karldprice/M_Dsgn/README.txt

M_Dsgn
======

All stock part CAD models in the storck_parts directory.
Name your stock parts [part name]_[website]_[parts number]
No spaces in file or directory names!

eg: ball_bearing_mc_347103438972.sldprt

MC - McMaster 
SP - SmallParts - smallparts.com
DK - Digikey
SI - sdp-si - sdp-si.com
