karldprice/M_Dsgn/Design1/main2.SLDASM

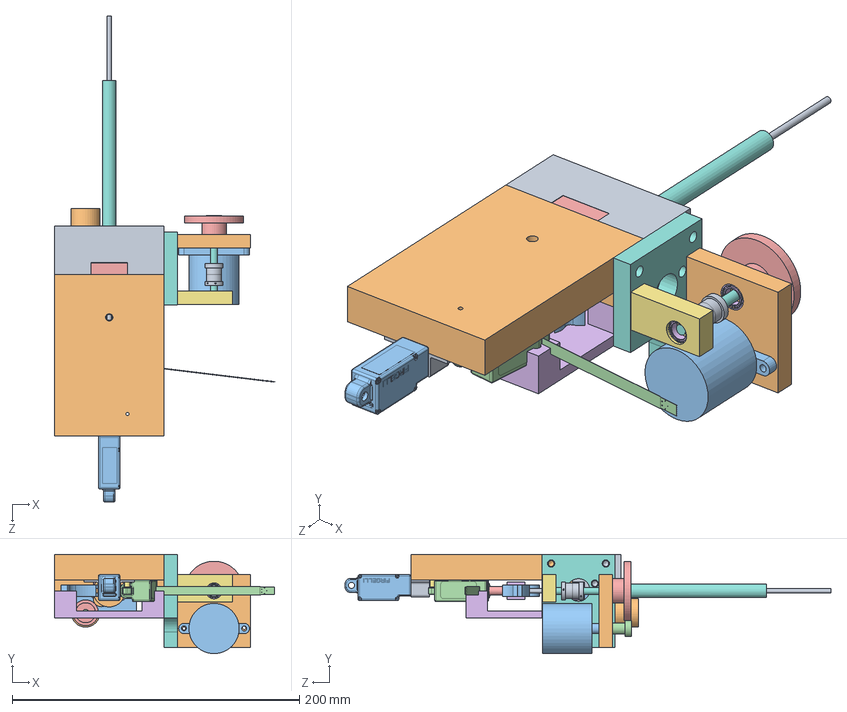
[picture p36: CAD file, 2012-11-09]
Design1/main2.SLDASM
153.2 x 69.1 x 338.4 mm
EnclosureBottom2_tip
EnclosureBottom2-base
needle_toggle_modified
pq-12-20_closed1
pq-12-20_closed2
Pinch_Arm2 x 2
LinActSpacer
ToolShaft
JawShaft
Gearbox
linAct_L12_base
linAct_L12_30mm
ShaftGuide
ShaftGuideTop
ShaftGuidePlate x 2
shaft_of_karl_3
collar_3 x 2
bracket_3
stepper_motor_35mm_DK_P14336-ND
gear_d0_5_SP_32-014B156
gear_d1_688_SP_32-052B313
ball_bearing_05_MC_57155K358 x 2
bracket_short_3
baseplate_3
actBracket
stepper_motor_20mm_DK_P14334-ND
MotorBracket
roll_extension
gear_d0_708_SP_48-034b187
TogglePivotCap
