karldprice/M_Dsgn/Final/Grip/GripperAssem.SLDASM

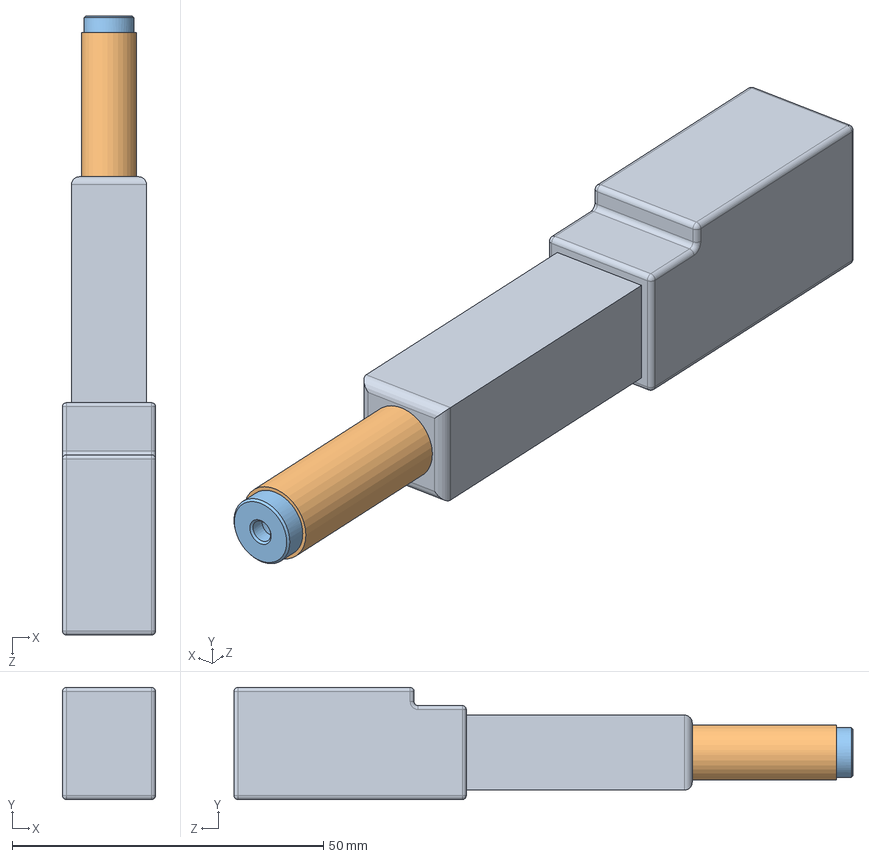
[picture p37: CAD file, 2013-04-07]
Final/Grip/GripperAssem.SLDASM
15.0 x 18.0 x 99.5 mm
L12_linAct_Body
L12_linAct_Shaft
Gripper_thrustFitting
