karldprice/M_Dsgn/Final/Needle/NeedleAssem.SLDASM

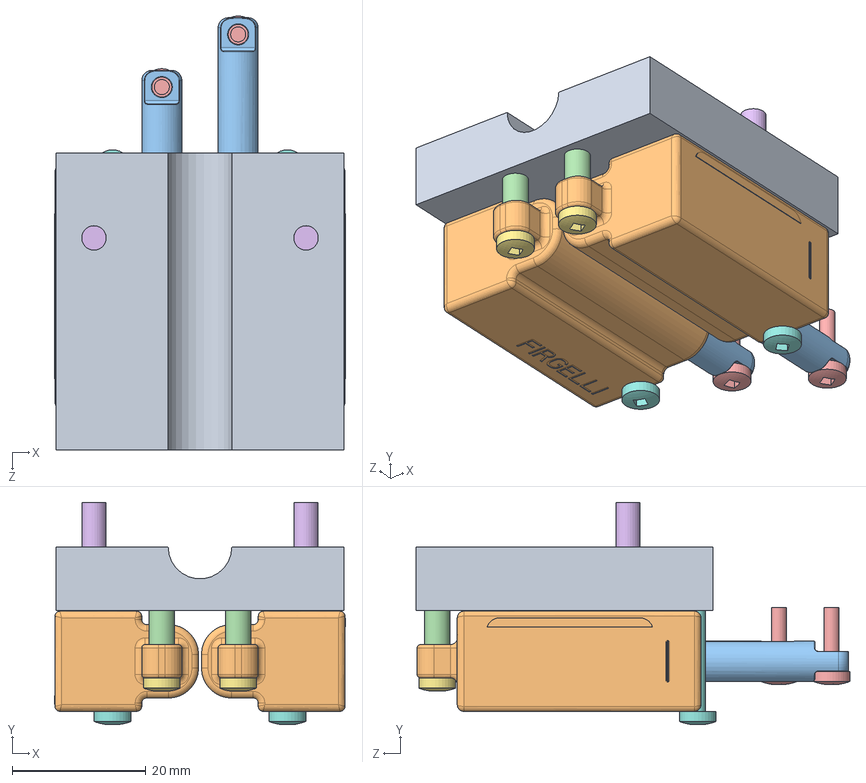
[picture p38: CAD file, 2013-04-07]
Final/Needle/NeedleAssem.SLDASM
43.6 x 33.3 x 65.0 mm
Needle_Block
pq-12-20_closed1 x 2
pq-12-20_closed2 x 2
LinActSpacer x 2
Screw_4-40x0375 x 2
CapScrew_6-32x0500 x 2
Screw_4-40x0625 x 2
Screw_4-40x0750 x 2
