karldprice/M_Dsgn/Final/OuterRoll/OuterRoll_v2.SLDASM

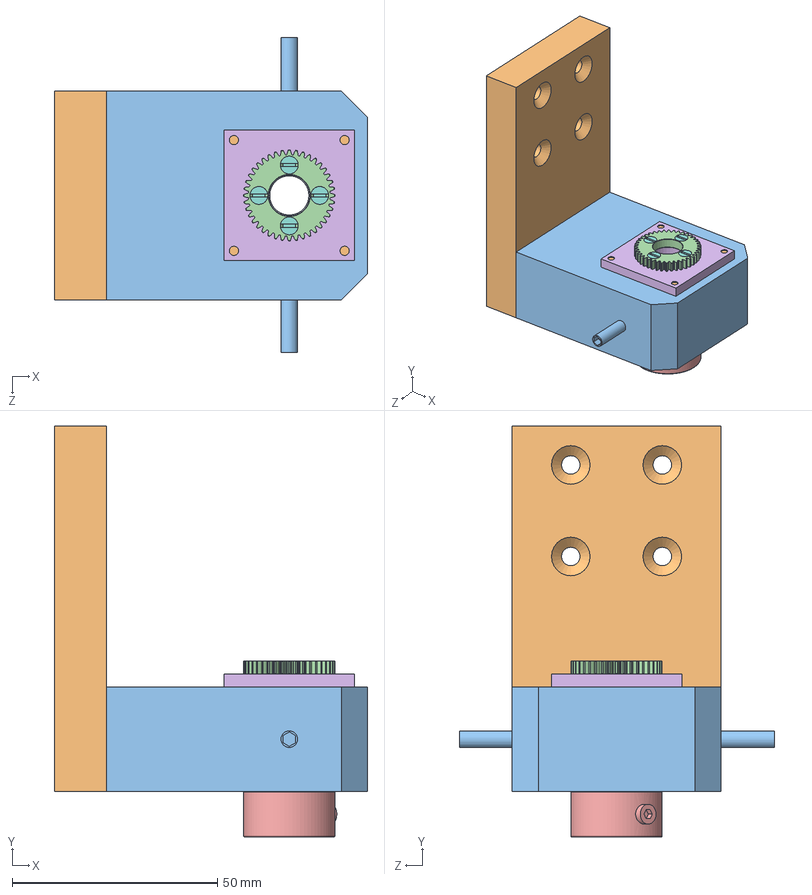
[picture p39: CAD file, 2013-04-07]
Final/OuterRoll/OuterRoll_v2.SLDASM
76.2 x 100.0 x 76.7 mm
DensoMount_Plate
OuterRoll_Base
MOD_gear_sdpi_s1268z-048a040
collar_mc_60475K680
OuterRoll_gearPlate
ball_bearing_mc_6383K160 x 2
FlatScrew_2-56x0250 x 4
CapScrew_10-32x1250 x 3
CapScrew_4-40x1000 x 4
Set_10-32x0750 x 2
