karldprice/M_Dsgn/Final/Pitch/PitchMotorAssem.SLDASM

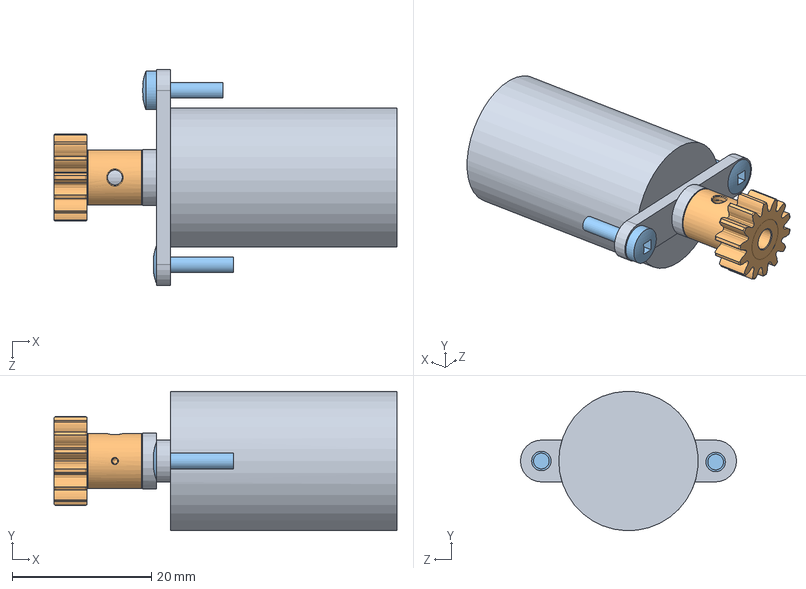
[picture p40: CAD file, 2013-04-07]
Final/Pitch/PitchMotorAssem.SLDASM
49.2 x 20.0 x 31.0 mm
stepper_motor_20mm_DK_P14334-ND
gear_p32-14_SPD-A1T2-Y32014
Screw_4-40x0375 x 2
