karldprice/M_Dsgn/Final/Stack_v2_wMount.SLDASM

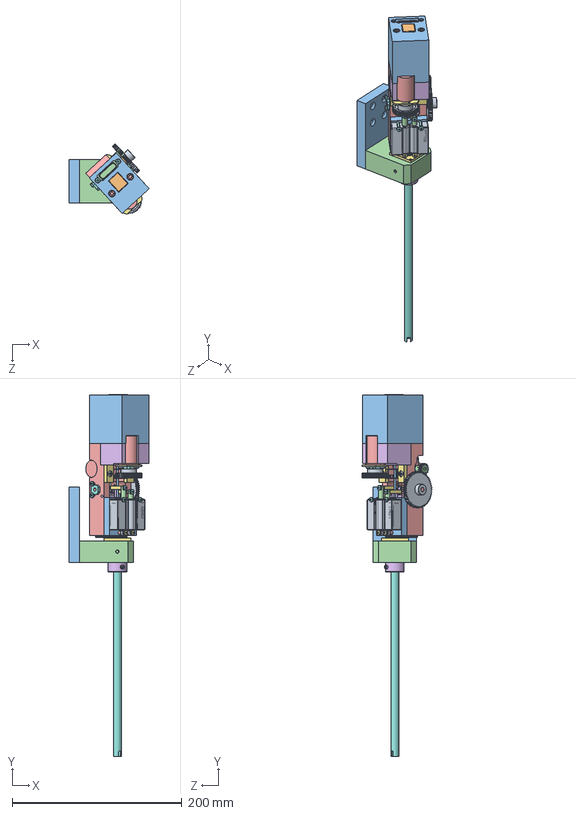
[picture p41: CAD file, 2013-04-07]
Final/Stack_v2_wMount.SLDASM
94.6 x 426.3 x 82.6 mm
DensoMount_Plate
OuterRoll_Base
MOD_gear_sdpi_s1268z-048a040
collar_mc_60475K680
OuterRoll_gearPlate
ball_bearing_mc_6383K160 x 2
FlatScrew_2-56x0250 x 4
CapScrew_10-32x1250 x 3
CapScrew_4-40x1000 x 4
Set_10-32x0750 x 2
EnclosureBottom
Pitch_GuideBar
GearboxBracket x 2
Screw_4-40x0375 x 8
PanScrew_6-32x0375 x 2
PanScrew_6-32x1250 x 2
JawShaft
Gearbox
gearboxGear_m07t16
NeedleControlRod x 2
Needle_Coupler x 2
ssToolShaft
Nut_2-56 x 2
L12_linAct_Body
L12_linAct_Shaft
Gripper_thrustFitting
stepper_motor_20mm_DK_P14334-ND x 3
EnclosureCap
EncoderMounting x 2
RotaryEncoder_237T x 3
gear_m07-42_a-1m-2myz07042
Set_4-40x0125 x 7
Screw_4-40x0500 x 2
gear_p32-14_SPD-A1T2-Y32014
Pitch_Shaft
Pitch_Spool x 2
Ball_Bearing_AXA1221 x 2
Pitch_Collar
gear_p32-52_SPD-S1084Z-032DS052
Pitch_GearSpacer
Needle_Block
pq-12-20_closed1 x 2
pq-12-20_closed2 x 2
LinActSpacer x 2
CapScrew_6-32x0500 x 2
Screw_4-40x0625 x 2
Screw_4-40x0750 x 2
gear_sdpi_s1063z-048a040
Screw_4-40x0250 x 2
WireCap
hdmi_WM5715-ND
CapScrew_8-32x2250 x 2
