karldprice/M_Dsgn/Final/StockParts/Motors/L12_linAct.SLDASM

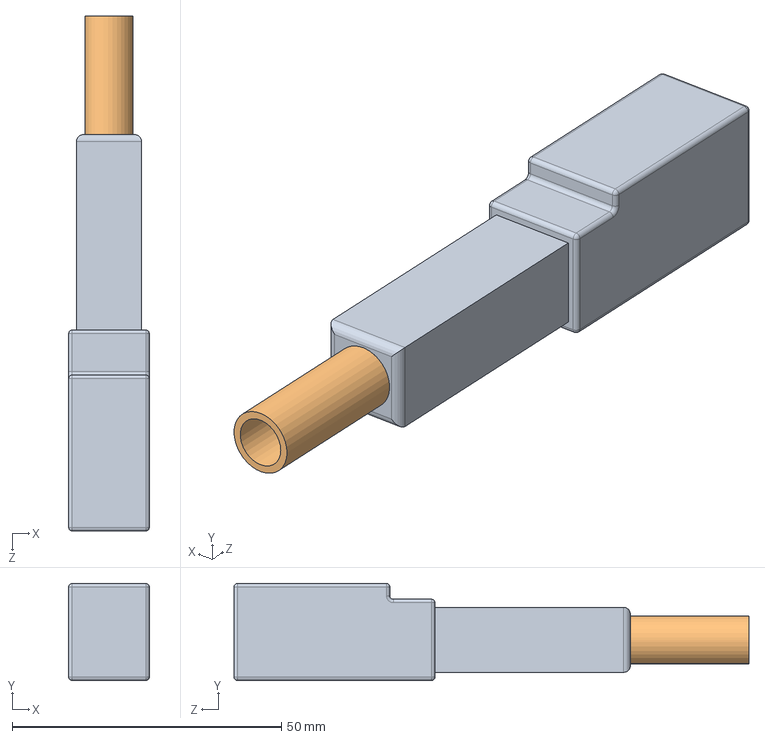
[picture p42: CAD file, 2013-04-07]
Final/StockParts/Motors/L12_linAct.SLDASM
15.0 x 18.0 x 95.7 mm
L12_linAct_Body
L12_linAct_Shaft
