karldprice/M_Dsgn/Final/Tool/ToolShaft.SLDASM

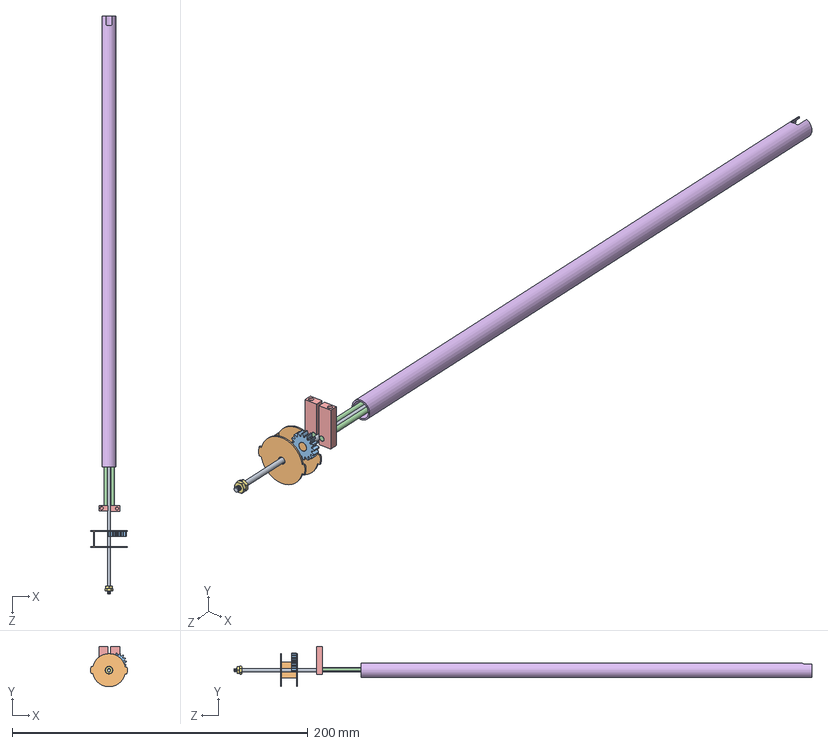
[picture p43: CAD file, 2013-04-07]
Final/Tool/ToolShaft.SLDASM
24.9 x 27.4 x 390.8 mm
JawShaft
Gearbox
gearboxGear_m07t16
NeedleControlRod x 2
Needle_Coupler x 2
ssToolShaft
Nut_2-56 x 2
