karldprice/M_Dsgn/Final/WireCap/WireCapAssem.SLDASM

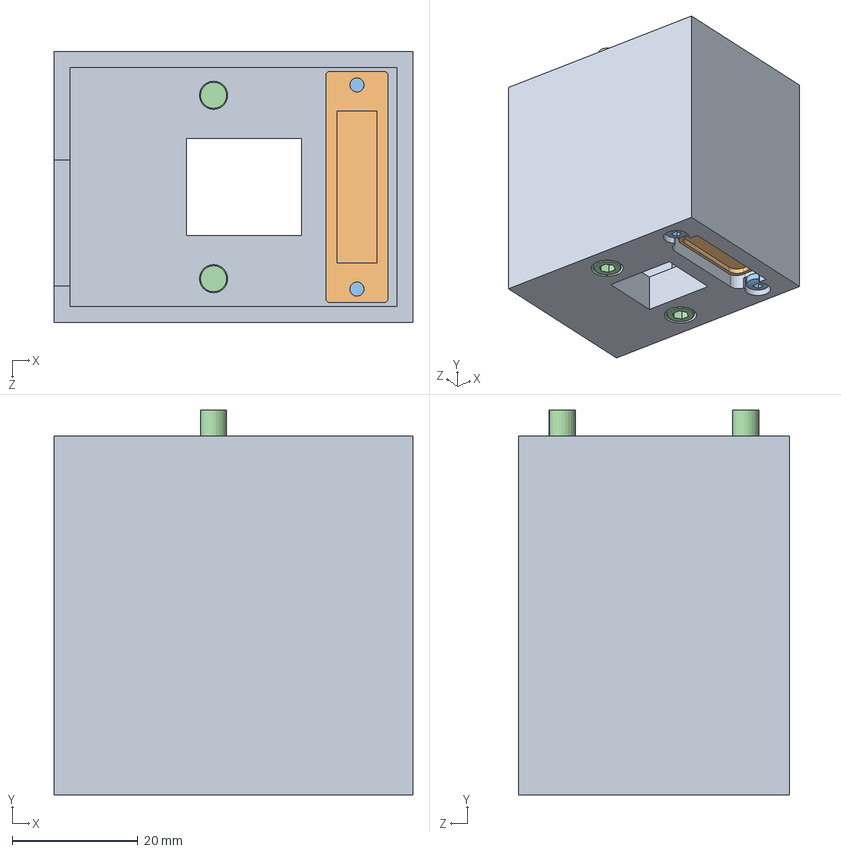
[picture p44: CAD file, 2013-04-07]
Final/WireCap/WireCapAssem.SLDASM
57.1 x 61.3 x 43.2 mm
WireCap
hdmi_WM5715-ND
Screw_4-40x0375 x 2
CapScrew_8-32x2250 x 2
