karldprice/M_Dsgn/Stack_v2/BodyPitch/BodyPitchAssem.SLDASM

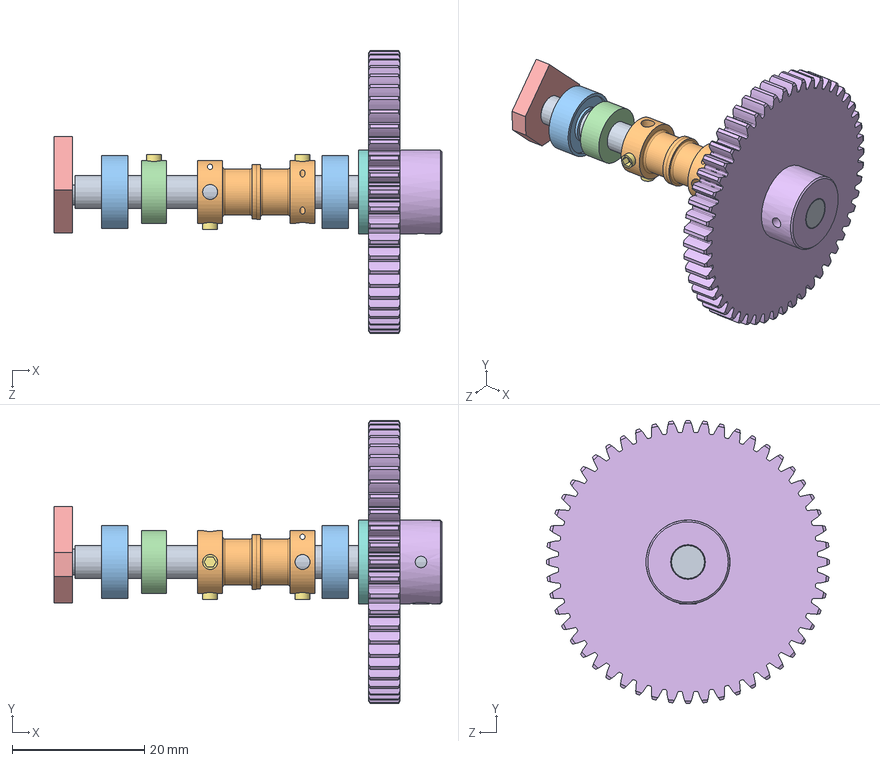
[picture p45: CAD file, 2013-02-25]
Stack_v2/BodyPitch/BodyPitchAssem.SLDASM
58.7 x 42.9 x 42.9 mm
pitchShaft
pitchCollar x 2
Ball_Bearing_AXA1221 x 2
pitchRetainer
RotaryEncoder_237T
gear_p32-52_SPD-S1084Z-032DS052
Set_4-40x0125 x 5
PitchSpacer
