karldprice/M_Dsgn/Stack_v2/Grip/GripperAssem.SLDASM

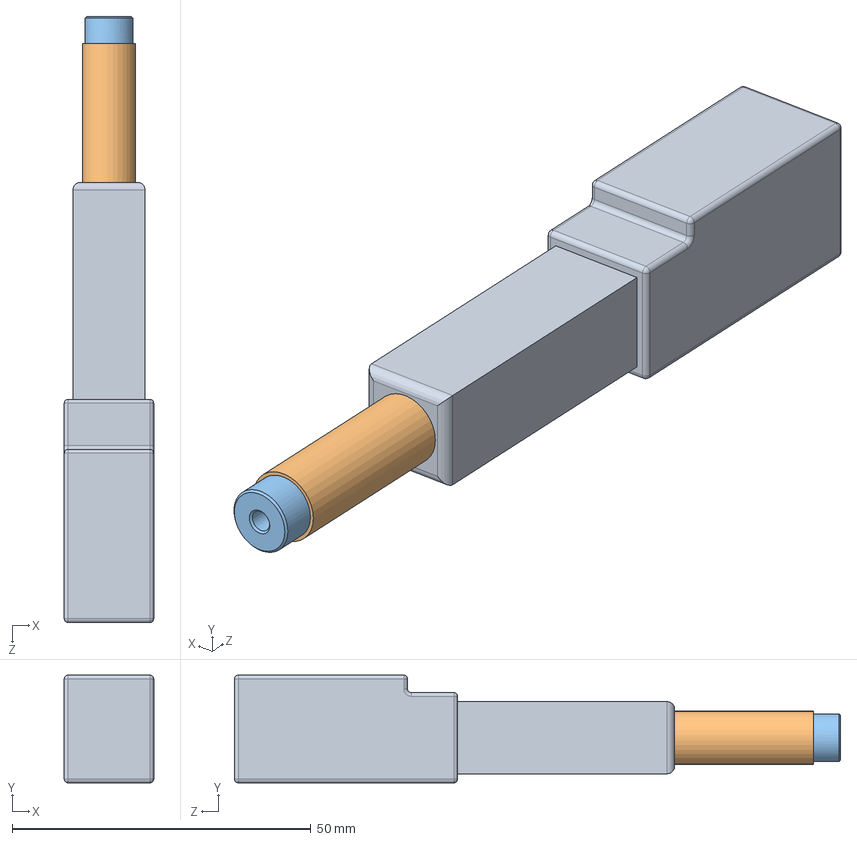
[picture p46: CAD file, 2013-02-13]
Stack_v2/Grip/GripperAssem.SLDASM
15.0 x 18.0 x 101.4 mm
L12_linAct_Body_cust
L12_linAct_Shaft_cust
actFitting_thrust
