karldprice/M_Dsgn/Stack_v2/Needle/ToggleActuators.SLDASM

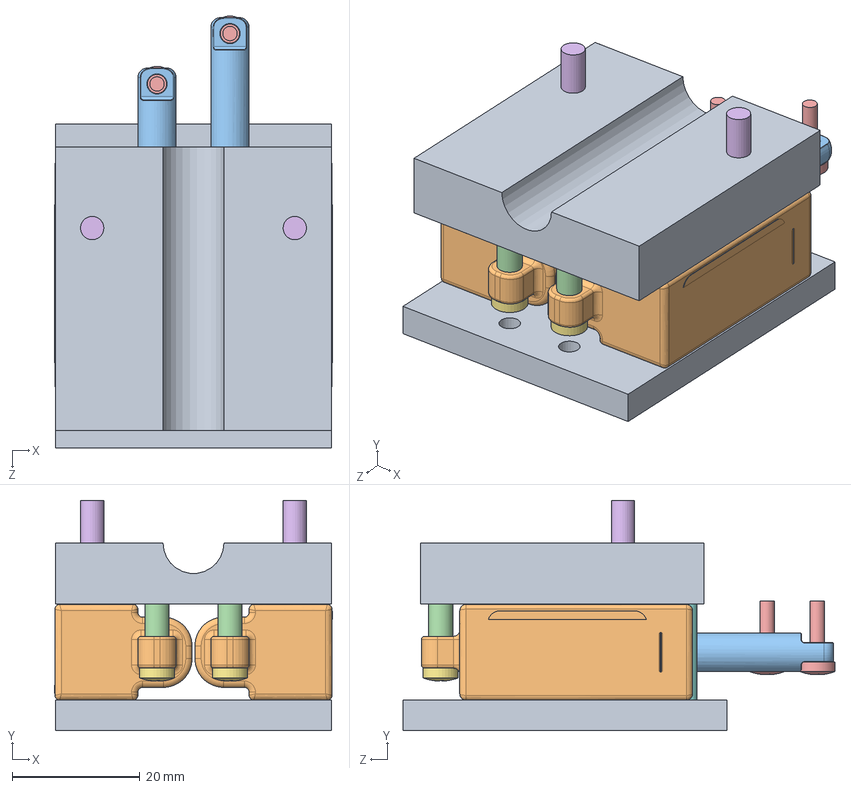
[picture p47: CAD file, 2013-02-14]
Stack_v2/Needle/ToggleActuators.SLDASM
43.6 x 36.0 x 67.7 mm
LinActBlock
pq-12-20_closed1 x 2
pq-12-20_closed2 x 2
LinActSpacer x 2
Screw_4-40x0375 x 2
CapScrew_6-32x0500 x 2
Screw_4-40x0625 x 2
Screw_4-40x0750 x 2
LinActCover
