karldprice/M_Dsgn/Stock_Parts/LinActs/linear_actuator_RS_pq-12-20.SLDASM

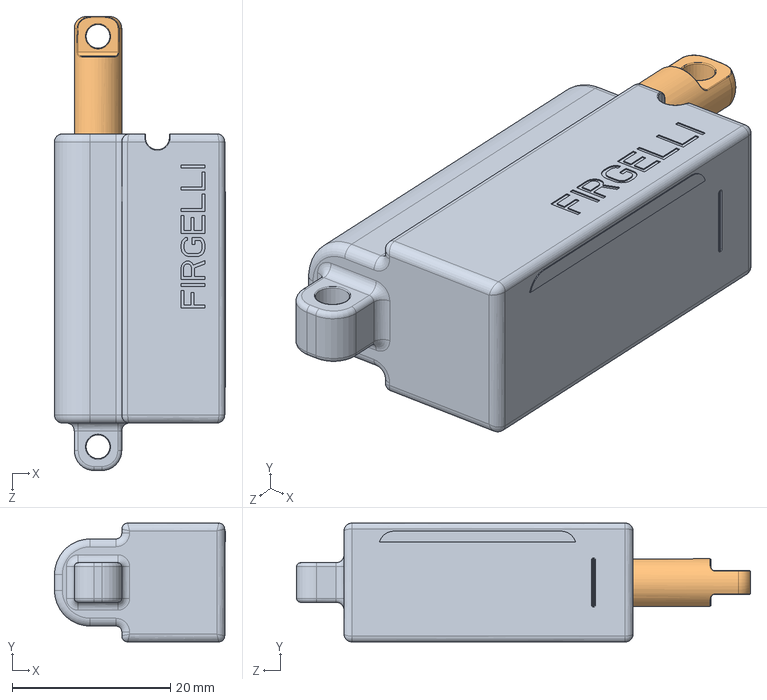
[picture p48: CAD file, 2013-02-03]
Stock_Parts/LinActs/linear_actuator_RS_pq-12-20.SLDASM
21.6 x 15.0 x 57.3 mm
pq-12-20_closed1
pq-12-20_closed2
