karldprice/M_Dsgn/Final/OuterRoll/OuterRollMotor.SLDASM

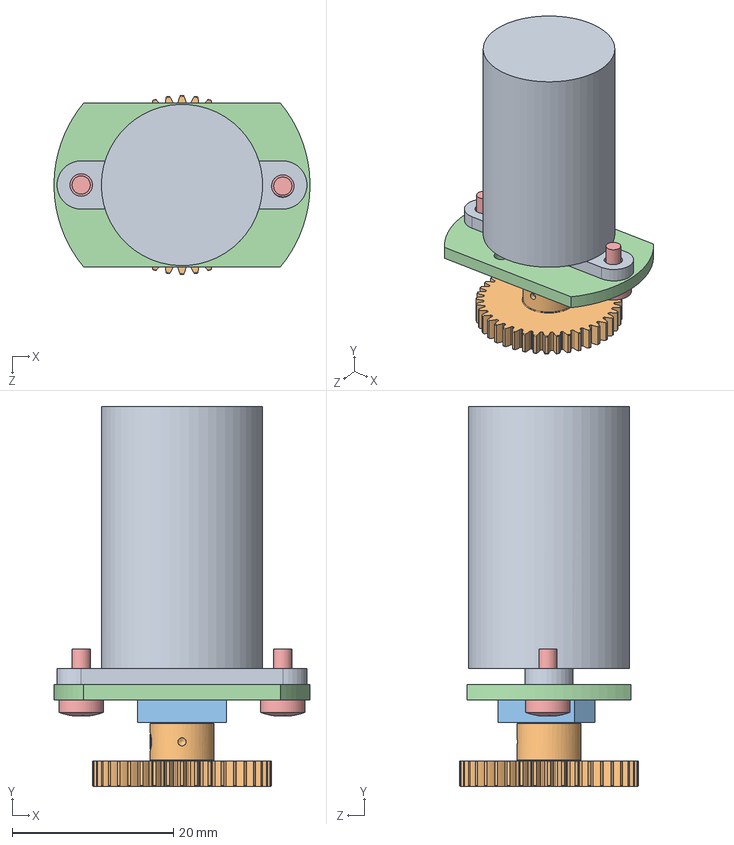
[picture p49: CAD file, 2013-04-07]
Final/OuterRoll/OuterRollMotor.SLDASM
31.7 x 47.1 x 22.2 mm
stepper_motor_20mm_DK_P14334-ND
gear_sdpi_s1063z-048a040
RotaryEncoder_237T
EncoderMounting
Screw_4-40x0250 x 2
