karldprice/M_Dsgn/Final/Roll/WristRoll.SLDASM

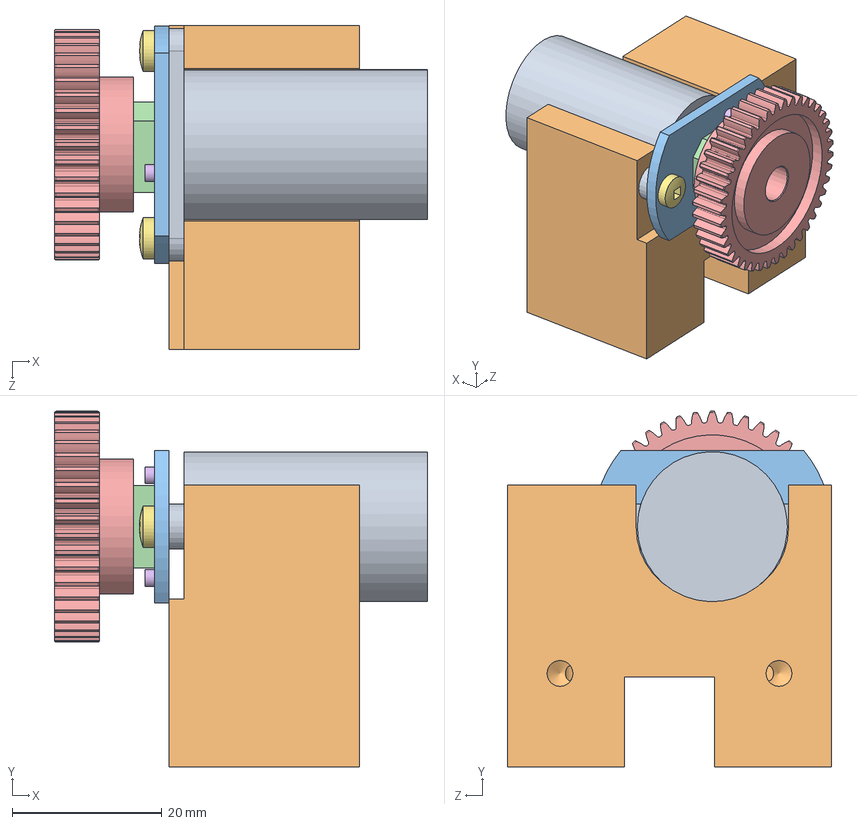
[picture p50: CAD file, 2013-04-07]
Final/Roll/WristRoll.SLDASM
49.7 x 47.4 x 43.2 mm
stepper_motor_20mm_DK_P14334-ND
EnclosureCap
EncoderMounting
RotaryEncoder_237T
gear_m07-42_a-1m-2myz07042
Set_4-40x0125 x 2
Screw_4-40x0500 x 2
