karldprice/M_Dsgn/Final/Stack_v2.SLDASM

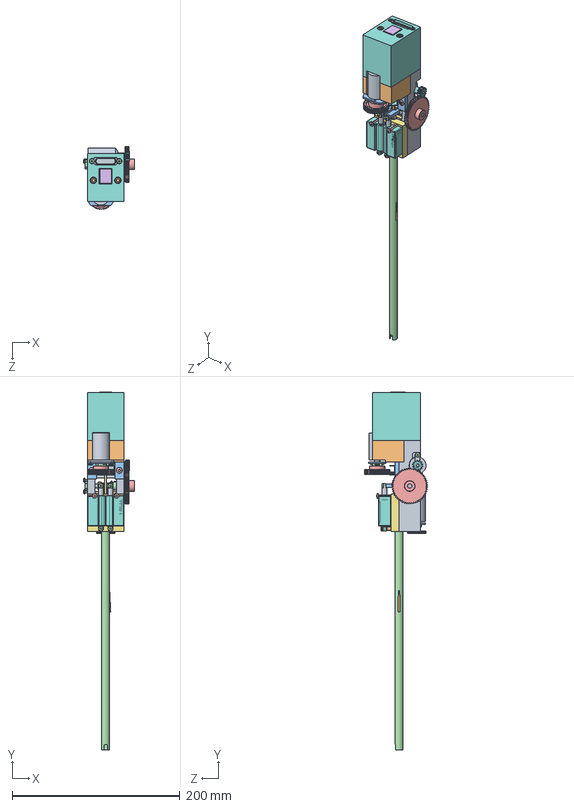
[picture p51: CAD file, 2013-04-07]
Final/Stack_v2.SLDASM
60.7 x 426.3 x 75.5 mm
EnclosureBottom
Pitch_GuideBar
GearboxBracket x 2
Screw_4-40x0375 x 8
PanScrew_6-32x0375 x 2
PanScrew_6-32x1250 x 2
JawShaft
Gearbox
gearboxGear_m07t16
NeedleControlRod x 2
Needle_Coupler x 2
ssToolShaft
Nut_2-56 x 2
L12_linAct_Body
L12_linAct_Shaft
Gripper_thrustFitting
stepper_motor_20mm_DK_P14334-ND x 3
EnclosureCap
EncoderMounting x 2
RotaryEncoder_237T x 3
gear_m07-42_a-1m-2myz07042
Set_4-40x0125 x 7
Screw_4-40x0500 x 2
gear_p32-14_SPD-A1T2-Y32014
Pitch_Shaft
Pitch_Spool x 2
Ball_Bearing_AXA1221 x 2
Pitch_Collar
gear_p32-52_SPD-S1084Z-032DS052
Pitch_GearSpacer
Needle_Block
pq-12-20_closed1 x 2
pq-12-20_closed2 x 2
LinActSpacer x 2
CapScrew_6-32x0500 x 2
Screw_4-40x0625 x 2
Screw_4-40x0750 x 2
gear_sdpi_s1063z-048a040
Screw_4-40x0250 x 2
WireCap
hdmi_WM5715-ND
CapScrew_8-32x2250 x 2
