karldprice/M_Dsgn/Final/Tool/GearBoxAssem.SLDASM

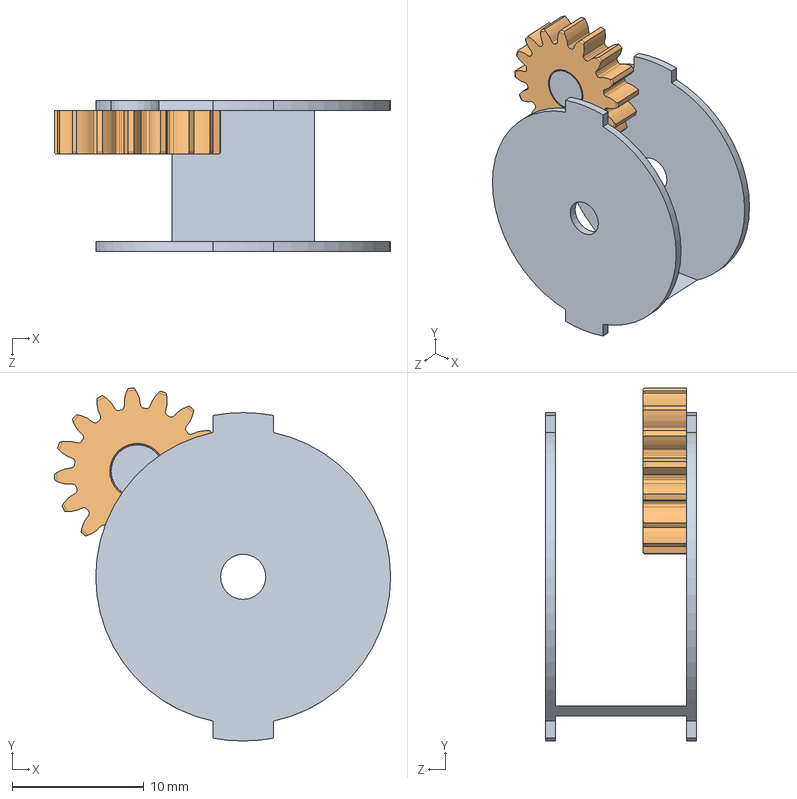
[picture p52: CAD file, 2013-04-07]
Final/Tool/GearBoxAssem.SLDASM
25.5 x 26.8 x 11.4 mm
Gearbox
gearboxGear_m07t16
