karldprice/M_Dsgn/Stock_Parts/LinActs/linAct_L12.SLDASM

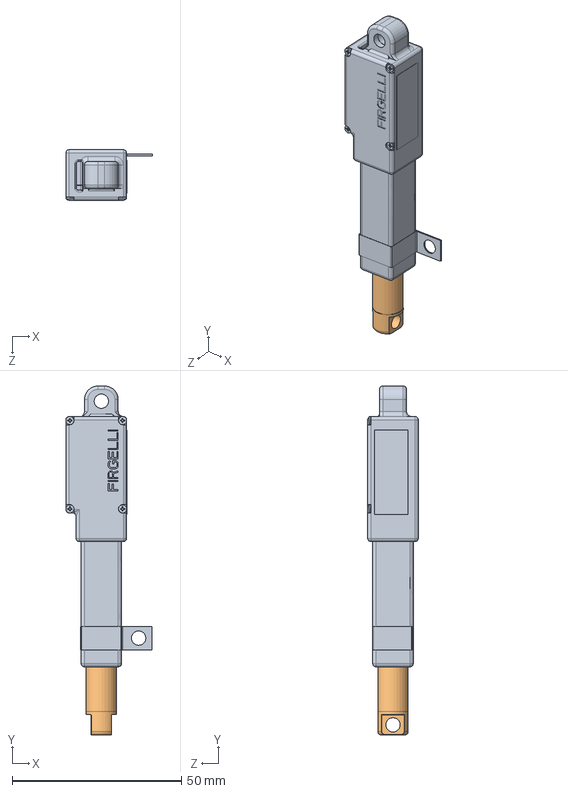
[picture p53: CAD file, 2012-11-08]
Stock_Parts/LinActs/linAct_L12.SLDASM
25.5 x 103.1 x 15.0 mm
linAct_L12_base
linAct_L12_30mm
