karldprice/M_Dsgn/Final/Tool/BaseAssem.SLDASM

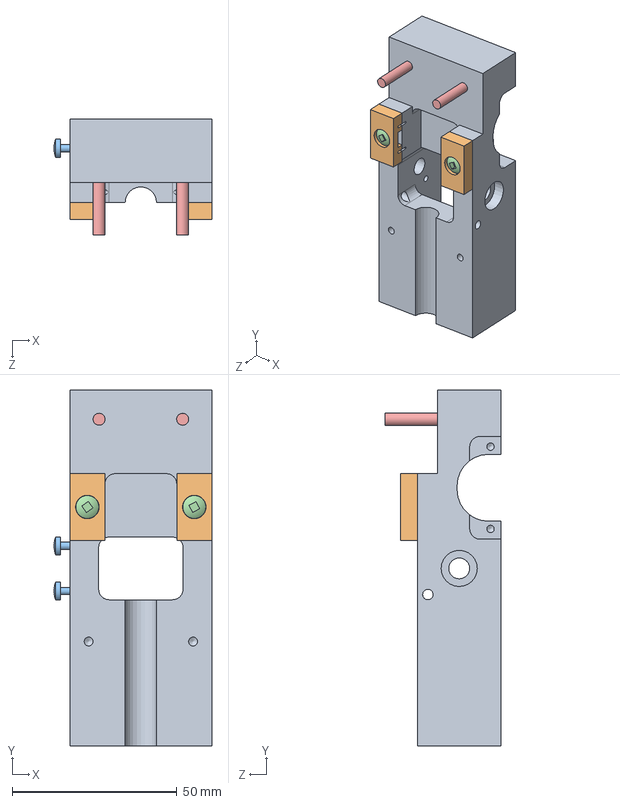
[picture p54: CAD file, 2013-04-07]
Final/Tool/BaseAssem.SLDASM
48.0 x 108.2 x 35.3 mm
EnclosureBottom
GearboxBracket x 2
Screw_4-40x0375 x 2
PanScrew_6-32x0375 x 2
PanScrew_6-32x1250 x 2
