karldprice/M_Dsgn/Final/Roll/GearboxBracket.SLDPRT

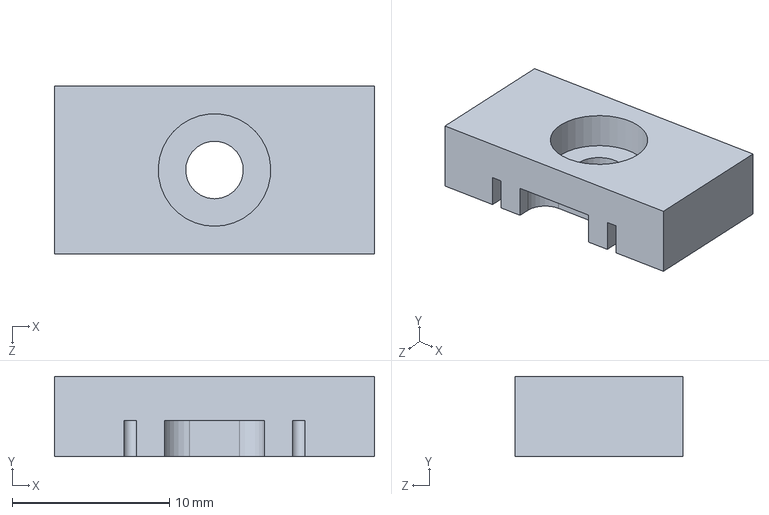
[picture p55: CAD file, 2013-04-07]
Final/Roll/GearboxBracket.SLDPRT
20.3 x 5.08 x 10.7 mm
