karldprice/M_Dsgn/Final/StockParts/BallBearings/collar_mc_60475K680.SLDPRT

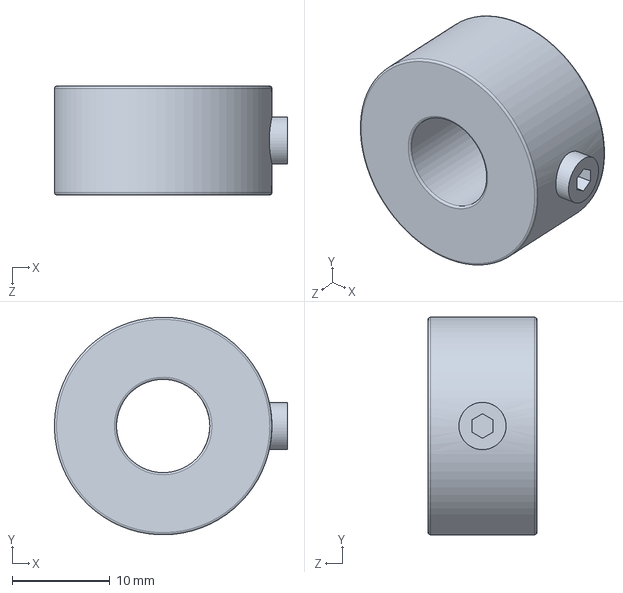
[picture p56: CAD file, 2013-04-07]
Final/StockParts/BallBearings/collar_mc_60475K680.SLDPRT
23.8 x 22.2 x 11.1 mm
