karldprice/M_Dsgn/Final/StockParts/electronics/hdmi_WM5715-ND.SLDPRT

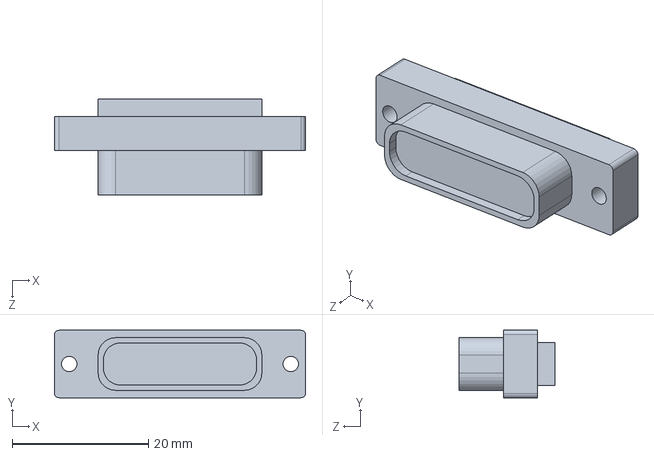
[picture p57: CAD file, 2013-02-14]
Final/StockParts/electronics/hdmi_WM5715-ND.SLDPRT
36.8 x 9.91 x 14.0 mm
