karldprice/M_Dsgn/Final/StockParts/Gears/MOD_gear_sdpi_s1268z-048a040.SLDPRT

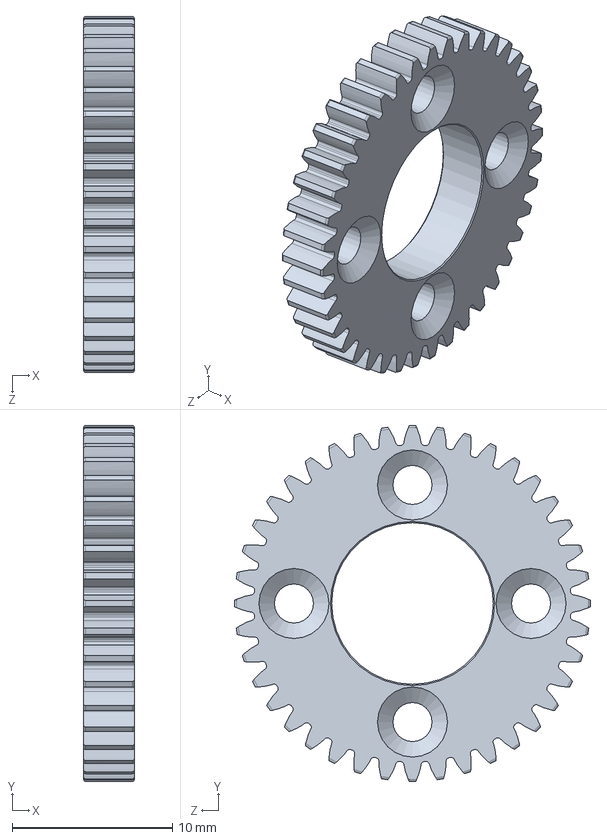
[picture p58: CAD file, 2013-03-04]
Final/StockParts/Gears/MOD_gear_sdpi_s1268z-048a040.SLDPRT
3.17 x 22.2 x 22.2 mm
