karldprice/M_Dsgn/Final/StockParts/Motors/linear_actuator_RS_pq_12-20_sub_parts/pq-12-20_closed1.sldprt

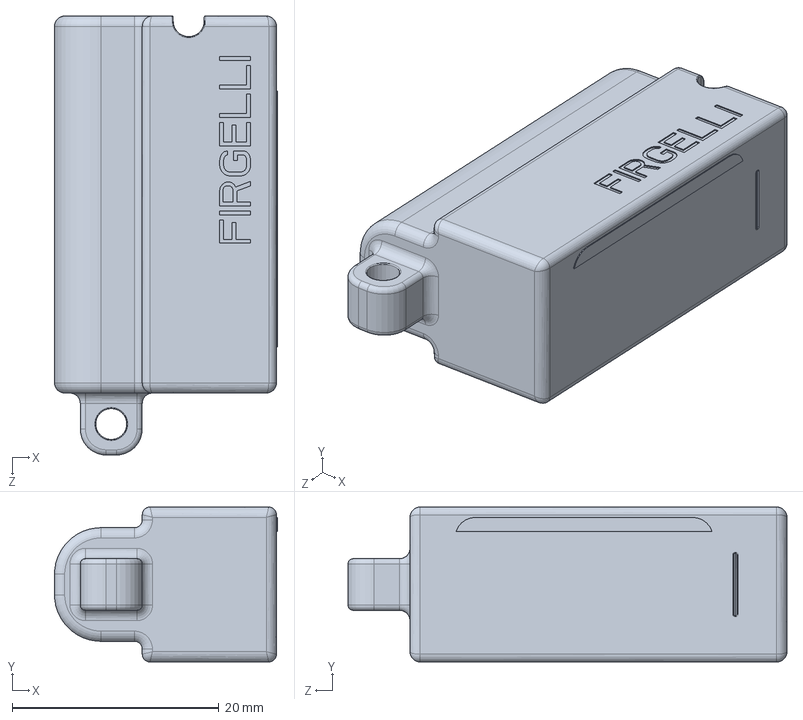
[picture p59: CAD file, 2013-04-07]
Final/StockParts/Motors/linear_actuator_RS_pq_12-20_sub_parts/pq-12-20_closed1.sldprt
21.6 x 15.0 x 42.5 mm
