karldprice/M_Dsgn/Stack_v2/OuterRoll_v2/Roll2_Mount.SLDPRT

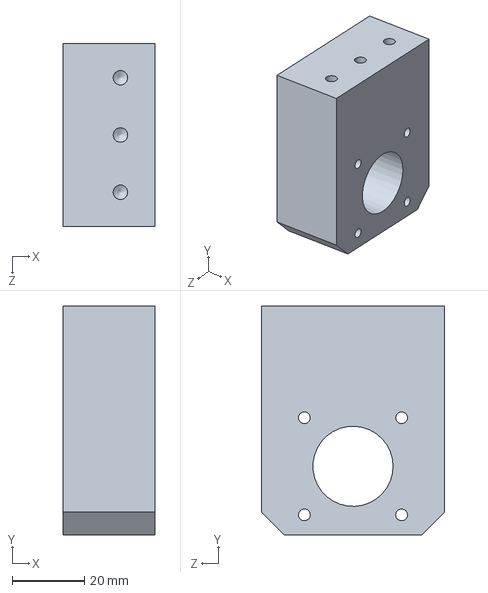
[picture p60: CAD file, 2013-03-04]
Stack_v2/OuterRoll_v2/Roll2_Mount.SLDPRT
25.4 x 63.5 x 50.8 mm
