karldprice/M_Dsgn/Stack_v2/Tool/EnclosureBottom3_CNC.SLDPRT

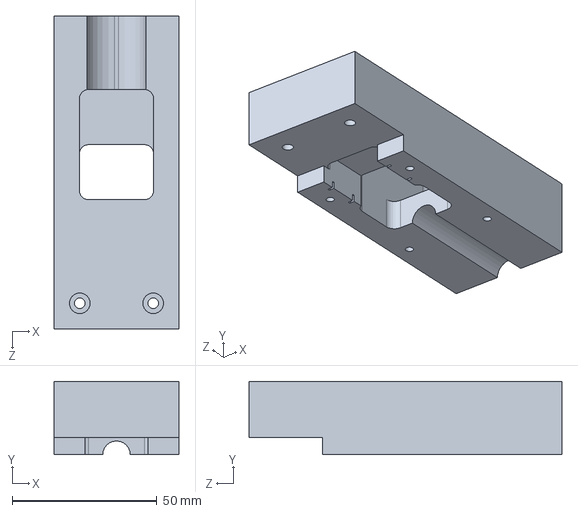
[picture p61: CAD file, 2013-02-15]
Stack_v2/Tool/EnclosureBottom3_CNC.SLDPRT
43.2 x 25.4 x 108.2 mm
