karldprice/M_Dsgn/Stock_Parts/BallBearings/ball_bearing_mc_5972K164.SLDPRT

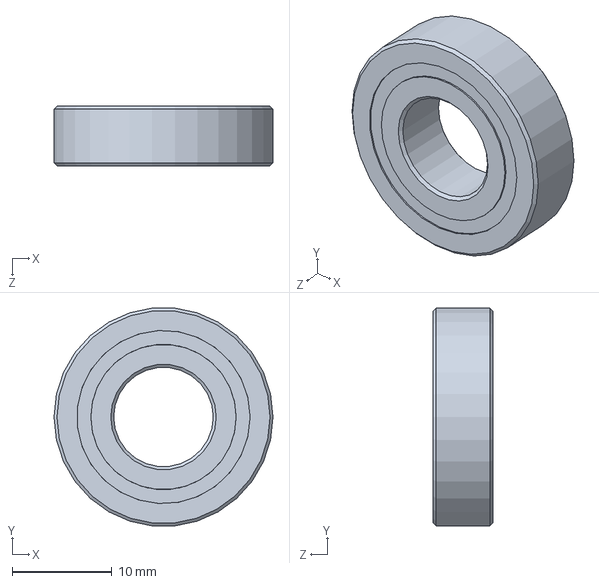
[picture p62: CAD file, 2013-02-11]
Stock_Parts/BallBearings/ball_bearing_mc_5972K164.SLDPRT
22.0 x 21.9 x 6.00 mm
