karldprice/M_Dsgn/Stock_Parts/electronics/36pos_D_Centronics_1036MA-ND.SLDPRT

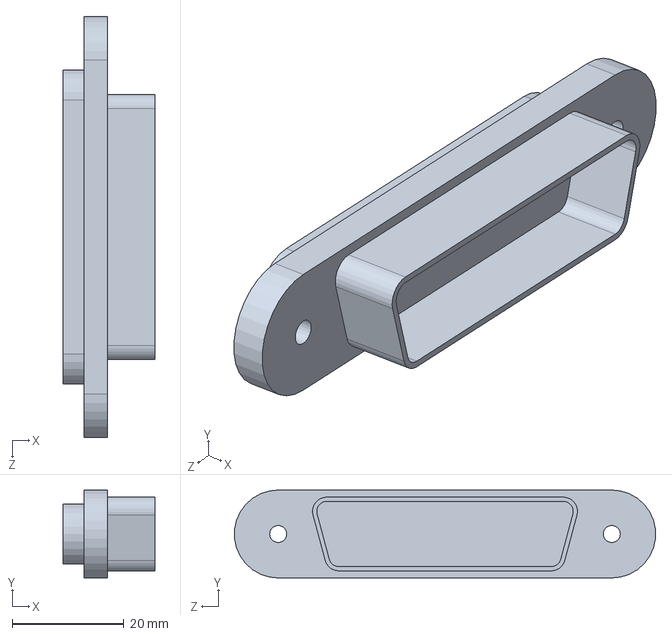
[picture p63: CAD file, 2013-02-14]
Stock_Parts/electronics/36pos_D_Centronics_1036MA-ND.SLDPRT
16.6 x 15.7 x 75.4 mm
