karldprice/M_Dsgn/Stock_Parts/Gears/gear_m07-22_SPD-A-1M-2MYZ07022.SLDPRT

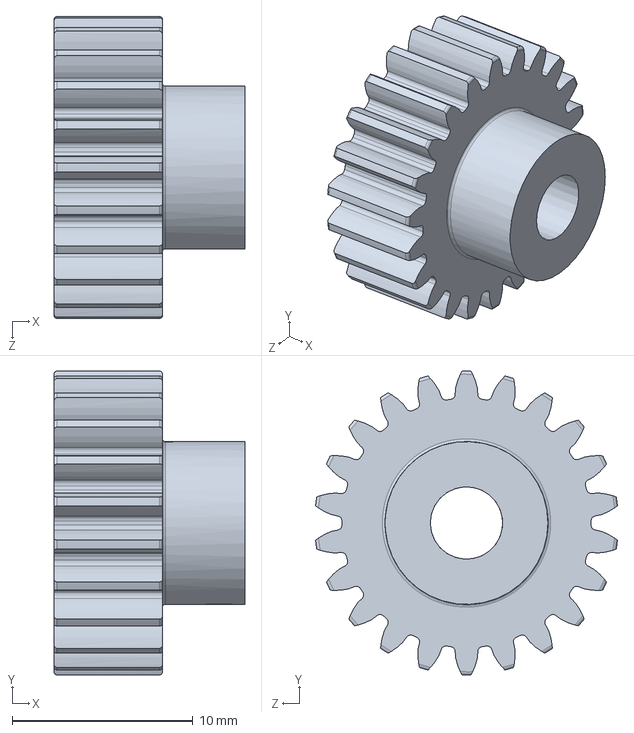
[picture p64: CAD file, 2013-02-14]
Stock_Parts/Gears/gear_m07-22_SPD-A-1M-2MYZ07022.SLDPRT
10.6 x 16.8 x 16.7 mm
