karldprice/M_Dsgn/Stock_Parts/Gears/gear_sdpi-A_1P_2MY04055/a_1p_2my04055.stp

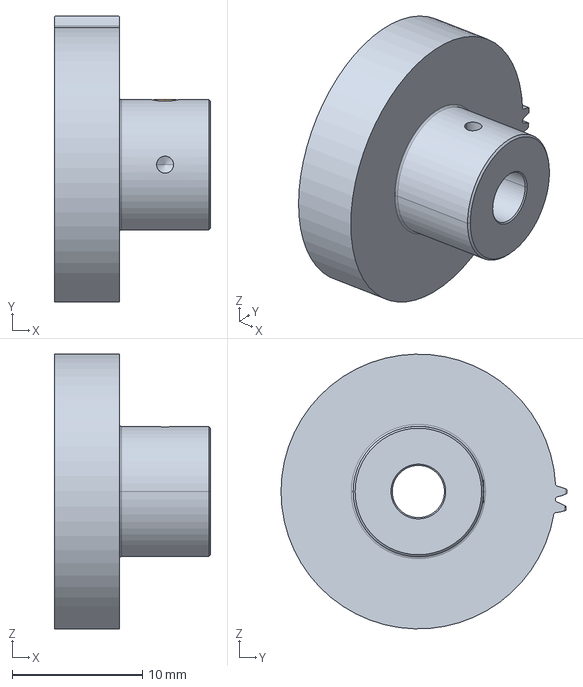
[picture p65: CAD file, 2013-02-11]
Stock_Parts/Gears/gear_sdpi-A_1P_2MY04055/a_1p_2my04055.stp
12.0 x 21.9 x 21.1 mm
