karldprice/M_Dsgn/Stock_Parts/Gears/Outter_Roll_v2/62323/s1063z-048a040.stp

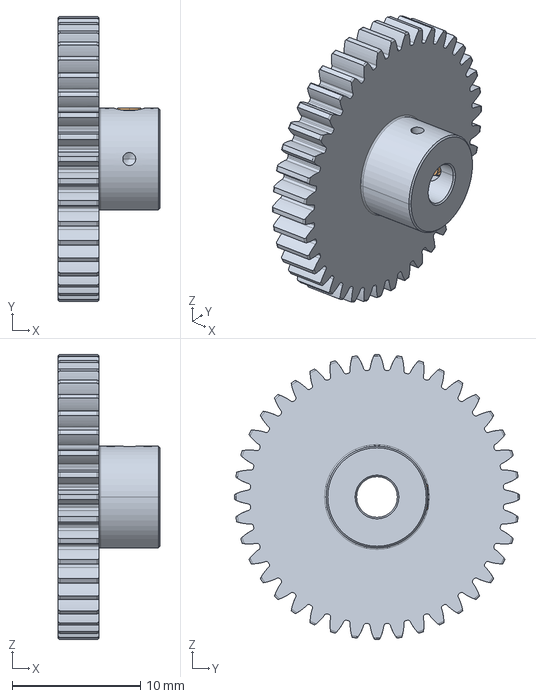
[picture p66: CAD file, 2013-02-12]
Stock_Parts/Gears/Outter_Roll_v2/62323/s1063z-048a040.stp
7.92 x 22.2 x 22.2 mm
