karldprice/M_Dsgn/Stock_Parts/LinActs/linear_actuator_RS_pq_12-20_sub_parts/pq-12-20_closed.sldprt

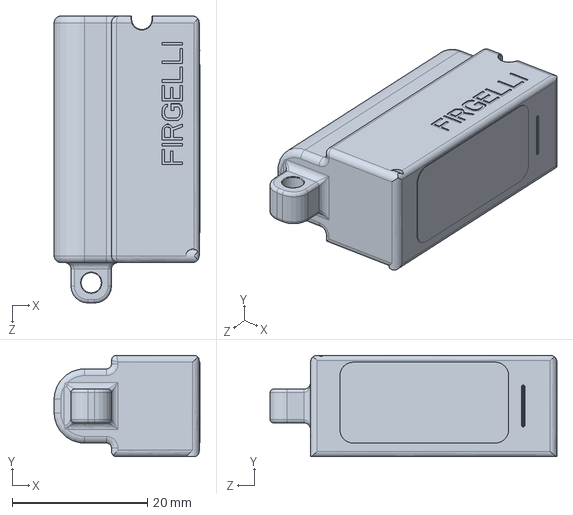
[picture p67: CAD file, 2013-02-03]
Stock_Parts/LinActs/linear_actuator_RS_pq_12-20_sub_parts/pq-12-20_closed.sldprt
21.6 x 15.0 x 42.5 mm
