karldprice/M_Dsgn/Stock_Parts/stand_off_0210-440-93505A462.SLDPRT

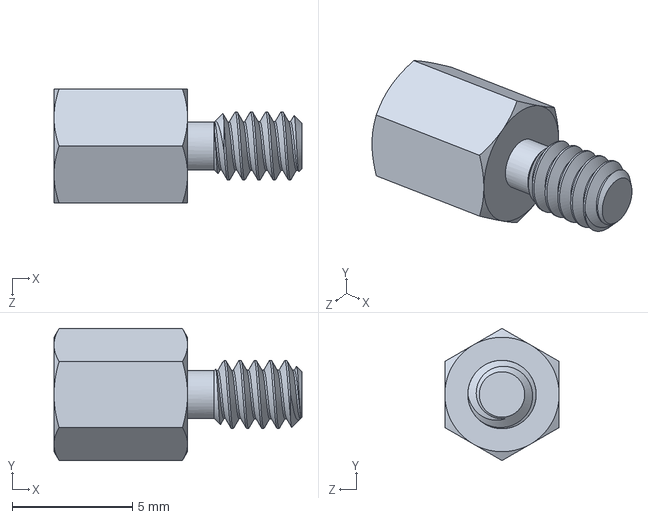
[picture p68: CAD file, 2013-01-18]
Stock_Parts/stand_off_0210-440-93505A462.SLDPRT
10.3 x 5.50 x 4.76 mm
