karldprice/M_Dsgn/Final/Grip/Gripper_thrustFitting.SLDPRT

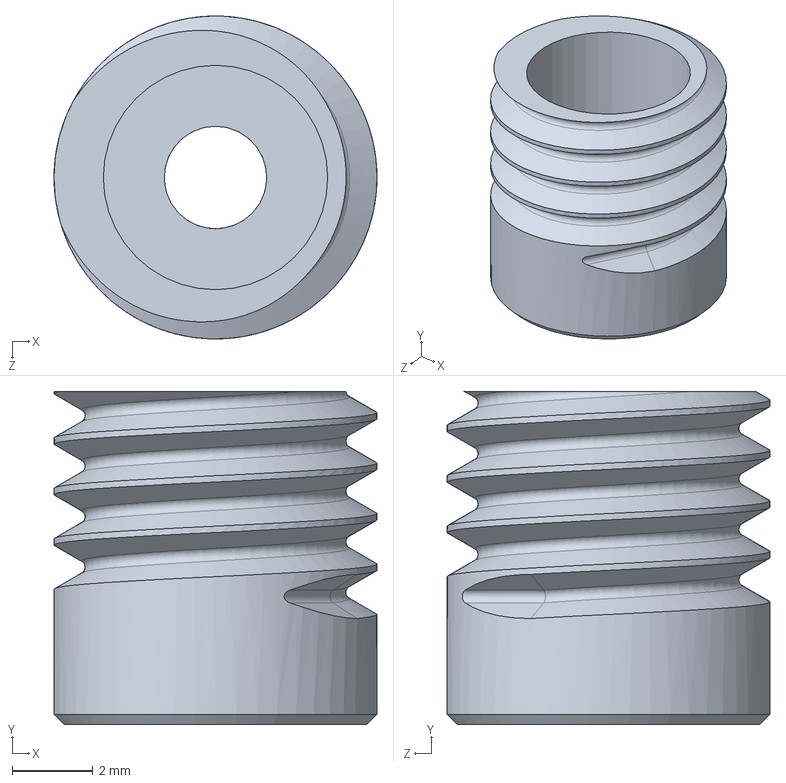
[picture p69: CAD file, 2013-02-12]
Final/Grip/Gripper_thrustFitting.SLDPRT
8.00 x 8.26 x 8.00 mm
