karldprice/M_Dsgn/Final/Needle/Needle_Block.SLDPRT

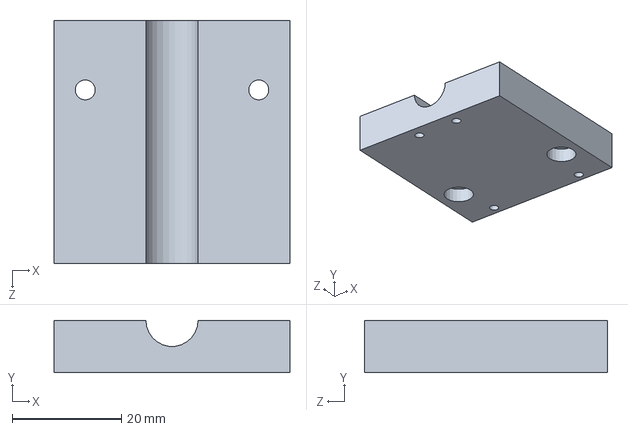
[picture p70: CAD file, 2013-04-07]
Final/Needle/Needle_Block.SLDPRT
43.2 x 9.53 x 44.5 mm
