karldprice/M_Dsgn/Final/StockParts/BallBearings/ball_bearing_mc_6383K160.SLDPRT

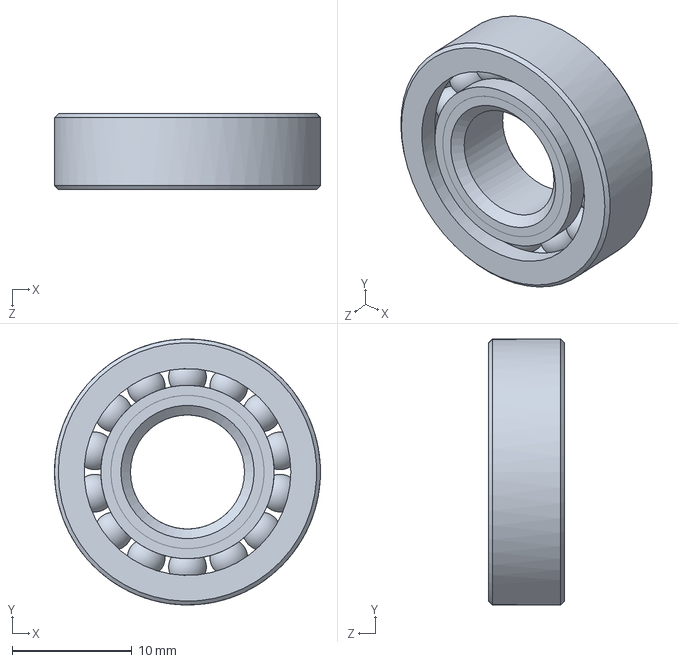
[picture p71: CAD file, 2013-04-07]
Final/StockParts/BallBearings/ball_bearing_mc_6383K160.SLDPRT
22.2 x 22.2 x 6.35 mm
