karldprice/M_Dsgn/Final/StockParts/electronics/RotaryEncoder_237T.SLDPRT

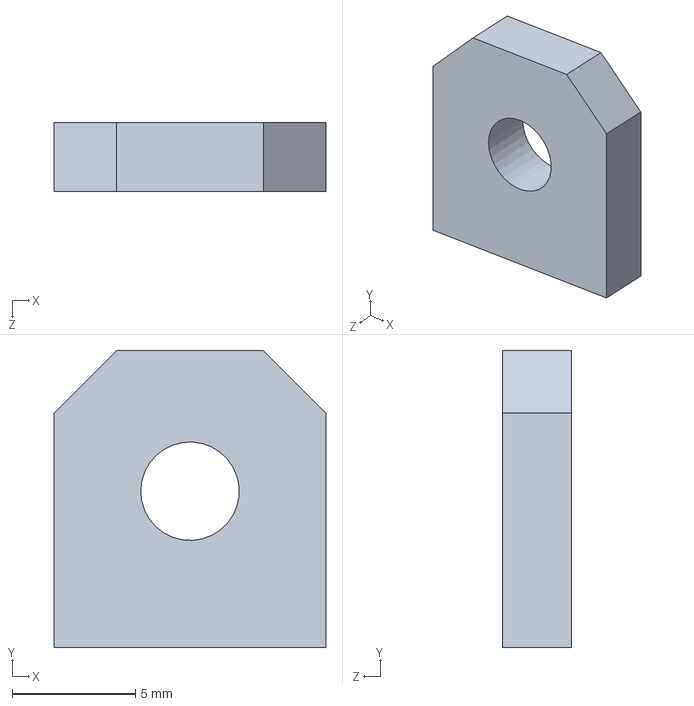
[picture p72: CAD file, 2013-02-14]
Final/StockParts/electronics/RotaryEncoder_237T.SLDPRT
11.0 x 12.1 x 2.79 mm
