karldprice/M_Dsgn/Final/StockParts/Motors/linear_actuator_RS_pq_12-20_sub_parts/pq-12-20_closed2.sldprt

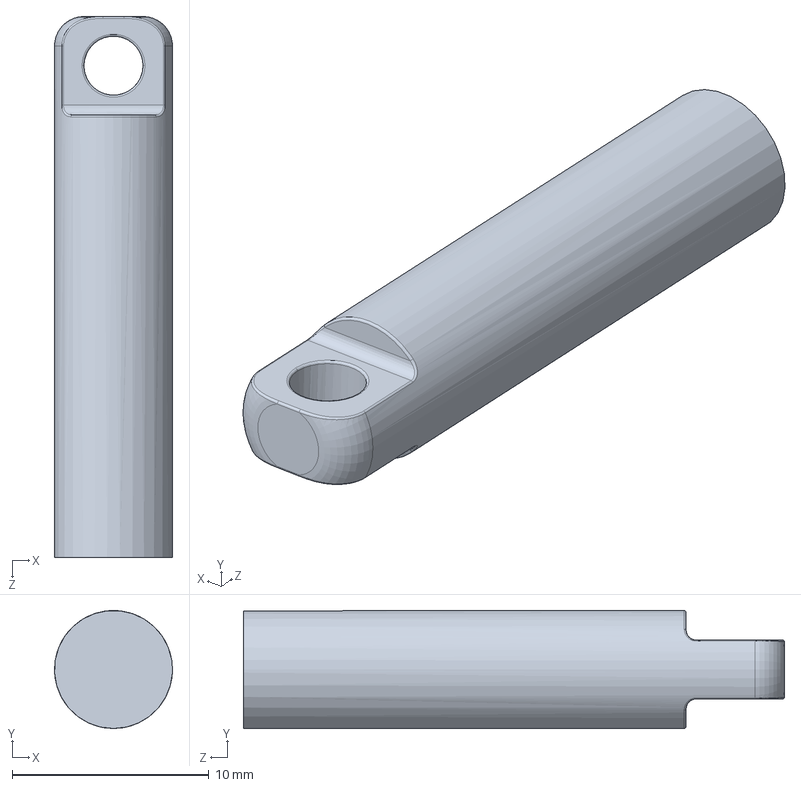
[picture p73: CAD file, 2012-10-18]
Final/StockParts/Motors/linear_actuator_RS_pq_12-20_sub_parts/pq-12-20_closed2.sldprt
6.00 x 6.00 x 27.5 mm
