karldprice/M_Dsgn/Final/WireCap/WireCap.SLDPRT

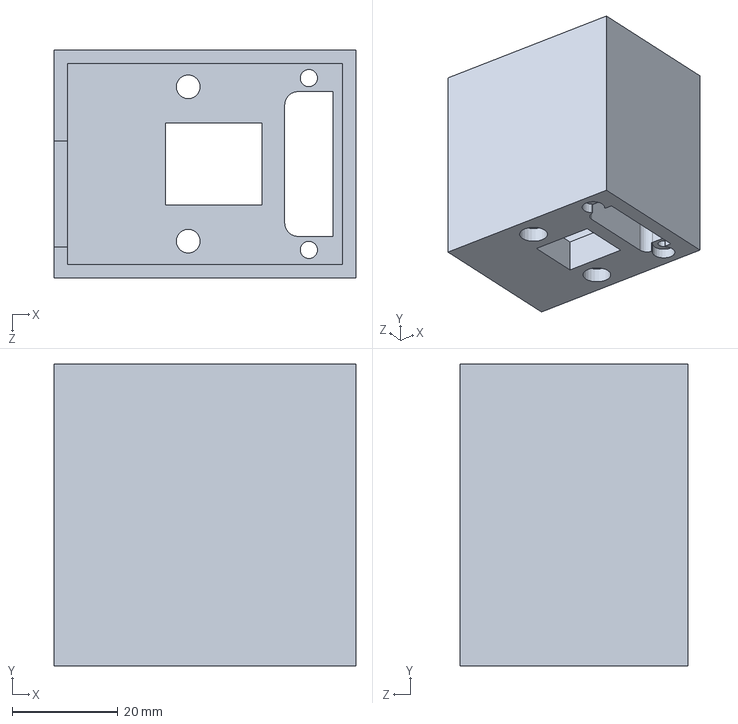
[picture p74: CAD file, 2013-04-07]
Final/WireCap/WireCap.SLDPRT
57.1 x 57.1 x 43.2 mm
