karldprice/M_Dsgn/Stack_v2/BodyPitch/gearBlock.SLDPRT

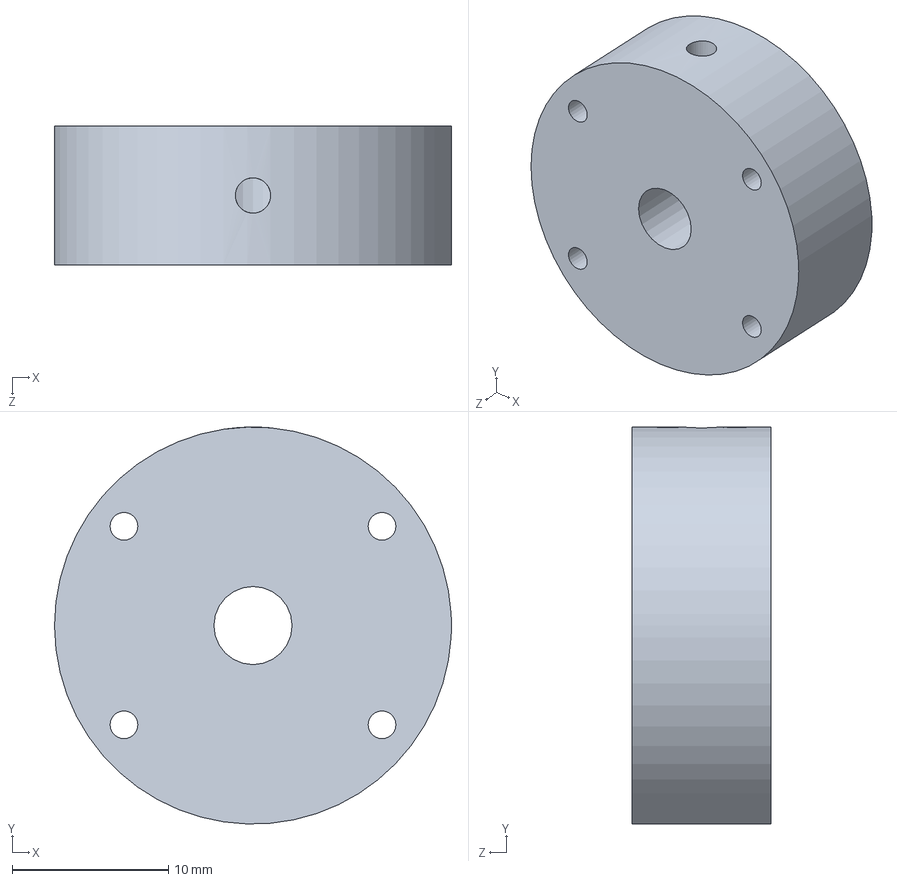
[picture p75: CAD file, 2013-02-03]
Stack_v2/BodyPitch/gearBlock.SLDPRT
25.4 x 25.4 x 8.89 mm
