karldprice/M_Dsgn/Stack_v2/Needle/LinActCover.SLDPRT

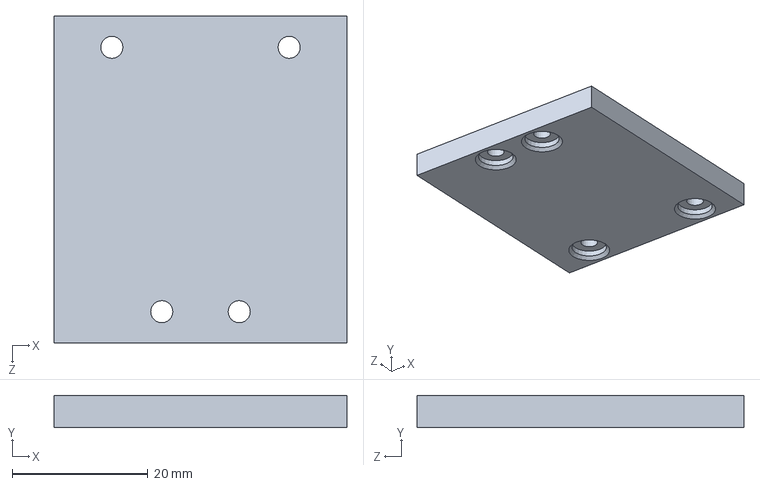
[picture p76: CAD file, 2013-02-13]
Stack_v2/Needle/LinActCover.SLDPRT
43.2 x 4.76 x 48.3 mm
