karldprice/M_Dsgn/Stack_v2/OuterRoll_v2/SunGearMountSquare.SLDPRT

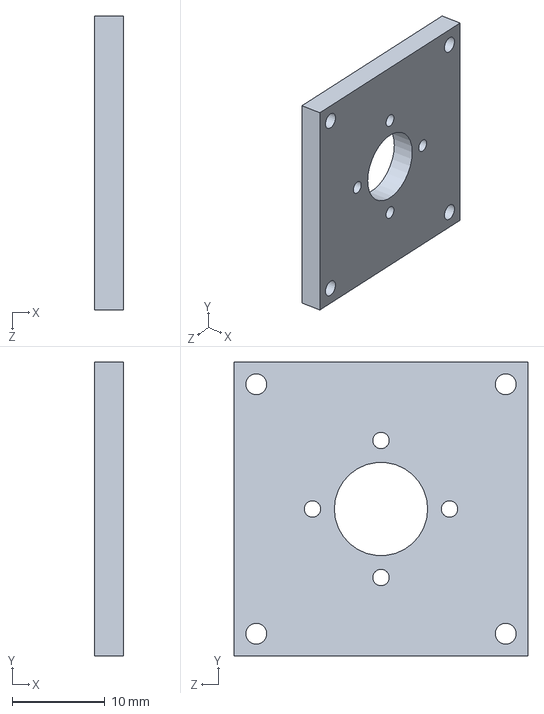
[picture p77: CAD file, 2013-03-04]
Stack_v2/OuterRoll_v2/SunGearMountSquare.SLDPRT
3.17 x 31.8 x 31.8 mm
