karldprice/M_Dsgn/Stack_v2/Tool/ToolShaft.SLDPRT

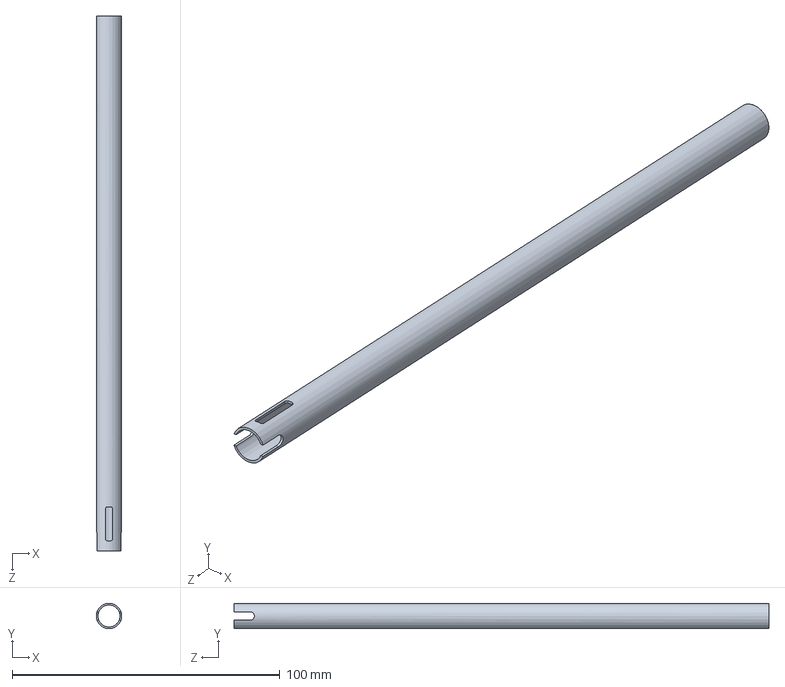
[picture p78: CAD file, 2013-02-03]
Stack_v2/Tool/ToolShaft.SLDPRT
9.53 x 9.53 x 200.0 mm
