karldprice/M_Dsgn/Stock_Parts/collars/collar_mc_57445K250.SLDPRT

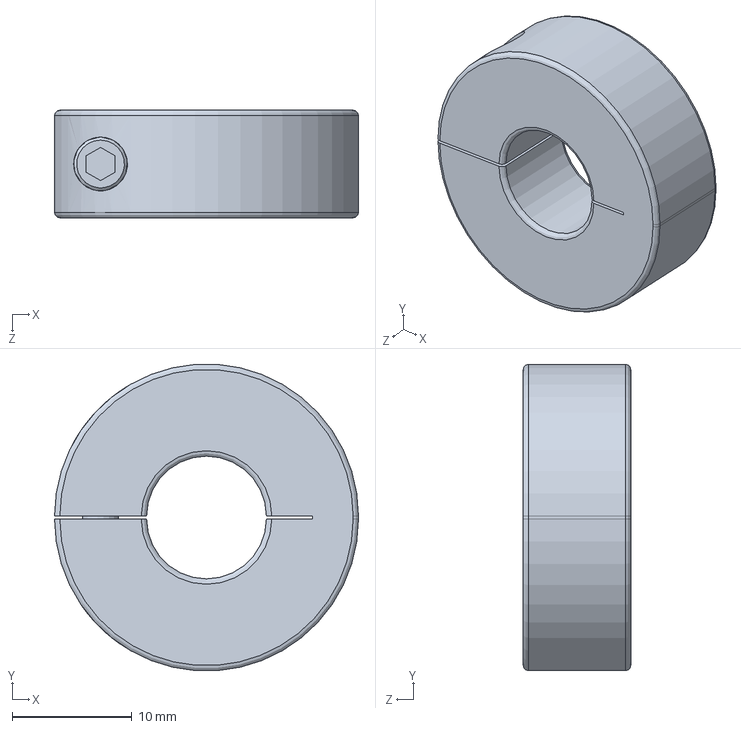
[picture p79: CAD file, 2013-02-12]
Stock_Parts/collars/collar_mc_57445K250.SLDPRT
25.4 x 25.6 x 9.00 mm
