karldprice/M_Dsgn/Stock_Parts/electronics/26pos_D-SUB_609-4043-ND.SLDPRT

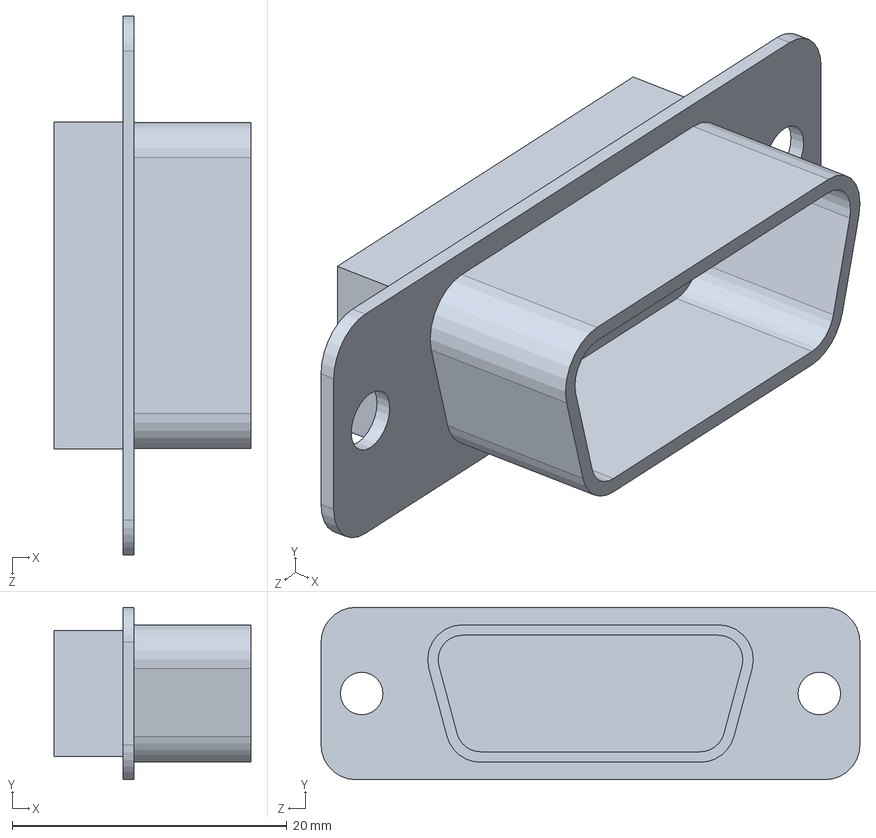
[picture p80: CAD file, 2013-02-14]
Stock_Parts/electronics/26pos_D-SUB_609-4043-ND.SLDPRT
14.3 x 12.6 x 39.2 mm
