karldprice/M_Dsgn/Stock_Parts/Gears/gear_sdpi_s1268z-064a064.SLDPRT

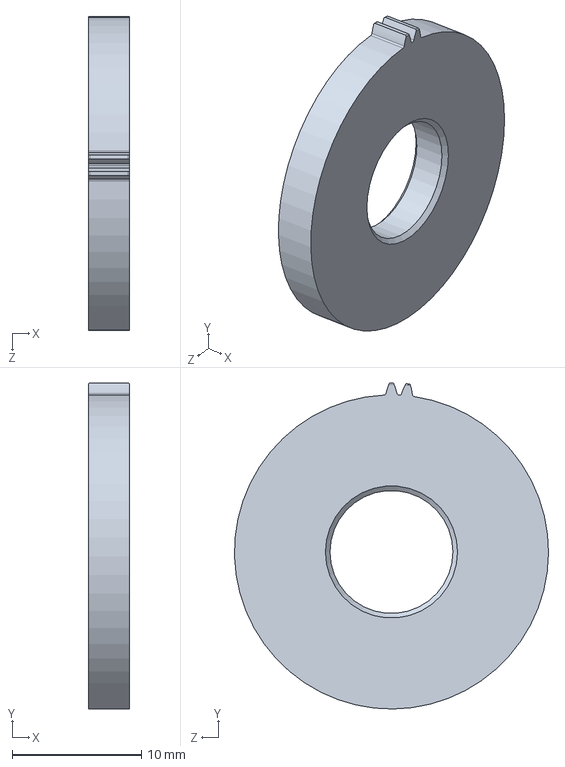
[picture p81: CAD file, 2013-02-12]
Stock_Parts/Gears/gear_sdpi_s1268z-064a064.SLDPRT
3.17 x 25.3 x 24.3 mm
