karldprice/M_Dsgn/Final/Needle/Needle_Coupler.SLDPRT

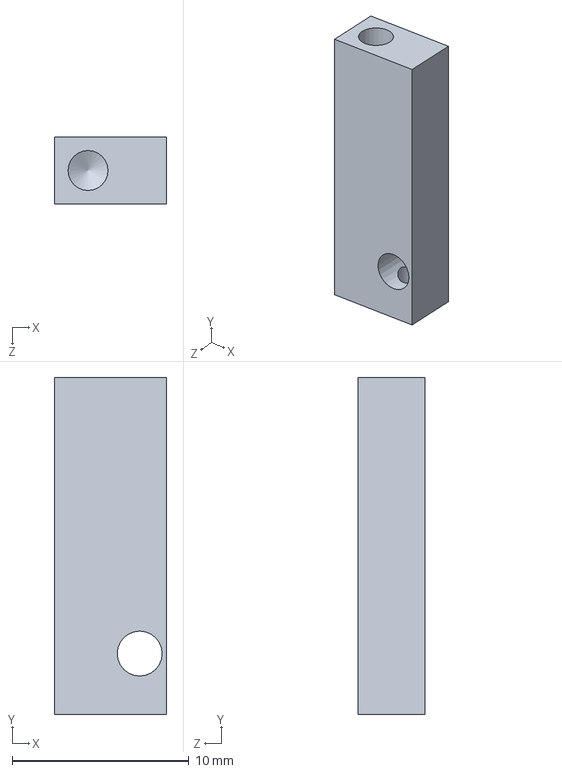
[picture p82: CAD file, 2013-02-03]
Final/Needle/Needle_Coupler.SLDPRT
6.35 x 19.1 x 3.81 mm
