karldprice/M_Dsgn/Final/OuterRoll/DensoMount_Plate.SLDPRT

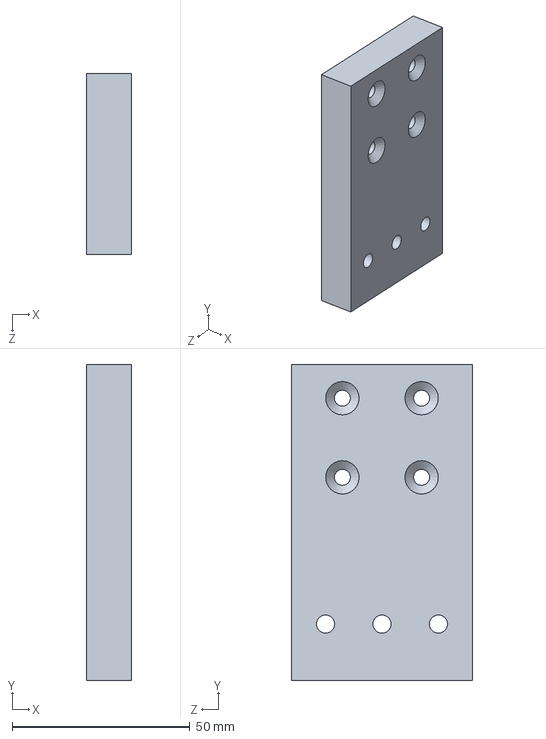
[picture p83: CAD file, 2013-04-07]
Final/OuterRoll/DensoMount_Plate.SLDPRT
12.7 x 88.9 x 50.8 mm
