karldprice/M_Dsgn/Final/Pitch/Pitch_Spool.SLDPRT

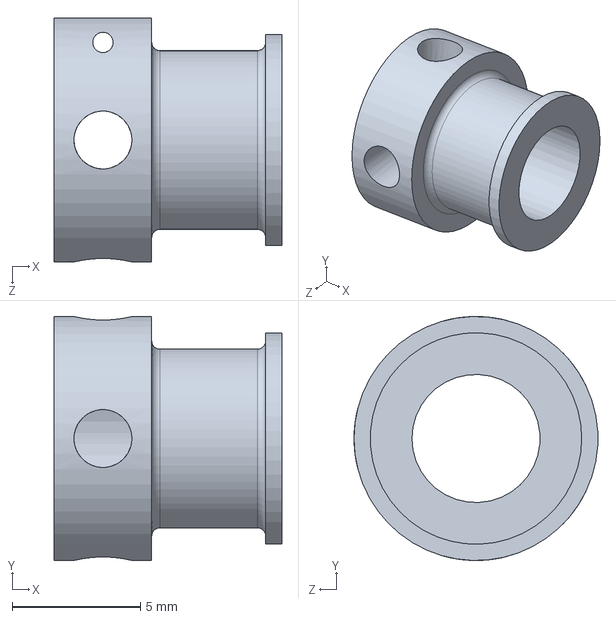
[picture p84: CAD file, 2013-03-04]
Final/Pitch/Pitch_Spool.SLDPRT
8.89 x 9.52 x 9.53 mm
