karldprice/M_Dsgn/Final/Roll/EncoderMounting.SLDPRT

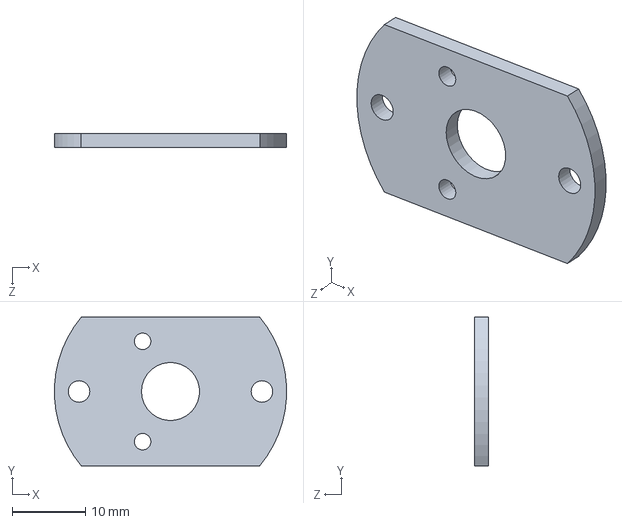
[picture p85: CAD file, 2013-02-12]
Final/Roll/EncoderMounting.SLDPRT
31.7 x 20.3 x 1.90 mm
