karldprice/M_Dsgn/Final/StockParts/BallBearings/Ball_Bearing_AXA1221.SLDPRT

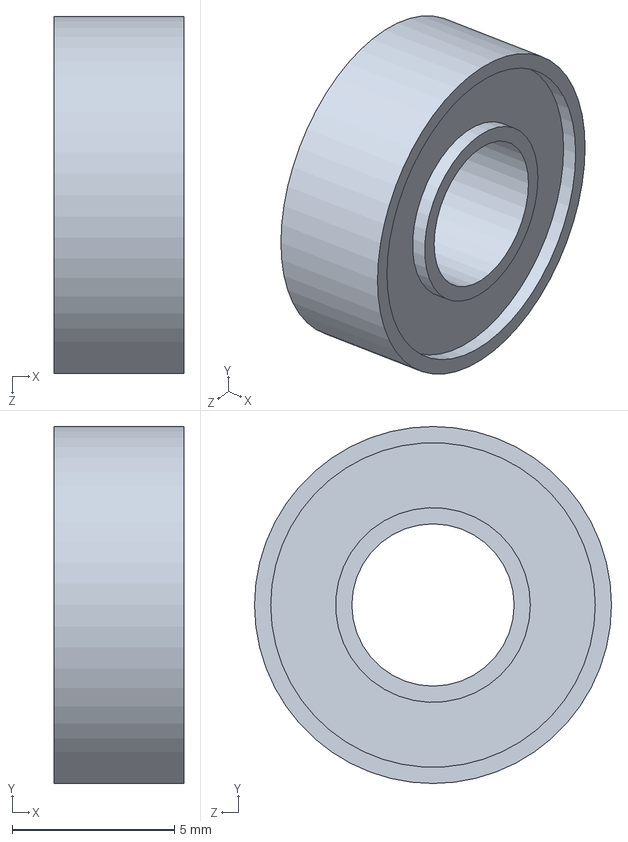
[picture p86: CAD file, 2013-01-18]
Final/StockParts/BallBearings/Ball_Bearing_AXA1221.SLDPRT
4.00 x 11.0 x 11.0 mm
