karldprice/M_Dsgn/Final/StockParts/Gears/gear_m07-42_a-1m-2myz07042.SLDPRT

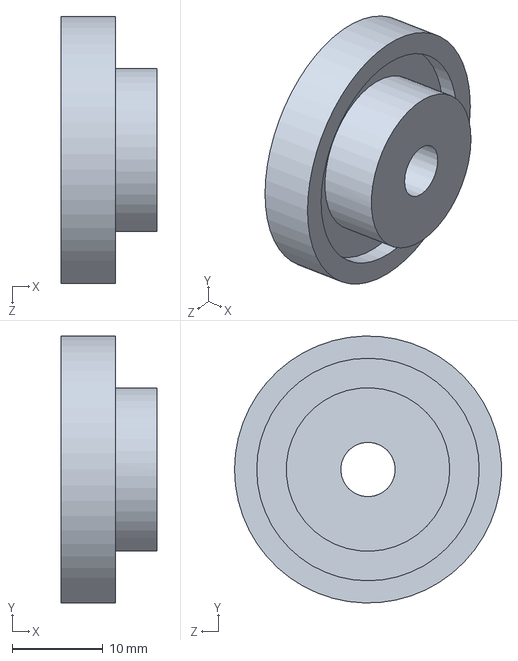
[picture p87: CAD file, 2013-02-14]
Final/StockParts/Gears/gear_m07-42_a-1m-2myz07042.SLDPRT
10.6 x 29.4 x 29.4 mm
