karldprice/M_Dsgn/Final/StockParts/Motors/L12_linAct_Shaft.SLDPRT

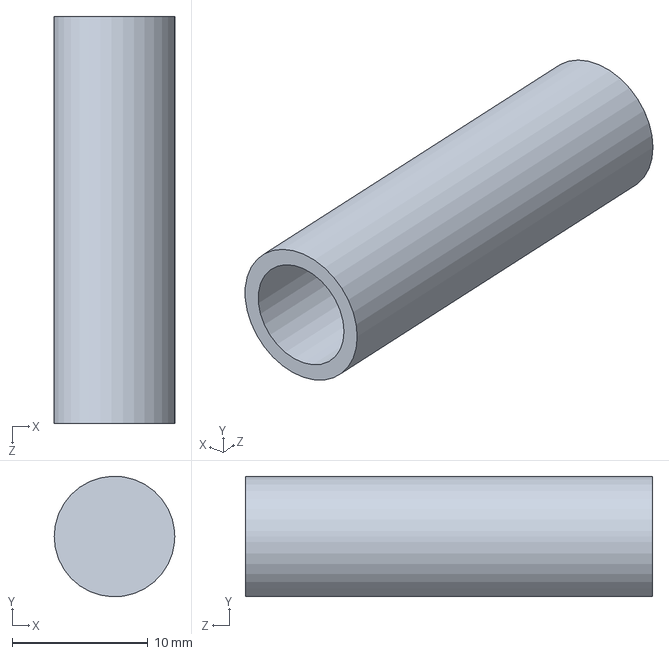
[picture p88: CAD file, 2013-01-15]
Final/StockParts/Motors/L12_linAct_Shaft.SLDPRT
8.89 x 8.88 x 30.0 mm
