karldprice/M_Dsgn/Final/Tool/EnclosureBottom.SLDPRT

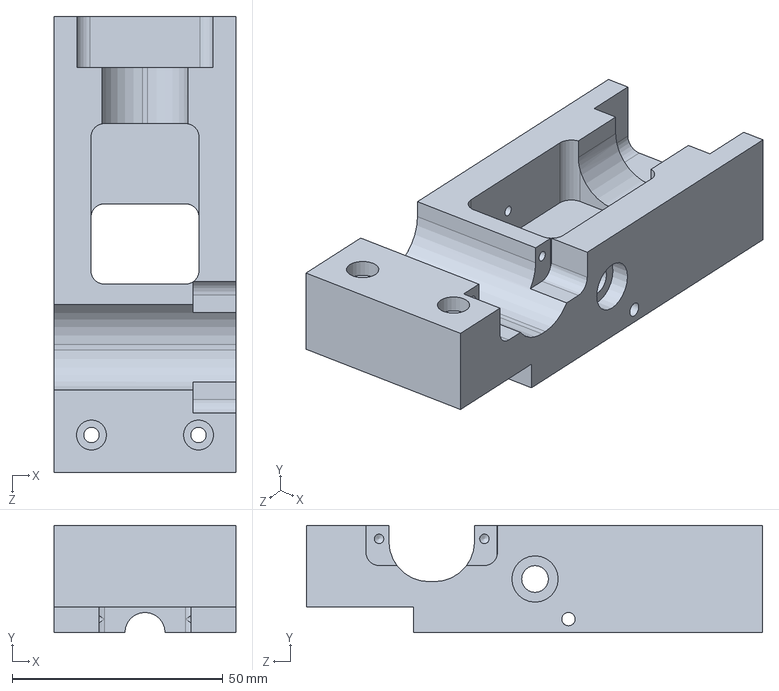
[picture p89: CAD file, 2013-04-07]
Final/Tool/EnclosureBottom.SLDPRT
43.2 x 25.4 x 108.2 mm
