karldprice/M_Dsgn/Stack_v2/Grip/actBracket.SLDPRT

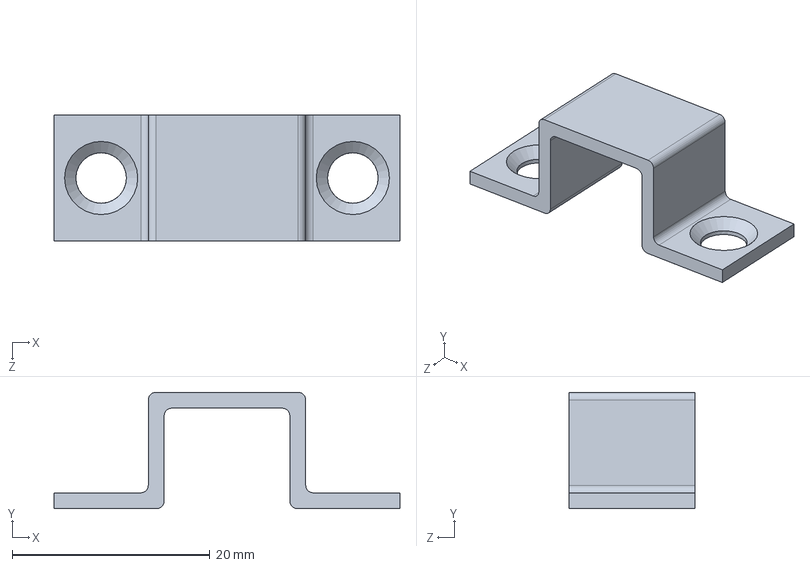
[picture p90: CAD file, 2012-10-30]
Stack_v2/Grip/actBracket.SLDPRT
35.0 x 11.8 x 12.7 mm
