karldprice/M_Dsgn/Stack_v2/OuterRoll_v2/SunGearMount.SLDPRT

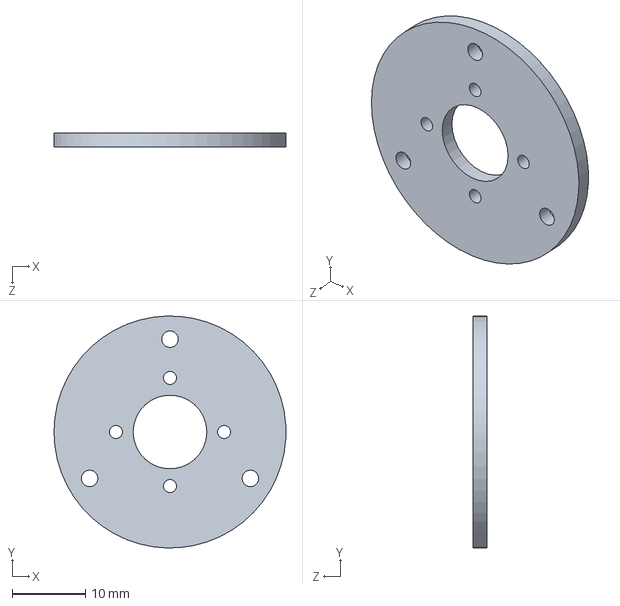
[picture p91: CAD file, 2013-02-12]
Stack_v2/OuterRoll_v2/SunGearMount.SLDPRT
31.8 x 31.7 x 1.90 mm
