karldprice/M_Dsgn/Stock_Parts/BallBearings/ball_bearing_05_MC_57155K358.SLDPRT

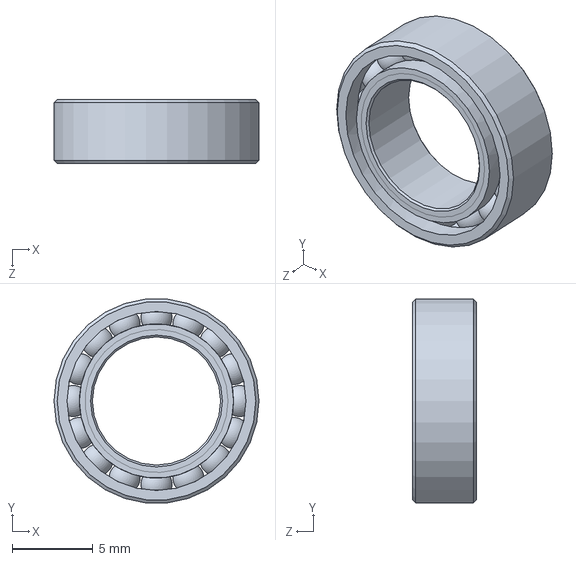
[picture p92: CAD file, 2012-10-30]
Stock_Parts/BallBearings/ball_bearing_05_MC_57155K358.SLDPRT
12.7 x 12.6 x 3.97 mm
