karldprice/M_Dsgn/Stock_Parts/Gears/MOD_gear_sdpi_s1288z-064D064.SLDPRT

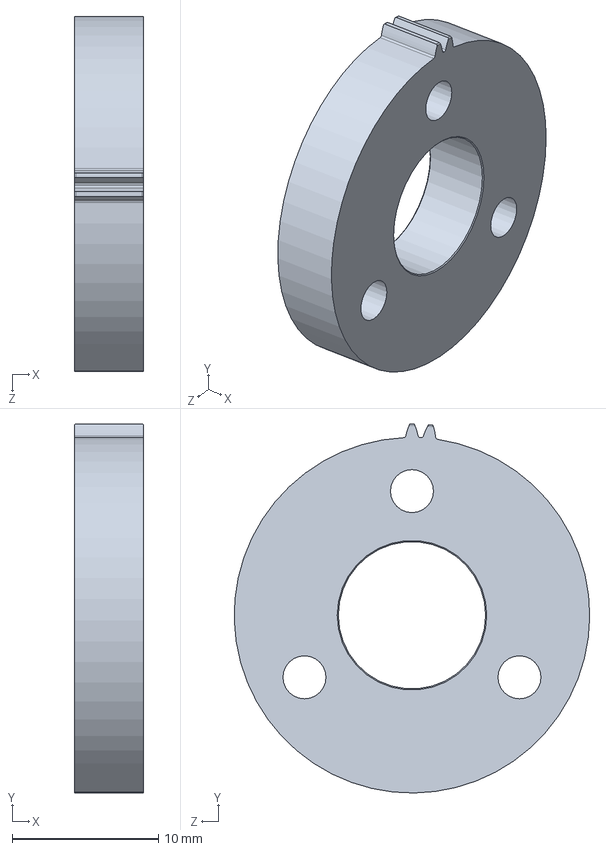
[picture p93: CAD file, 2013-02-12]
Stock_Parts/Gears/MOD_gear_sdpi_s1288z-064D064.SLDPRT
4.75 x 25.3 x 24.3 mm
