karldprice/M_Dsgn/Stock_Parts/LinActs/linAct_L12_30mm.sldprt

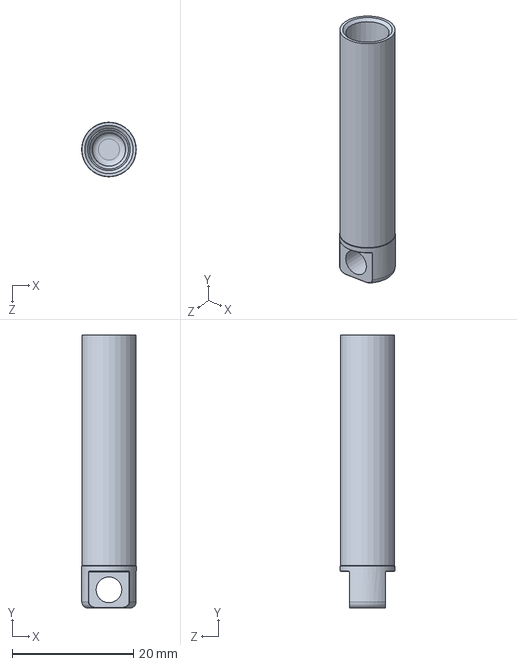
[picture p94: CAD file, 2012-10-26]
Stock_Parts/LinActs/linAct_L12_30mm.sldprt
8.99 x 45.0 x 9.00 mm
