karldprice/M_Dsgn/Final/Needle/LinActSpacer.SLDPRT

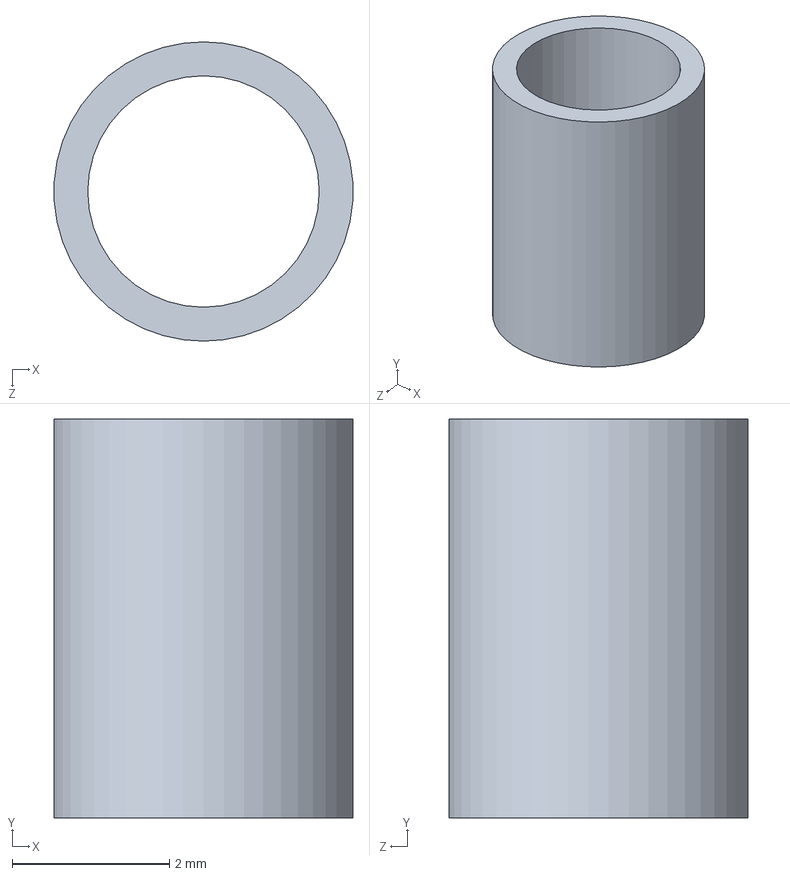
[picture p95: CAD file, 2013-01-18]
Final/Needle/LinActSpacer.SLDPRT
3.80 x 5.08 x 3.81 mm
