karldprice/M_Dsgn/Final/Pitch/Pitch_Collar.SLDPRT

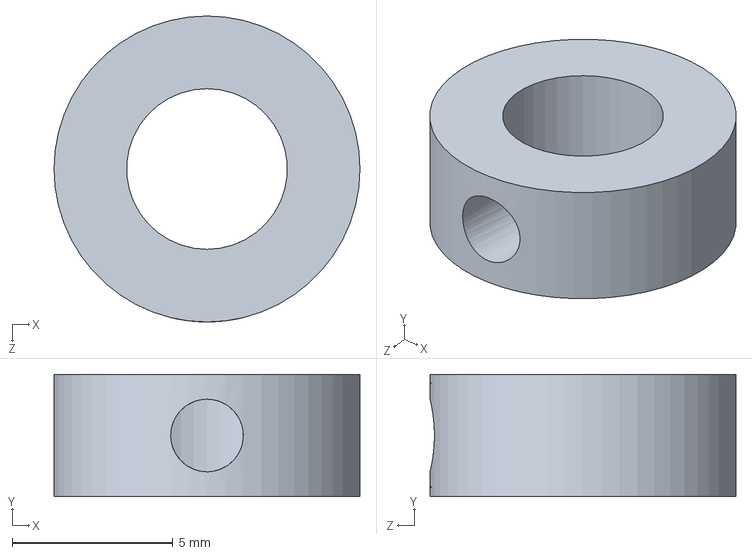
[picture p96: CAD file, 2013-03-04]
Final/Pitch/Pitch_Collar.SLDPRT
9.53 x 3.81 x 9.53 mm
