karldprice/M_Dsgn/Final/StockParts/Gears/gear_p32-14_SPD-A1T2-Y32014.SLDPRT

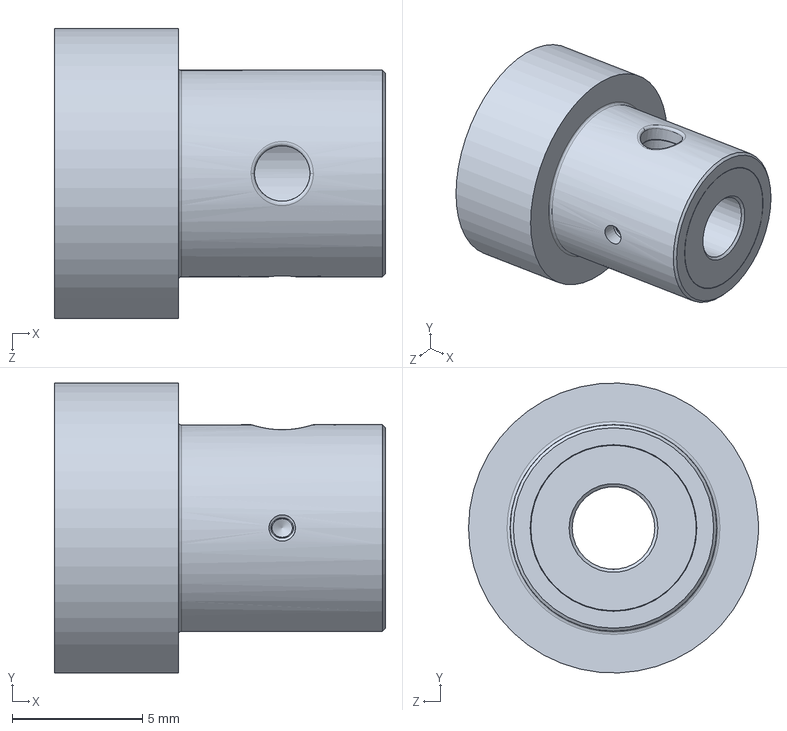
[picture p97: CAD file, 2013-02-12]
Final/StockParts/Gears/gear_p32-14_SPD-A1T2-Y32014.SLDPRT
12.7 x 11.1 x 11.1 mm
