karldprice/M_Dsgn/Final/StockParts/Motors/L12_linAct_Body.SLDPRT

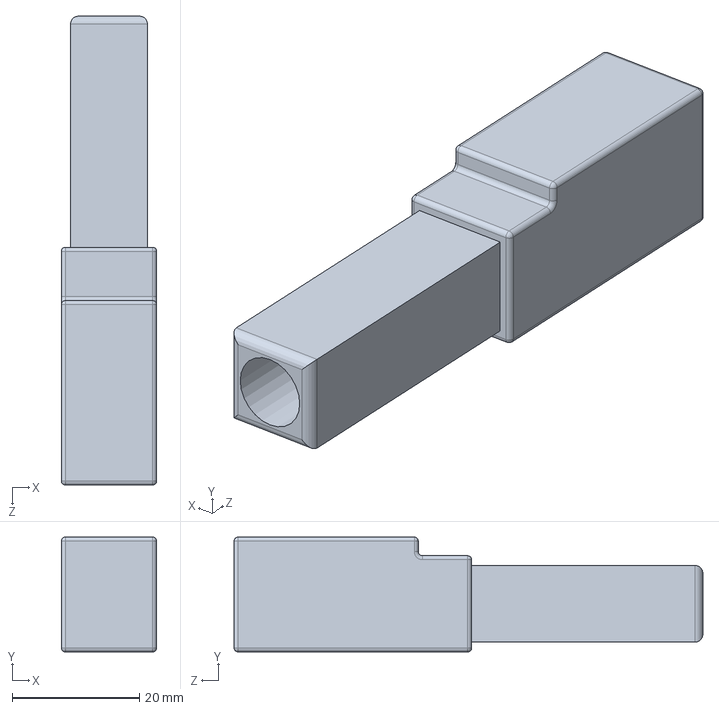
[picture p98: CAD file, 2013-01-15]
Final/StockParts/Motors/L12_linAct_Body.SLDPRT
15.0 x 18.0 x 73.7 mm
