karldprice/M_Dsgn/Final/Tool/EnclosureCap.SLDPRT

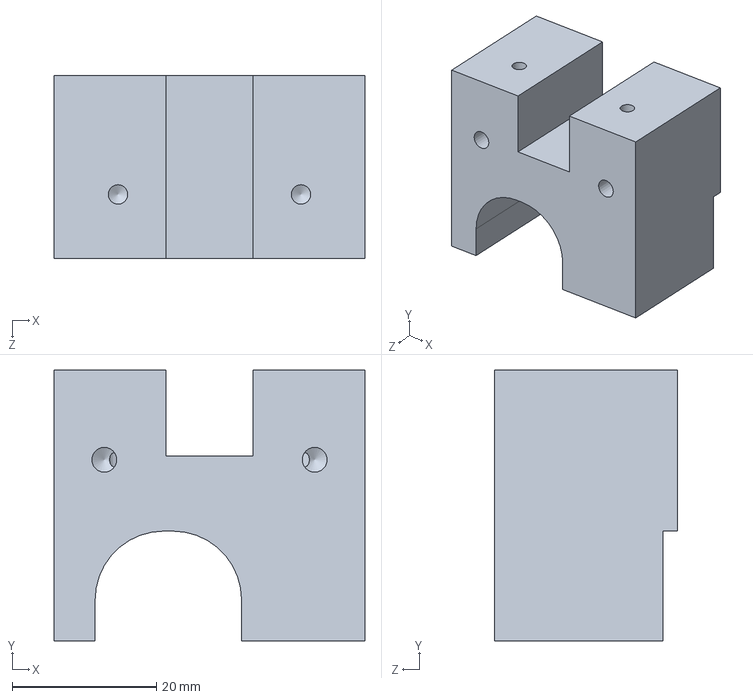
[picture p99: CAD file, 2013-04-07]
Final/Tool/EnclosureCap.SLDPRT
43.2 x 37.6 x 25.4 mm
