karldprice/M_Dsgn/Stock_Parts/BallBearings/Ball_Bearing_mc_6383K120.SLDPRT

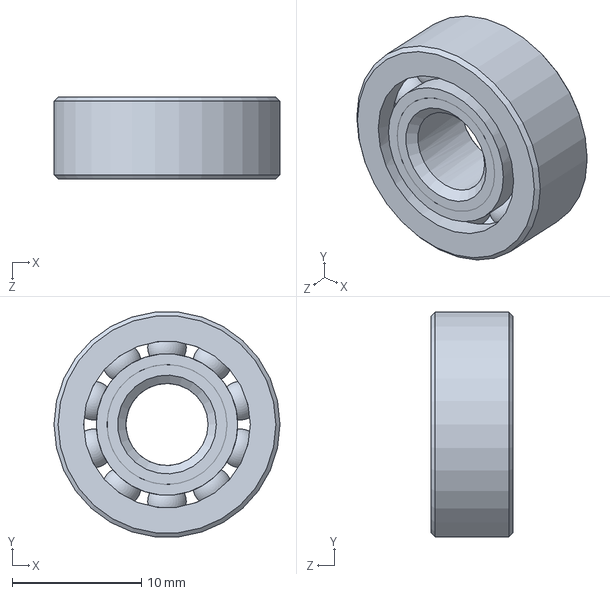
[picture p100: CAD file, 2012-10-12]
Stock_Parts/BallBearings/Ball_Bearing_mc_6383K120.SLDPRT
17.5 x 17.4 x 6.35 mm
