karldprice/M_Dsgn/Stock_Parts/LinActs/Linear_Actuator_Fork.SLDPRT

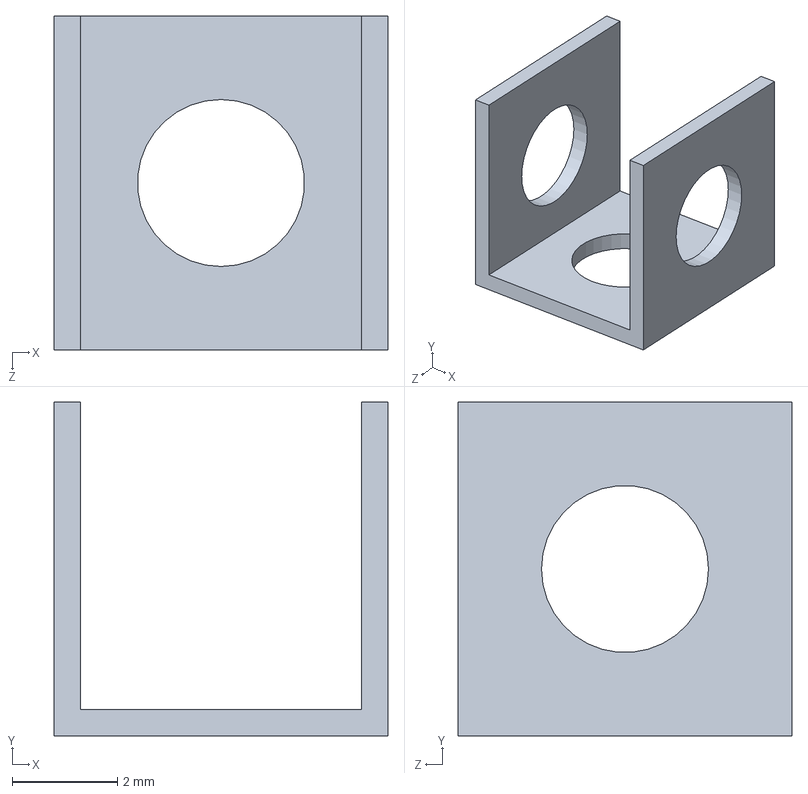
[picture p102: CAD file, 2012-10-26]
Stock_Parts/LinActs/Linear_Actuator_Fork.SLDPRT
6.35 x 6.35 x 6.35 mm
