karldprice/M_Dsgn/Final/Pitch/Pitch_GuideBar.SLDPRT

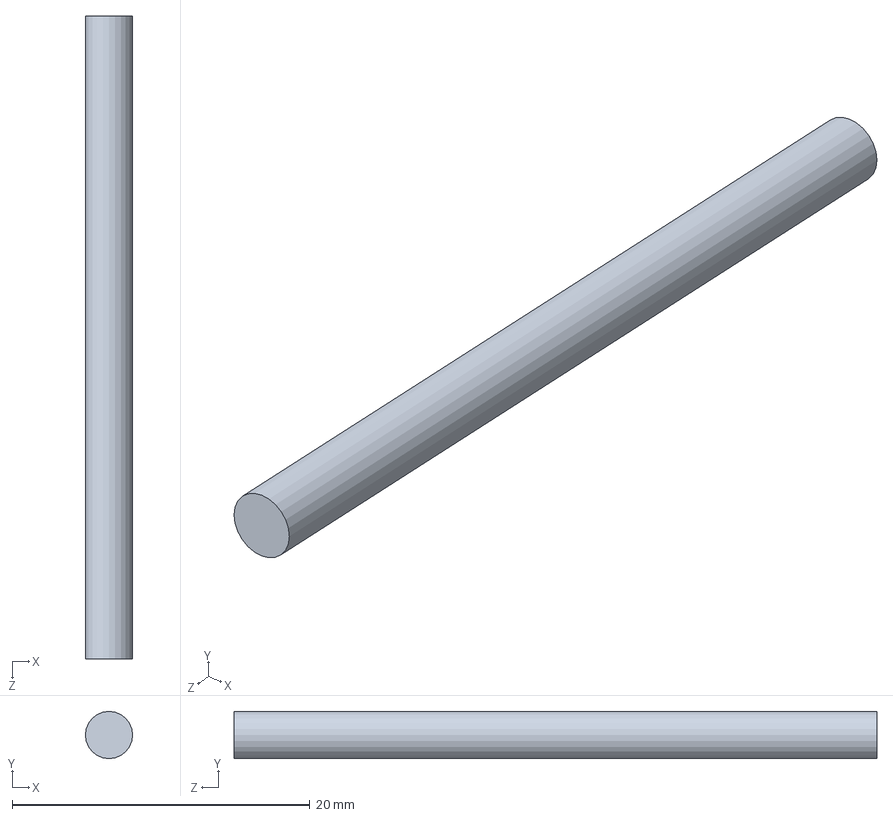
[picture p103: CAD file, 2013-02-11]
Final/Pitch/Pitch_GuideBar.SLDPRT
3.17 x 3.17 x 43.2 mm
