karldprice/M_Dsgn/Final/StockParts/Gears/gear_p32-52_SPD-S1084Z-032DS052.SLDPRT

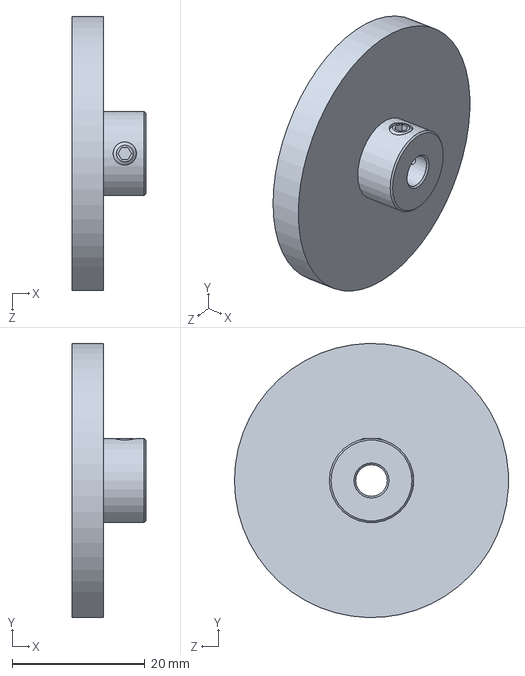
[picture p104: CAD file, 2013-02-12]
Final/StockParts/Gears/gear_p32-52_SPD-S1084Z-032DS052.SLDPRT
11.1 x 41.3 x 41.3 mm
