karldprice/M_Dsgn/Final/StockParts/Motors/stepper_motor_20mm_DK_P14334-ND.SLDPRT

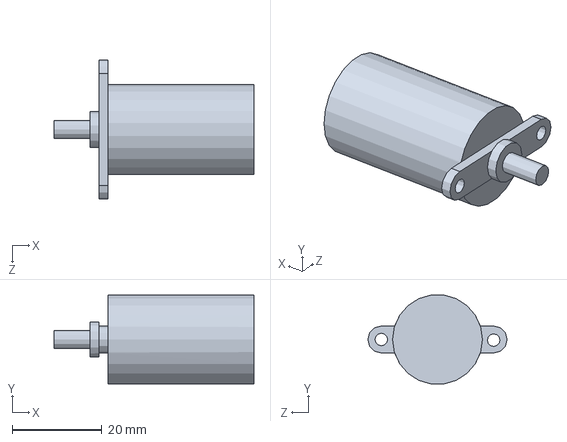
[picture p105: CAD file, 2012-10-12]
Final/StockParts/Motors/stepper_motor_20mm_DK_P14334-ND.SLDPRT
44.5 x 19.8 x 31.0 mm
