karldprice/M_Dsgn/Final/Pitch/Pitch_GearSpacer.SLDPRT

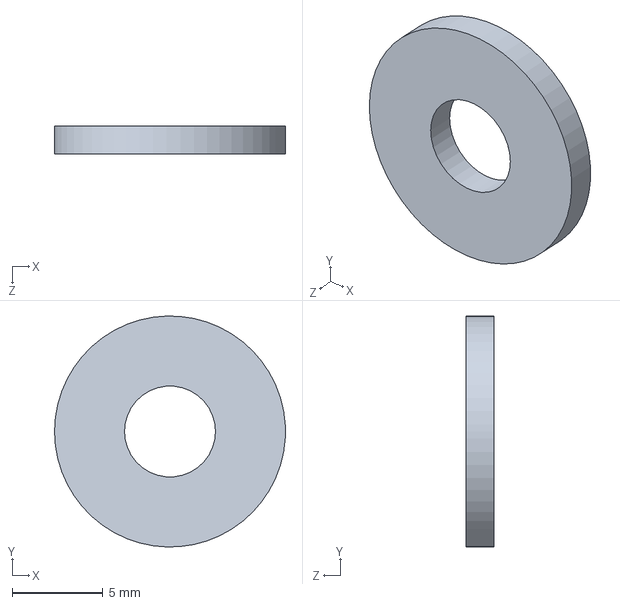
[picture p106: CAD file, 2013-02-11]
Final/Pitch/Pitch_GearSpacer.SLDPRT
12.7 x 12.7 x 1.52 mm
