karldprice/M_Dsgn/Stock_Parts/Gears/gear_mc_57655k38.SLDPRT

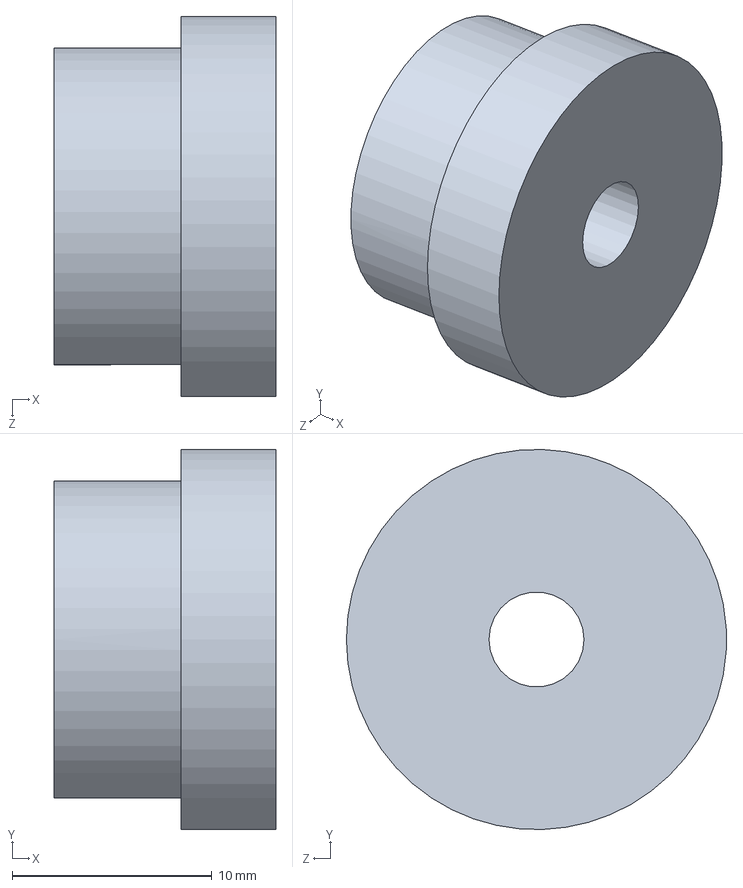
[picture p107: CAD file, 2013-02-11]
Stock_Parts/Gears/gear_mc_57655k38.SLDPRT
11.1 x 19.0 x 19.1 mm
