karldprice/M_Dsgn/Final/Pitch/Pitch_Shaft.SLDPRT

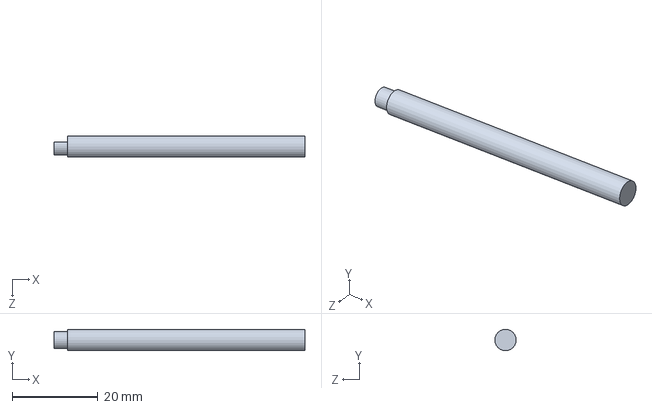
[picture p108: CAD file, 2013-02-11]
Final/Pitch/Pitch_Shaft.SLDPRT
58.7 x 5.00 x 5.00 mm
