karldprice/M_Dsgn/Final/Tool/ssToolShaft.SLDPRT

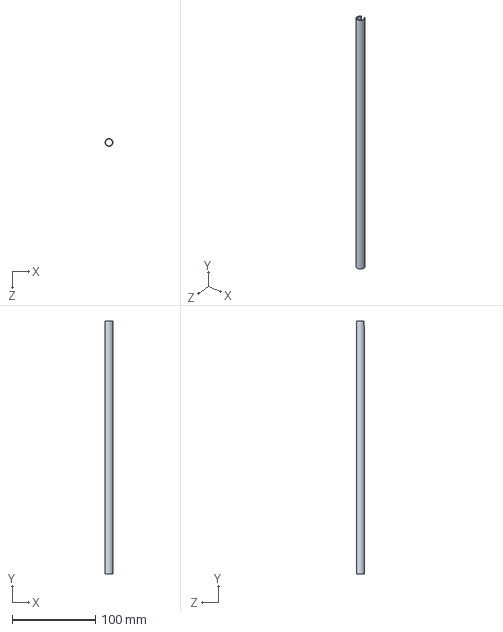
[picture p109: CAD file, 2013-03-04]
Final/Tool/ssToolShaft.SLDPRT
9.53 x 304.8 x 9.53 mm
