karldprice/M_Dsgn/Stock_Parts/Gears/s1288z-064d064.stp

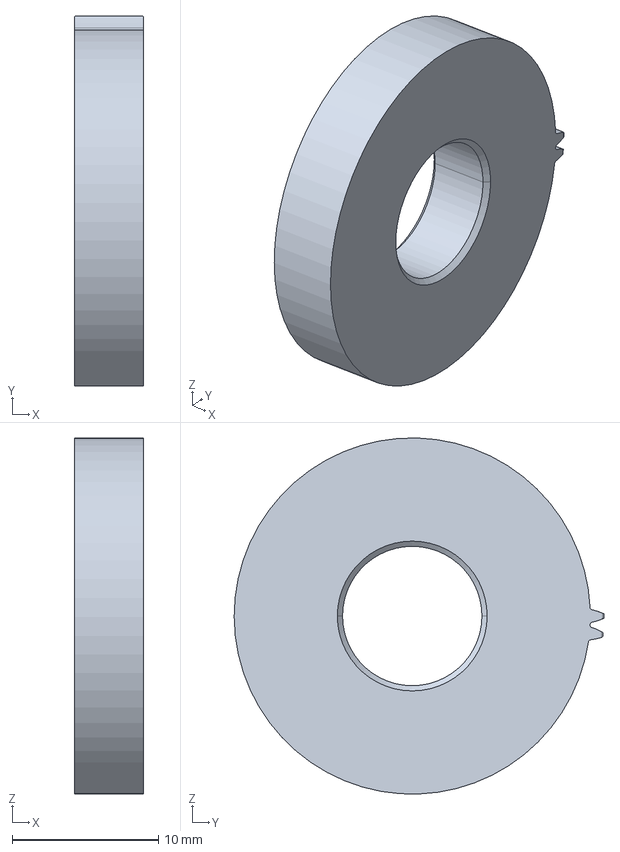
[picture p110: CAD file, 2013-02-11]
Stock_Parts/Gears/s1288z-064d064.stp
4.75 x 25.3 x 24.3 mm
