karldprice/M_Dsgn/Stock_Parts/Gears/gear_mc_57655k42.SLDPRT

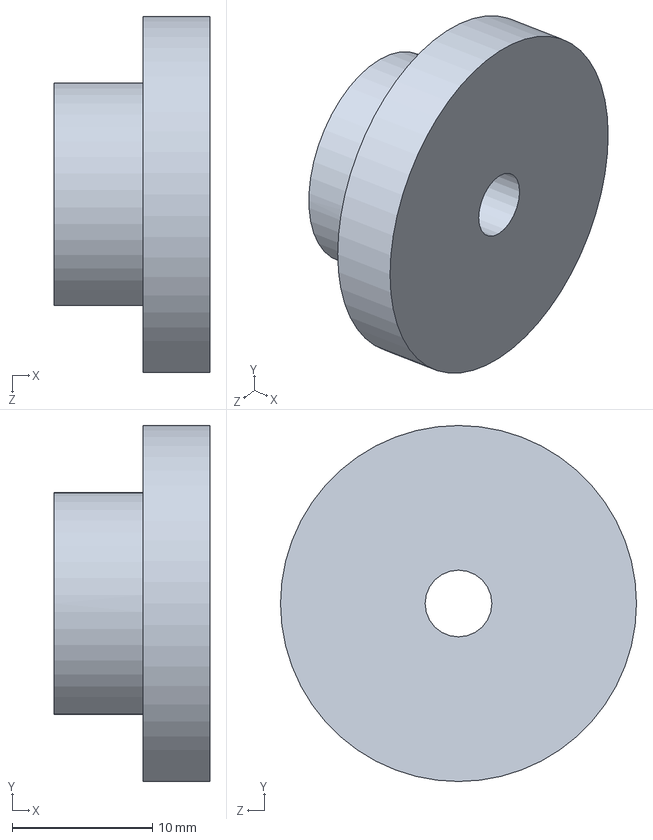
[picture p111: CAD file, 2013-02-11]
Stock_Parts/Gears/gear_mc_57655k42.SLDPRT
11.1 x 25.4 x 25.4 mm
