karldprice/M_Dsgn/Final/Tool/gearboxGear_m07t16.SLDPRT

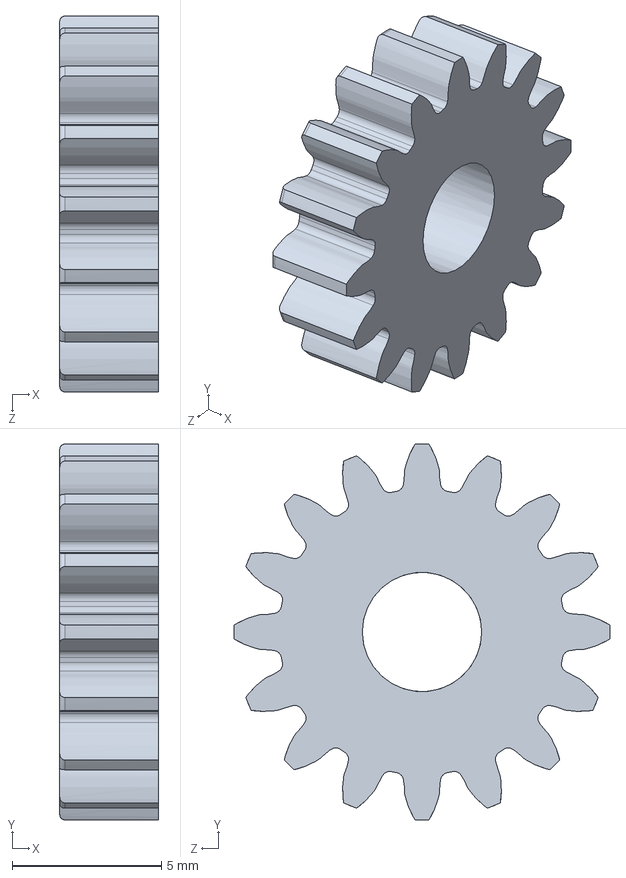
[picture p112: CAD file, 2013-02-14]
Final/Tool/gearboxGear_m07t16.SLDPRT
3.30 x 12.6 x 12.6 mm
