karldprice/M_Dsgn/Final/Tool/Gearbox.SLDPRT

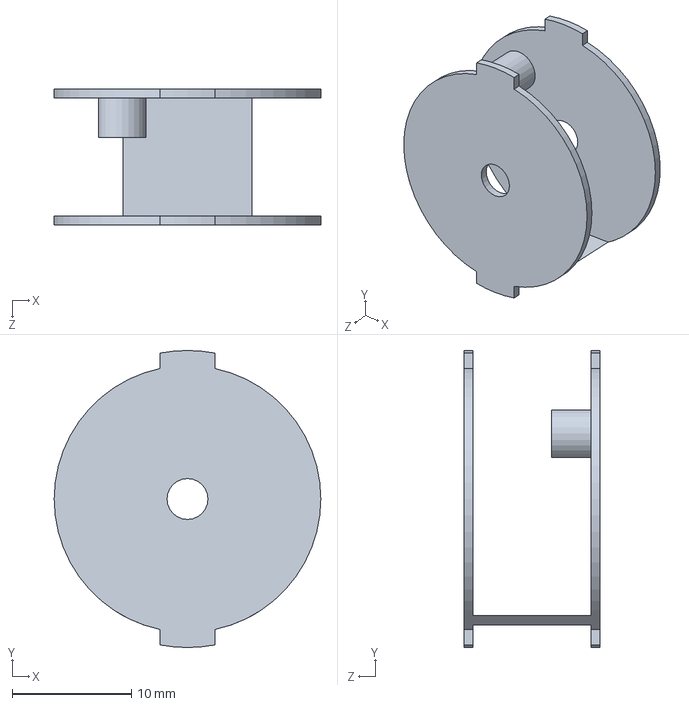
[picture p113: CAD file, 2013-02-14]
Final/Tool/Gearbox.SLDPRT
22.4 x 24.9 x 11.4 mm
