karldprice/M_Dsgn/Stock_Parts/Gears/gear_sdpi_s1063z-06a064.stp

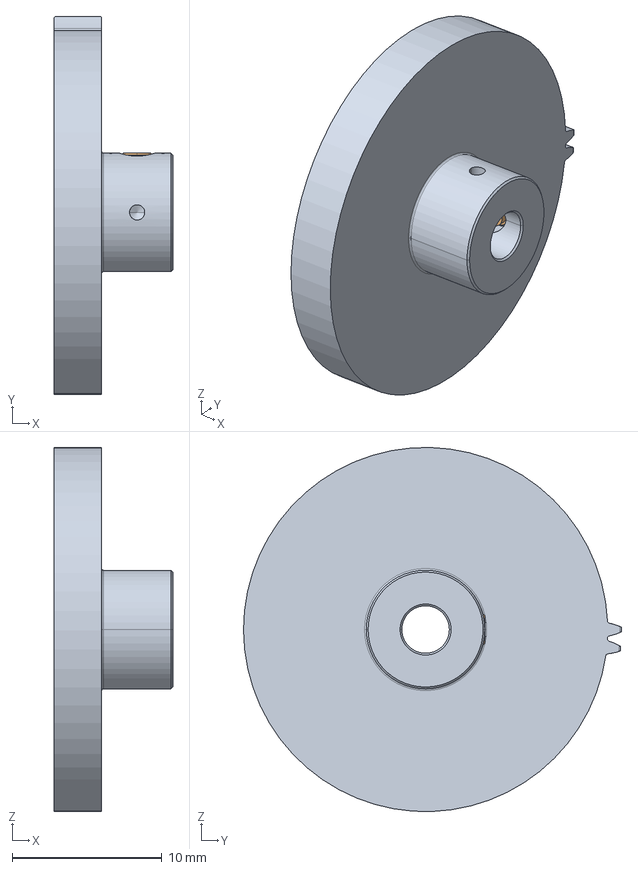
[picture p114: CAD file, 2013-02-11]
Stock_Parts/Gears/gear_sdpi_s1063z-06a064.stp
7.92 x 25.3 x 24.3 mm
