karldprice/M_Dsgn/Final/Tool/NeedleControlRod.SLDPRT

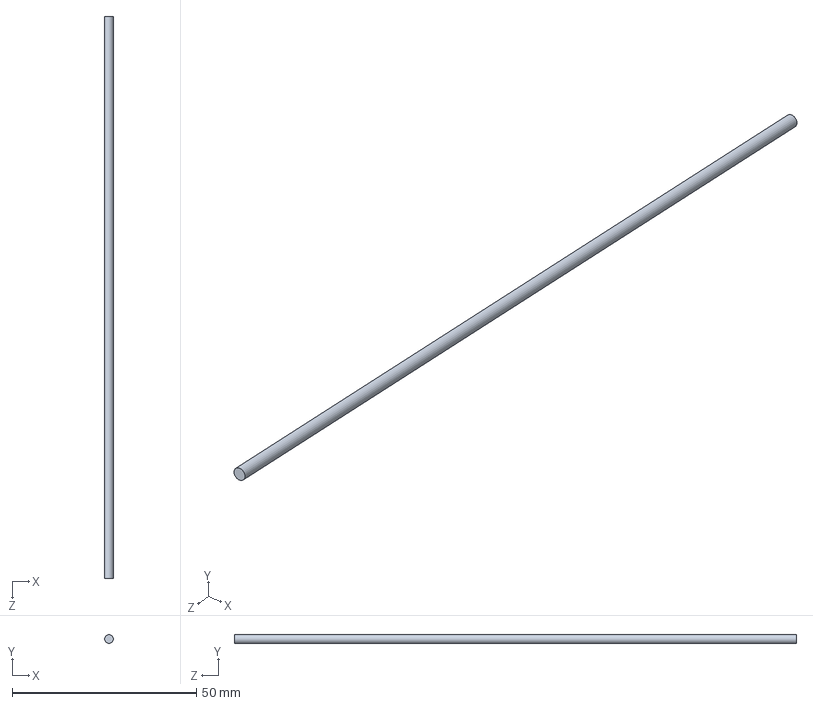
[picture p115: CAD file, 2013-01-19]
Final/Tool/NeedleControlRod.SLDPRT
2.36 x 2.36 x 152.4 mm
