karldprice/M_Dsgn/Stock_Parts/Gears/gear_pitch_AX30853.SLDPRT

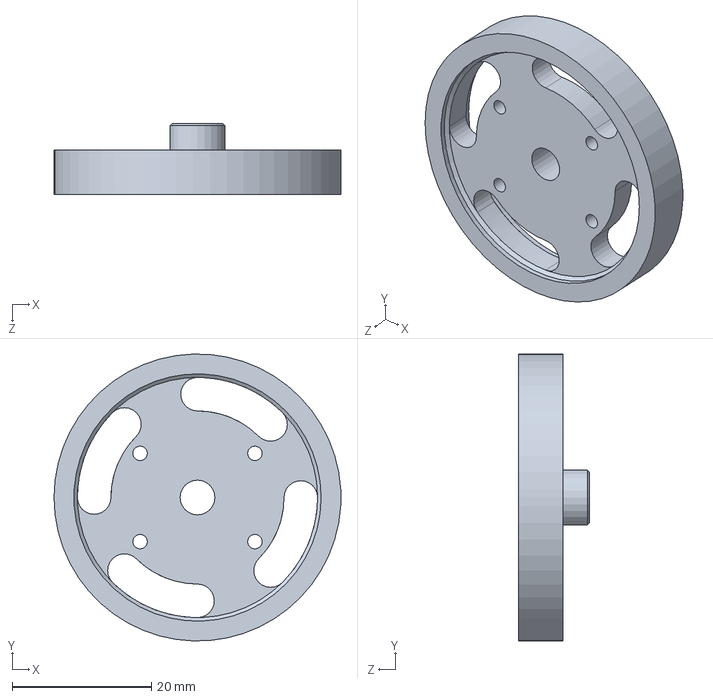
[picture p116: CAD file, 2013-02-03]
Stock_Parts/Gears/gear_pitch_AX30853.SLDPRT
41.3 x 41.3 x 10.2 mm
