karldprice/M_Dsgn/Final/Tool/JawShaft.SLDPRT

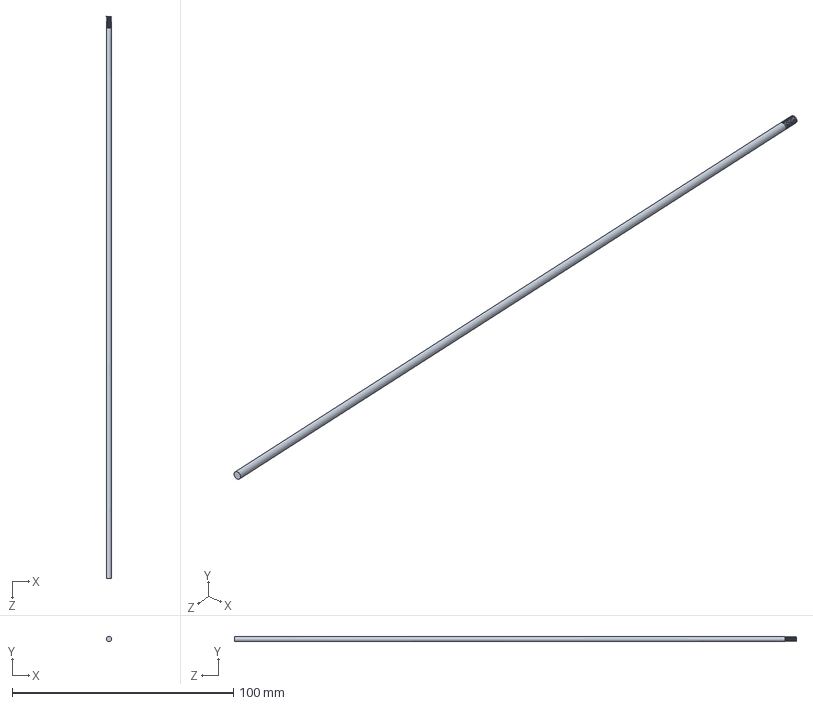
[picture p117: CAD file, 2013-01-19]
Final/Tool/JawShaft.SLDPRT
2.36 x 2.36 x 254.0 mm
