karldprice/M_Dsgn/Stock_Parts/Gears/gear_m05_pd_15-SPD-S10Z05M030T0505.SLDPRT

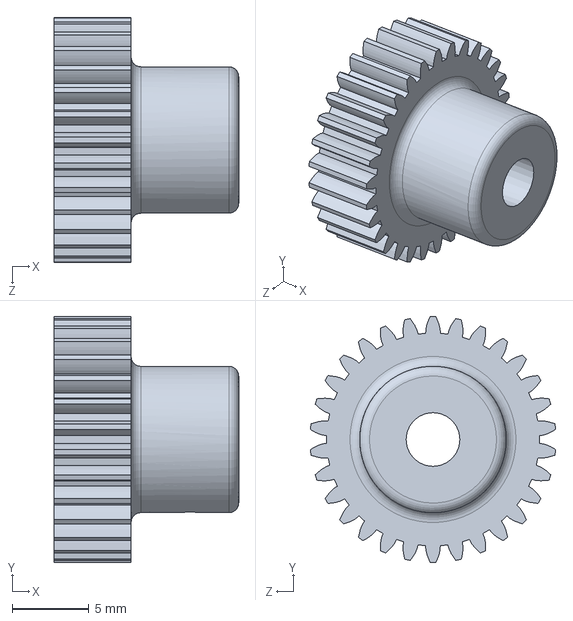
[picture p118: CAD file, 2013-01-24]
Stock_Parts/Gears/gear_m05_pd_15-SPD-S10Z05M030T0505.SLDPRT
12.0 x 16.0 x 15.9 mm
