karldprice/M_Dsgn/Stock_Parts/Gears/gear_d0_708_SP_48-034b187.SLDPRT

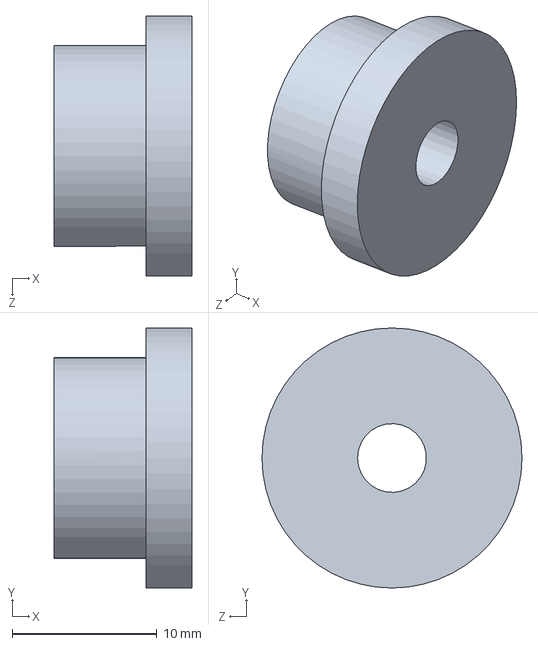
[picture p119: CAD file, 2012-11-07]
Stock_Parts/Gears/gear_d0_708_SP_48-034b187.SLDPRT
9.52 x 18.0 x 18.0 mm
