karldprice/M_Dsgn/Stock_Parts/Gears/gear_d1_688_SP_32-052B313.SLDPRT

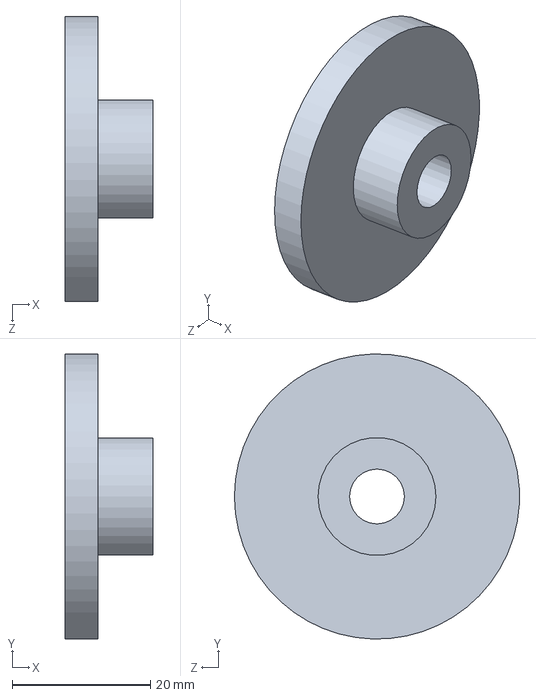
[picture p120: CAD file, 2012-10-30]
Stock_Parts/Gears/gear_d1_688_SP_32-052B313.SLDPRT
12.7 x 41.3 x 41.3 mm
