karldprice/M_Dsgn/Stock_Parts/Gears/gear_d0_5_SP_32-014B156.SLDPRT

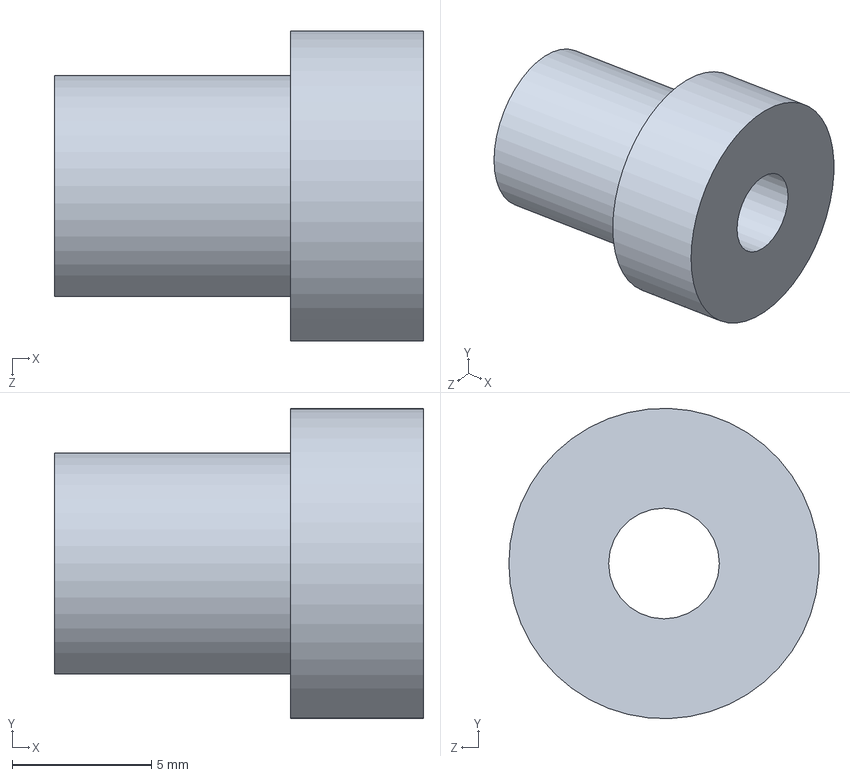
[picture p121: CAD file, 2012-10-12]
Stock_Parts/Gears/gear_d0_5_SP_32-014B156.SLDPRT
13.2 x 11.1 x 11.1 mm
