karldprice/M_Dsgn/(list of files, cad)

Other CAD files:
Final/Pitch/PitchAssem.SLDASM
Final/StockParts/Motors/linear_actuator_RS_pq-12-20.SLDASM
Stack_v2/Grip/L12_linAct_cust.SLDASM
Stock_Parts/Gears/gear_sdpi_A_1C_2MY04055/a_1c_2my04055.stp
Stock_Parts/Gears/Outter_Roll_v2/64304/s1268z-048a040.stp
Final/StockParts/Gears/gear_sdpi_s1063z-048a040.SLDPRT
Stock_Parts/BallBearings/ball5972K164.SLDPRT
Stock_Parts/Gears/Outter_Roll_v2/64304/gaer_sdpi_s1268z-048a040.SLDPRT
Final/OuterRoll/OuterRoll_Base.SLDPRT
Final/OuterRoll/OuterRoll_gearPlate.SLDPRT
Stock_Parts/Gears/s1268z-064a064.stp
Final/Tool/WireCap.SLDPRT
Final/Tool/EnclosureBottom3.SLDPRT
Stock_Parts/Gears/gear_sdpi_s1288z-064D064.SLDPRT
Final/StockParts/Fasteners/CapScrew_10-32x1250.SLDPRT
Final/StockParts/Fasteners/CapScrew_4-40x1000.SLDPRT
Final/StockParts/Fasteners/CapScrew_6-32x0500.SLDPRT
Final/StockParts/Fasteners/CapScrew_8-32x2250.SLDPRT
Final/StockParts/Fasteners/FlatScrew_2-56x0250.SLDPRT
Final/StockParts/Fasteners/MOD_93785A700.SLDPRT
Final/StockParts/Fasteners/Nut_2-56.SLDPRT
Final/StockParts/Fasteners/PanScrew_6-32x0375.SLDPRT
Final/StockParts/Fasteners/PanScrew_6-32x1250.SLDPRT
Final/StockParts/Fasteners/Screw_4-40x0250.SLDPRT
Final/StockParts/Fasteners/Screw_4-40x0375.SLDPRT
Final/StockParts/Fasteners/Screw_4-40x0500.SLDPRT
Final/StockParts/Fasteners/Screw_4-40x0625.SLDPRT
Final/StockParts/Fasteners/Screw_4-40x0750.SLDPRT
Final/StockParts/Fasteners/Set_10-32x0750.SLDPRT
Final/StockParts/Fasteners/Set_4-40x0125.SLDPRT
Final/StockParts/Fasteners/washer_mc_93785A700.SLDPRT
Final/_DRW/1-EnclosureBottom.SLDDRW
Final/_DRW/2-RollCap.SLDDRW
Final/_DRW/3-NeedleBase.SLDDRW
Final/_DRW/4-GearBoxBracket.SLDDRW
Final/_DRW/5-DensoMount.SLDDRW
Final/_DRW/6-OuterRollBlock.SLDDRW
Final/_DRW/7-SunGearPlate.SLDDRW
Final/_DRW/PartsList.SLDDRW
Stack_v2/Bill of Materials.SLDDRW
Stack_v2/BodyPitch/pitchCollar.SLDDRW
Stack_v2/BodyPitch/pitchRetainer.SLDDRW
Stack_v2/Grip/actFitting_thrust.SLDDRW
Stack_v2/Needle/LinActBlock.SLDDRW
Stack_v2/OuterRoll_v2/mounting_plate.SLDDRW
Stack_v2/Tool/EnclosureBottom3.SLDDRW
Stock_Parts/Fasteners/CapScrew_6-32x0375.SLDPRT
Stock_Parts/Fasteners/CapScrew_6-32x1250.SLDPRT
Stock_Parts/Fasteners/PanScrew_6-32x0500.SLDPRT
Stock_Parts/Fasteners/Screw_2-56x0375.SLDPRT
Stock_Parts/Fasteners/Screw_4-40x0125.SLDPRT
Stock_Parts/Fasteners/Screw_4-40x1000.SLDPRT
Stock_Parts/Fasteners/Set_4-40x025.SLDPRT
Stock_Parts/Gears/gear_sdpi-A_1P_2MY04055/a_1p_2my04055.SLDPRT
Stock_Parts/Gears/gear_sdpi_A_1C_2MY04055/a_1c_2my04055.SLDPRT
Stock_Parts/Gears/gear_sdpi_s1063z-06a064.SLDPRT
Stock_Parts/collars/57445K250.SLDPRT
