karldprice/M_Dsgn/Final/_DRW/FinalDrawings.pdf

## R0.188 THRU 1.000

0.555

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

UNLESS OTHERWISE SPECIFIED:

DIMENSIONS ARE IN INCHES
TOLERANCES:
THREE PLACE DECIMAL 0.005

DO NOT SCALE DRAWING

0.600

0.650

R0.375 TYP 2; 8-32 UNC; 4-40 UNC; 6-32 UNC; Roll Cap; SCALE: 1:1 WEIGHT:; DWG. NO.; REV; SIZE; TITLE:; AutoSut NAME; DATE; COMMENTS:; MFG APPR.; ENG APPR.; CHECKED; DRAWN; Mill; Nylon 6-10; FINISH; MATERIAL; INTERPRET GEOMETRIC TOLERANCING PER:; ONE PLACE DECIMAL; TWO PLACE DECIMAL

UNLESS OTHERWISE SPECIFIED:

DIMENSIONS ARE IN INCHES
TOLERANCES:
THREE PLACE DECIMAL 0.005

0.850

1.700

R0.188 THRU ALL; 4-40 UNC; 0.144 THRU ALL; Needle Cap; DWG. NO.; REV; SIZE; TITLE:; AutoSut NAME; DATE; COMMENTS:; MFG APPR.; ENG APPR.; CHECKED; DRAWN; Mill; Nylon 6-10; FINISH; MATERIAL; INTERPRET GEOMETRIC TOLERANCING PER:; ONE PLACE DECIMAL; TWO PLACE DECIMAL

UNLESS OTHERWISE SPECIFIED:

DIMENSIONS ARE IN INCHES
TOLERANCES:
THREE PLACE DECIMAL 0.005

## 0.144 THRU ALL

0.281 0.100

0.090 TYP; R0.016 TYP 2; Gearbox Bracket; SCALE: 2:1 WEIGHT:; DWG. NO.; REV; SIZE; TITLE:; AutoSut NAME; DATE; COMMENTS:; MFG APPR.; ENG APPR.; CHECKED; DRAWN; Mill; Nylon 6-10; FINISH; MATERIAL; INTERPRET GEOMETRIC TOLERANCING PER:; ONE PLACE DECIMAL; TWO PLACE DECIMAL

UNLESS OTHERWISE SPECIFIED:

DIMENSIONS ARE IN INCHES
TOLERANCES:
THREE PLACE DECIMAL 0.005

## 4 x 0.177 THRU ALL 0.370 X 90°

0.201 THRU ALL; Mounting Plate; SCALE: 1:2 WEIGHT:; DWG. NO.; REV; SIZE; TITLE:; AutoSut NAME; DATE; COMMENTS:; MFG APPR.; ENG APPR.; CHECKED; DRAWN; Mill; Nylon 6-10; FINISH; MATERIAL; INTERPRET GEOMETRIC TOLERANCING PER:; ONE PLACE DECIMAL; TWO PLACE DECIMAL

UNLESS OTHERWISE SPECIFIED:

DIMENSIONS ARE IN INCHES
TOLERANCES:
THREE PLACE DECIMAL 0.005

## 4 x 0.129 THRU ALL 0.219 0.112

0.875 THRU ALL; TYP 2; Mount Base; DWG. NO.; REV; SIZE; TITLE:; AutoSut NAME; DATE; COMMENTS:; MFG APPR.; ENG APPR.; CHECKED; DRAWN; Mill; Nylon; FINISH; MATERIAL; INTERPRET GEOMETRIC TOLERANCING PER:; ONE PLACE DECIMAL; TWO PLACE DECIMAL

0.159 THRU ALL
10-32 UNF THRU ALL

UNLESS OTHERWISE SPECIFIED:

DIMENSIONS ARE IN INCHES
TOLERANCES:
THREE PLACE DECIMAL 0.005

4 x | 0.070 0.260
2-56 UNC | 0.170

4-40 UNC; Gear Plate; DWG. NO.; REV; SIZE; TITLE:; AutoSut NAME; DATE; COMMENTS:; MFG APPR.; ENG APPR.; CHECKED; DRAWN; Mill; Aluminum; FINISH; MATERIAL; INTERPRET GEOMETRIC TOLERANCING PER:; ONE PLACE DECIMAL; TWO PLACE DECIMAL

UNLESS OTHERWISE SPECIFIED:

DIMENSIONS ARE IN INCHES
TOLERANCES:
THREE PLACE DECIMAL 0.005
