karldprice/M_Dsgn/Final/_DRW/6-OuterRollBlock.PDF

0.129 THRU ALL; 0.875 THRU ALL; TYP 2; Mount Base; SHEET 1 OF 1; SCALE: 1:1 WEIGHT:; DWG. NO.; REV; AutoSut NAME; DATE; MFG APPR.; ENG APPR.; INTERPRET GEOMETRIC TOLERANCING PER:; ONE PLACE DECIMAL; TWO PLACE DECIMAL

0.159 THRU ALL
10-32 UNF THRU ALL

UNLESS OTHERWISE SPECIFIED:

DIMENSIONS ARE IN INCHES
TOLERANCES:
THREE PLACE DECIMAL 0.005

DO NOT SCALE DRAWING
