karldprice/M_Dsgn/Final/_DRW/4-GearBoxBracket.PDF

0.090 TYP; 0.144 THRU ALL 0.281 0.100; TYP 2; Gearbox Bracket; SHEET 1 OF 1; SCALE: 2:1 WEIGHT:; DWG. NO.; REV; AutoSut NAME; DATE; MFG APPR.; ENG APPR.; Nylon 6-10; INTERPRET GEOMETRIC TOLERANCING PER:; ONE PLACE DECIMAL; TWO PLACE DECIMAL

UNLESS OTHERWISE SPECIFIED:

DIMENSIONS ARE IN INCHES
TOLERANCES:
THREE PLACE DECIMAL 0.005

DO NOT SCALE DRAWING
