karldprice/M_Dsgn/Stock_Parts/Gears/Outter_Roll_v2/ENG_CD_5205208_A.pdf

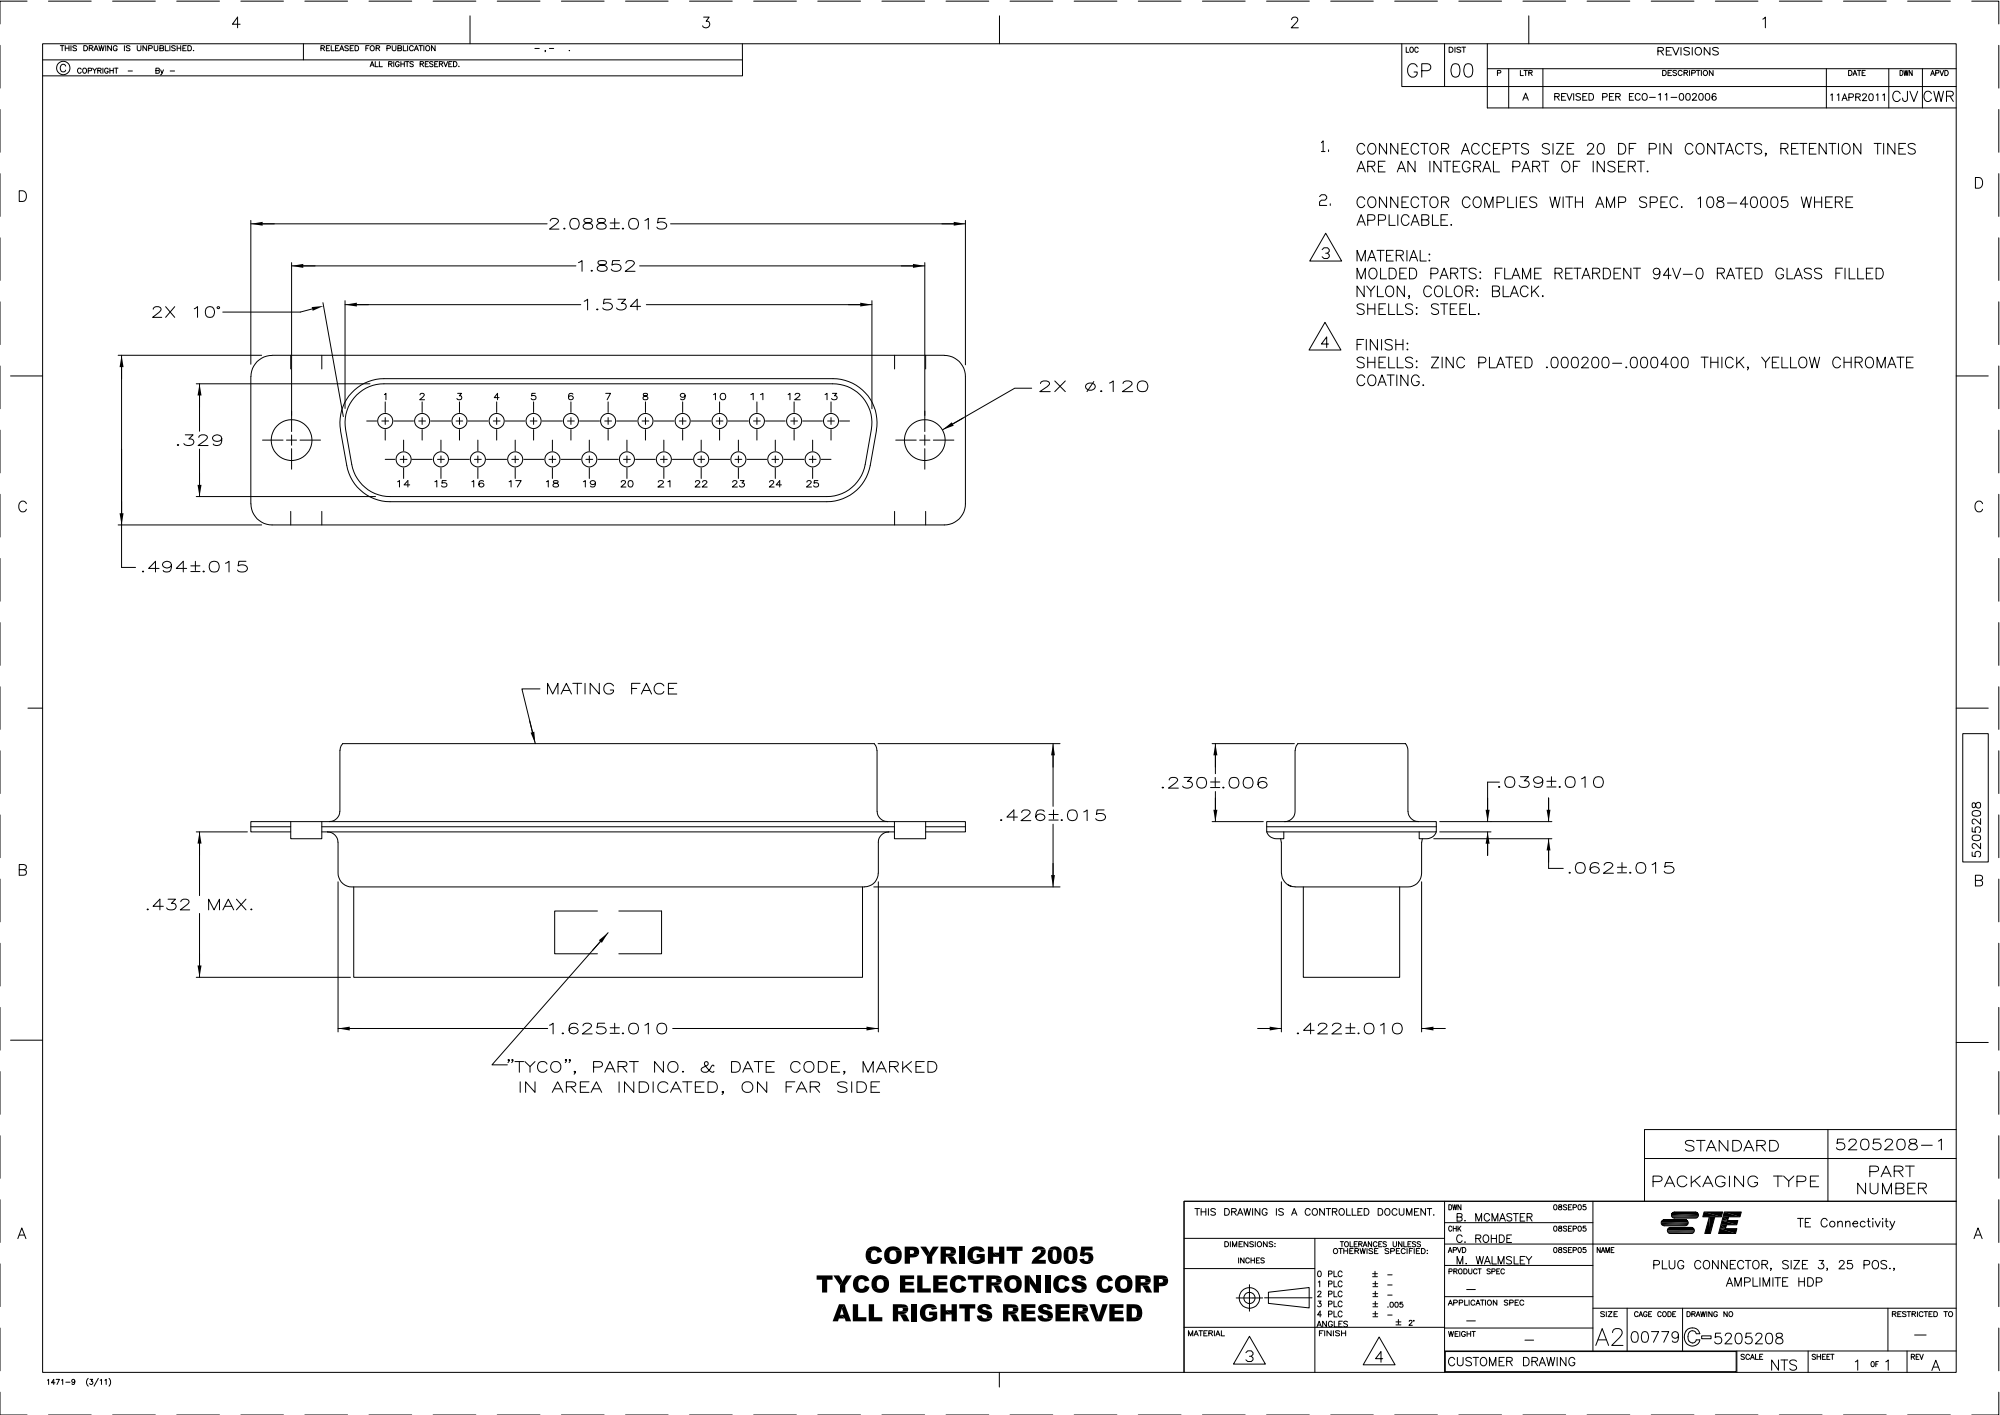
[picture p122: page 1]
