karldprice/M_Dsgn/SurgicalPCB/SurgicalPCB.brd

## EAGLE design SurgicalPCB/SurgicalPCB.brd (2013-04-13)

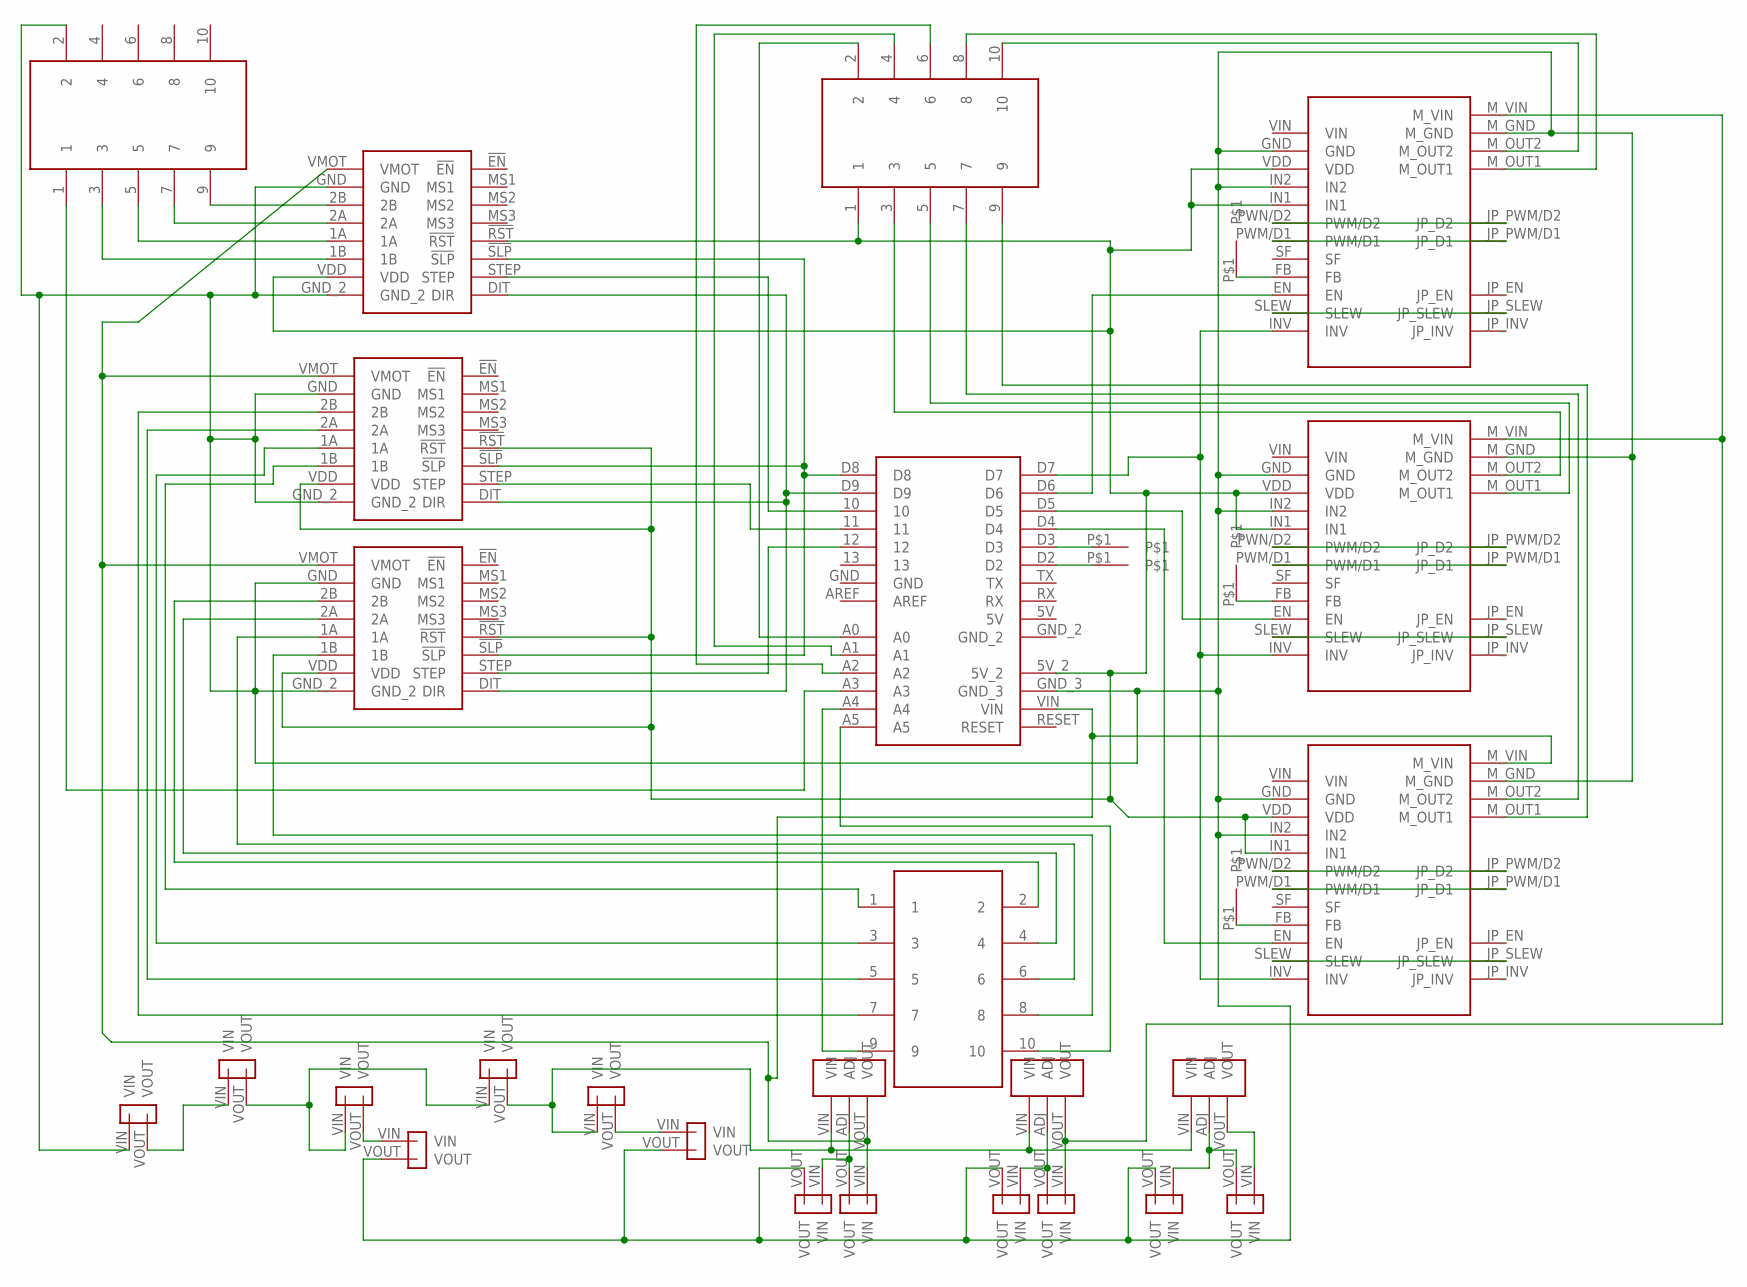
[picture p123: schematic SurgicalPCB.sch]

Parts:
6V, 10V: V_REG
EV: V_REG
E_STOP: RESISTOR
LED_GREEN: RESISTOR
LED_R: RESISTOR
LED_RES: RESISTOR
LED_RES_G: RESISTOR
POWERPLUG: RESISTOR
POWER_SWITCH: RESISTOR
RES6-1: RESISTOR
RES_6-2, RES_10-1, RES_10-2: RESISTOR
RES_EV-1, RES_EV-2: RESISTOR
U$1, U$2, U$3: A4955
U$4: BOARDUINOSTD; BOARDUINO
U$5, U$6, U$7: MC33926
U$8, U$9, U$10: 2_5_RIBBON
U$14, U$23, U$24, U$25, U$26: PROPE_HOLE

Connections:
6V_RAIL: 6V.VOUT, RES6-1.VIN, U$5.M_VIN, U$6.M_VIN
10V_RAIL: 10V.VOUT, RES_10-1.VIN, U$1.VMOT, U$2.VMOT, U$3.VMOT, U$4.VIN, U$7.M_VIN
24V_1: POWERPLUG.VOUT, POWER_SWITCH.VIN
24V_2: E_STOP.VIN, LED_RES.VIN, POWER_SWITCH.VOUT
24V_3: LED_R.VIN, LED_RES.VOUT
24V_4: 6V.VIN, 10V.VIN, EV.VIN, E_STOP.VOUT, LED_RES_G.VIN
24V_5: LED_GREEN.VIN, LED_RES_G.VOUT
GND: LED_GREEN.VOUT, LED_R.VOUT, POWERPLUG.VIN, RES_6-2.VOUT, RES_10-2.VOUT, RES_EV-2.VOUT, U$1.GND, U$1.GND_2, U$2.GND, U$2.GND_2, U$3.GND, U$3.GND_2, U$4.GND_3, U$5.GND, U$5.IN2, U$5.M_GND, U$6.GND, U$6.IN2, U$6.M_GND, U$7.GND, U$7.IN2, U$7.M_GND, U$9.2
LOGIC_HIGH_RAIL: U$1.!RST, U$1.VDD, U$2.!RST, U$2.VDD, U$3.!RST, U$3.VDD, U$4.5V_2, U$5.IN1, U$5.VDD, U$6.IN1, U$6.VDD, U$7.IN1, U$7.VDD, U$8.1
unnamed: U$3.STEP, U$4.12
unnamed: U$1.!SLP, U$2.!SLP, U$3.!SLP, U$4.D8
unnamed: U$1.DIT (DIR), U$2.DIT (DIR), U$3.DIT (DIR), U$4.D9
unnamed: U$1.STEP, U$4.10
unnamed: U$2.STEP, U$4.11
unnamed: U$7.FB, U$14.P$1
unnamed: U$6.FB, U$23.P$1
unnamed: U$5.JP_PWM/D2 (JP_D2), U$5.PWN/D2 (PWM/D2)
unnamed: U$5.JP_PWM/D1 (JP_D1), U$5.PWM/D1
unnamed: U$5.JP_SLEW, U$5.SLEW
unnamed: U$5.FB, U$24.P$1
unnamed: U$4.D3, U$25.P$1
unnamed: U$6.JP_PWM/D2 (JP_D2), U$6.PWN/D2 (PWM/D2)
unnamed: U$6.JP_PWM/D1 (JP_D1), U$6.PWM/D1
unnamed: U$6.JP_SLEW, U$6.SLEW
unnamed: U$4.D2, U$26.P$1
unnamed: U$7.JP_PWM/D2 (JP_D2), U$7.PWN/D2 (PWM/D2)
unnamed: U$7.JP_PWM/D1 (JP_D1), U$7.PWM/D1
unnamed: U$7.JP_SLEW, U$7.SLEW
unnamed: U$4.D7, U$5.INV, U$6.INV, U$7.INV
unnamed: U$5.M_OUT2, U$8.10
unnamed: U$4.D6, U$5.EN
unnamed: U$4.D5, U$6.EN
unnamed: U$4.D4, U$7.EN
unnamed: U$5.M_OUT1, U$8.8
unnamed: U$6.M_OUT2, U$8.3
unnamed: U$6.M_OUT1, U$8.5
unnamed: U$7.M_OUT2, U$8.7
unnamed: U$7.M_OUT1, U$8.9
unnamed: U$4.A2, U$8.6
unnamed: U$4.A1, U$8.4
unnamed: U$4.A0, U$8.2
unnamed: U$3.2B, U$10.2
unnamed: U$3.2A, U$10.4
unnamed: U$3.1A, U$10.6
unnamed: U$3.1B, U$10.8
unnamed: U$4.A5, U$10.10
unnamed: U$2.1B, U$10.1
unnamed: U$2.1A, U$10.3
unnamed: U$2.2A, U$10.5
unnamed: U$2.2B, U$10.7
unnamed: U$4.A4, U$10.9
unnamed: U$1.2B, U$9.9
unnamed: U$1.2A, U$9.7
unnamed: U$1.1A, U$9.5
unnamed: U$1.1B, U$9.3
unnamed: U$4.A3, U$9.1
unnamed: 10V.ADJ, RES_10-1.VOUT, RES_10-2.VIN
unnamed: 6V.ADJ, RES6-1.VOUT, RES_6-2.VIN
unnamed: EV.VOUT, RES_EV-1.VIN
unnamed: EV.ADJ, RES_EV-1.VOUT, RES_EV-2.VIN

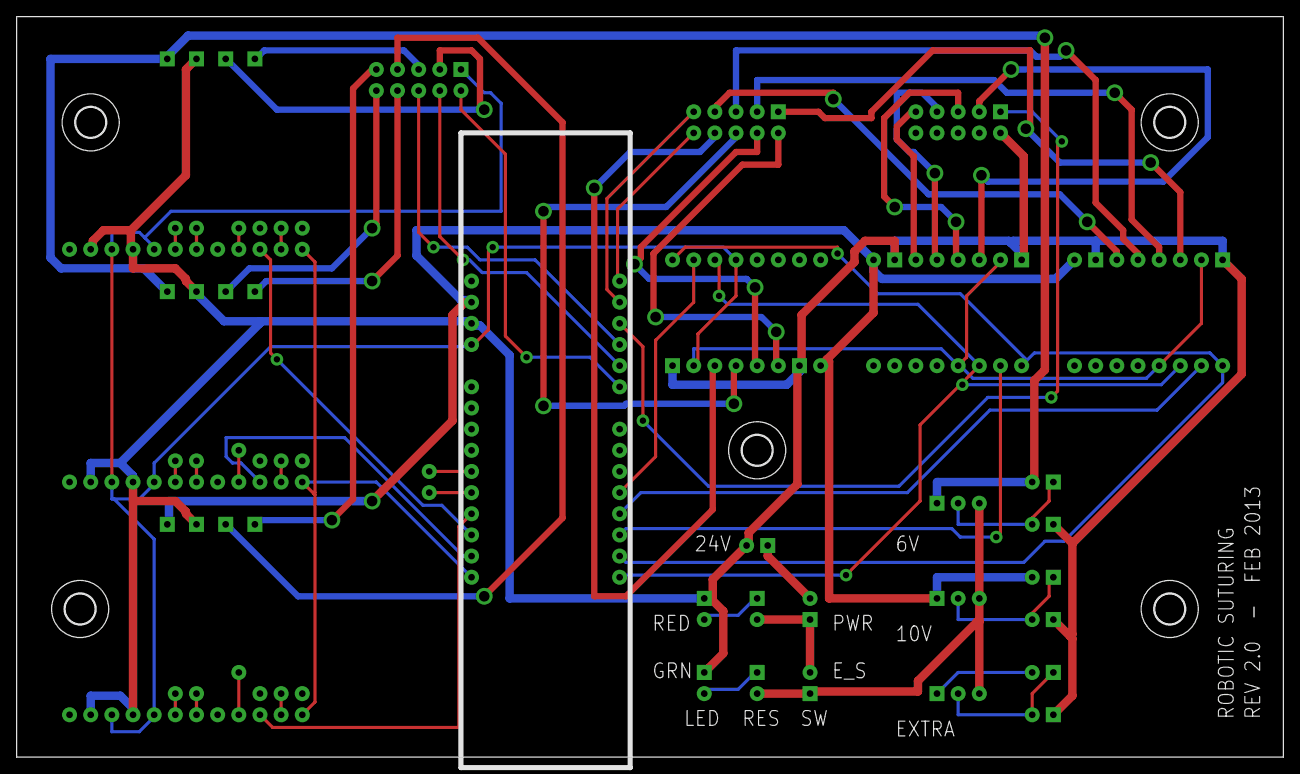
[picture p124: board SurgicalPCB.brd from above]

Board: 2 copper layers, 152.1 x 88.9 mm, 36 parts (0 on the bottom side), 60 nets.

Other parts of the board:
U$11, U$13, U$15, U$16, U$17: 3,6
