karldprice/M_Dsgn/(commit log)

2012-10-12 Setup directory structure
    [Ball_Bearing_6383K120.SLDPRT, Pitch_Actuation.SLDASM, bracket.SLDPRT, collar.SLDPRT, shaft.SLDPRT, stepper_motor_20mm.SLDPRT, stepper_motor_35mm.SLDPRT]
2012-10-12 Added datasheets for the motors
    [Ball_Bearing_mc_6383K120.SLDPRT, stepper_motor_20mm_DK_P14334-ND.SLDPRT, stepper_motor_35mm_DK_P14336-ND.SLDPRT]
2012-10-12 Added gears to pitch
    [Pitch_Actuation.SLDASM, bracket.SLDPRT, gear_d0_5_SP_32-014B156.SLDPRT, gear_d1_688_SP_32-052B313.SLDPRT]
2012-10-17 brock init
    [EnclosureBottom.SLDPRT, Gearbox.SLDPRT, GripperBase.SLDASM, JawShaft.SLDPRT, L16_50mm.SLDPRT, L16_50mm.igs, Shaft.SLDPRT, ShaftGuide.SLDPRT]
2012-10-17 design1 added
    [EnclosureBottom.SLDPRT, Gearbox.SLDPRT, GripperBase.SLDASM, JawShaft.SLDPRT, L16_50mm.SLDPRT, L16_50mm.igs, Shaft.SLDPRT, ShaftGuide.SLDPRT]
2012-10-17 Created baseplate and added to pitch assembly
    [Pitch_Actuation.SLDASM, baseplate.SLDPRT, shaft_of_karl.SLDPRT]
2012-10-17 Added holes to bracket
    [bracket.SLDPRT]
2012-10-17 Shortened my shaft
    [shaft_of_karl.SLDPRT]
2012-10-17 Added shaft guide slots
    [ShaftGuide.SLDPRT, ShaftGuideTop.SLDPRT]
2012-10-17 Added pitch to master
    [GripperBase.SLDASM, Pitch_Actuation.SLDASM, bracket.SLDPRT, collar.SLDPRT, shaft_of_karl.SLDPRT]
2012-10-17 renamed shaft
    [GripperBase.SLDASM, Shaft.SLDPRT, ToolShaft.SLDPRT]
2012-10-17 Moved Wire Guide
    [GripperBase.SLDASM, ShaftGuide.SLDPRT, ShaftGuideTop.SLDPRT]
2012-10-17 Shrunk Pitch Guide
    [EnclosureBottom.SLDPRT, GripperBase.SLDASM, ShaftGuide.SLDPRT, ShaftGuideTop.SLDPRT]
2012-10-17 cloned master to brock
    [EnclosureBottom.SLDPRT, GripperBase.SLDASM, PitchGuide.SLDASM, Pitch_Actuation.SLDASM, ShaftGuide.SLDPRT, ShaftGuideTop.SLDPRT, ToolShaft.SLDPRT, bracket.SLDPRT]
2012-10-18 Trying to merge
    [Pitch_Actuation.SLDASM, baseplate.SLDPRT]
2012-10-18 Brock - added plates
    [ShaftGuidePlate.SLDPRT]
2012-10-18 modified shaft guide
    [EnclosureBottom.SLDPRT, GripperBase.SLDASM]
2012-10-18 removed files
    [L16_50mm.igs]
2012-10-18 needle toggle
    [needle_toggle.SLDPRT]
2012-10-18 added pitchGuide asm
    [L16_50mm.SLDPRT, PitchGuide.SLDASM]
2012-10-18 Added room for needle toggle
    [EnclosureBottom.SLDPRT]
2012-10-18 renamed to main.sldasm
    [L16_50mm.igs, Shaft.SLDPRT, main.SLDASM]
2012-10-18 Done tonight's work
    [TogglePivotCap.SLDPRT, linear_actuator_RS_pq-12-20.SLDASM, pq-12-20_closed1.sldprt, pq-12-20_closed2.sldprt, set_screw_0_25-20_5_16_MC_92313A534.SLDPRT]
2012-10-18 updated base
    [EnclosureBottom.SLDPRT, GripperBase.SLDASM, Pitch_Actuation.SLDASM, main.SLDASM]
2012-10-26 re-sync'd brock model
    [EnclosureBottom.SLDPRT, PitchGuide.SLDASM, Pitch_Actuation.SLDASM, ShaftGuidePlate.SLDPRT, linAct_L12.SLDASM, linAct_L12_30mm.sldprt, main.SLDASM, needle_toggle.SLDPRT]
2012-10-26 Direct Grip, asm folders
    [EnclosureBottom.SLDPRT, ShaftGuidePlate.SLDPRT, linAct_L12.SLDASM, linAct_L12_30mm.sldprt, main.SLDASM, needle_toggle.SLDPRT]
2012-10-26 Built pinch actuation
    [Actuator_Pivot.SLDPRT, Linear_Actuator_Fork.SLDPRT, Pinch_Arm.SLDPRT, TogglePivotCap.SLDPRT, needle_toggle_modified.SLDPRT]
2012-10-26 Draft Version
    [Actuator_Pivot.SLDPRT, EnclosureBottom.SLDPRT, MotorBracket.SLDPRT, Pinch_Arm.SLDPRT, TogglePivotCap.SLDPRT, main.SLDASM, needle_toggle_modified.SLDPRT]
2012-10-28 relocated pitch
    [EnclosureBottom.SLDPRT, MotorBracket.SLDPRT, Pitch_Actuation.SLDASM, Pitch_Actuation2.SLDASM, actBracket.SLDPRT, baseplate.SLDPRT, baseplate2.SLDPRT, linAct_L12.SLDASM]
2012-10-28 small mods for manufacturing
    [Actuator_Pivot.SLDPRT, EnclosureBottom.SLDPRT, EnclosureBottom2-base.SLDPRT, EnclosureBottom2.SLDPRT, EnclosureBottom2_tip.SLDPRT, Gearbox.SLDPRT, JawShaft.SLDPRT, MotorBracket.SLDPRT]
2012-10-30 Working on pitch design 2
    [Assem1.SLDASM, EnclosureBottom.SLDPRT, Pitch_Actuation.SLDASM, bracket.SLDPRT, bracket_short.SLDPRT, collar.SLDPRT, shaft_of_karl.SLDPRT]
2012-10-30 Added bearing to stock parts
    [ball_bearing_05_MC_57155K358.SLDPRT, gear_d1_688_SP_32-052B313.SLDPRT, linear_actuator_RS_pq-12-20.SLDASM, pq-12-20_closed1.sldprt, stepper_motor_35mm_DK_P14336-ND.SLDPRT]
2012-10-30 Added pitch2 baseplate (quick fix)
    [Pitch_Actuation.SLDASM, baseplate2.SLDPRT, bracket_short.SLDPRT]
2012-10-30 Added pitch_2, needs modifications
    [PitchGuide.SLDASM, Pitch_Actuation.SLDASM, Pitch_Actuation2.SLDASM, Pitch_Actuation_3.SLDASM, baseplate_3.SLDPRT, bracket_3.SLDPRT, bracket_short_3.SLDPRT, collar_3.SLDPRT]
2012-10-31 Moved pitch around
    [Pitch_Actuation.SLDASM, baseplate2.SLDPRT, bracket.SLDPRT, bracket_short.SLDPRT]
2012-10-31 Split base, added asms
    [EnclosureBottom2-base.SLDPRT, EnclosureBottom2.SLDPRT, EnclosureBottom2_tip.SLDPRT, NeedleActuation.SLDASM, PitchGuide.SLDASM, RollActuation.SLDASM, ShaftGuide.SLDPRT, ShaftGuideTop.SLDPRT]
2012-10-31 Counter-bored holes on pitch plate
    [Pitch_Actuation.SLDASM, baseplate2.SLDPRT]
2012-10-31 not sure
    [Pitch_Actuation.SLDASM, baseplate2.SLDPRT]
2012-10-31 Added refined pitch act
    [Pitch_Actuation_3.SLDASM, baseplate_3.SLDPRT, bracket_3.SLDPRT]
2012-10-31 Aditted hacked pitch baseplate
    [Pitch_Actuation_3.SLDASM, baseplate_3.SLDPRT, bracket_3.SLDPRT, bracket_short_3.SLDPRT, collar_3.SLDPRT, shaft_of_karl_3.SLDPRT]
2012-10-31 Added L12 Actuator
    [linAct_L12.SLDASM, linAct_L12_30mm.sldprt]
2012-10-31 updated pitch x93209834234
    [EnclosureBottom2-base.SLDPRT, EnclosureBottom2.SLDPRT, EnclosureBottom2_tip.SLDPRT, NeedleActuation.SLDASM, PitchGuide.SLDASM, Pitch_Actuation_3.SLDASM, RollActuation.SLDASM, baseplate_3.SLDPRT]
2012-11-06 Updated motion restraints
    [EnclosureBottom2-base.SLDPRT, EnclosureBottom2_tip.SLDPRT, PitchGuide.SLDASM, ShaftGuide.SLDPRT, ShaftGuidePlate.SLDPRT, ShaftGuideTop.SLDPRT, baseplate_3.SLDPRT, main2.SLDASM]
2012-11-07 Added roll extension
    [roll_extension.SLDPRT]
2012-11-07 Added ROLL gear and shaft extension
    [gear_d0_708_SP_48-034b187.SLDPRT, roll_extension.SLDPRT]
2012-11-07 Added brackets for pitch
    [bracket_3.SLDPRT, bracket_short_3.SLDPRT]
2012-11-07 Really added pinch arm2 this time
    [Pinch_Arm2.SLDPRT]
2012-11-07 Fixed roll, sauna
    [EnclosureBottom2-base.SLDPRT, EnclosureBottom2.SLDPRT, EnclosureBottom2_tip.SLDPRT, LinActSpacer.SLDPRT, MotorBracket.SLDPRT, NeedleActuation.SLDASM, Pinch_Arm2.SLDPRT, PitchGuide.SLDASM]
2012-11-08 git Fixes
    [Actuator_Pivot.SLDPRT, Assem1.SLDASM, Mount.SLDPRT, Pinch_Arm.SLDPRT, PitchGuide.SLDASM, Pitch_Actuation.SLDASM, Pitch_Actuation2.SLDASM, Pitch_Actuation_3.SLDASM]
2012-11-08 cleanup 3
    [EnclosureBottom.SLDPRT, Gearbox.SLDPRT, JawShaft.SLDPRT, MotorBracket_V.SLDPRT, ToolShaft.SLDPRT, WireGuide.SLDPRT, actBracket.SLDPRT, linAct_L12.SLDASM]
2012-11-08 added toggle cap
    [TogglePivotCap.SLDPRT]
2012-11-08 Added bracket and model to KARL
    [Actuator_Pivot.SLDPRT, EnclosureBottom.SLDDRW, EnclosureBottom2-base.SLDPRT, EnclosureBottom2.SLDPRT, EnclosureBottom2_tip.SLDPRT, Gearbox.SLDPRT, JawShaft.SLDPRT, LinActSpacer.SLDPRT]
2012-11-09 final design of prototype #1
    [EnclosureBottom2-base.SLDPRT, EnclosureBottom2_tip.SLDPRT, Grip.SLDDRW, Needle.SLDDRW, Pitch.SLDDRW, Roll.SLDDRW, RollActuation.SLDASM, TogglePivotCap.SLDPRT]
2012-11-10 Drawings should be added by now
    [EnclosureBottom.SLDDRW, Grip.SLDDRW, Needle.SLDDRW, Pitch.SLDDRW, Roll.SLDDRW, ShaftGuide.SLDDRW, ShaftGuide.SLDPRT, ShaftGuideTop.SLDPRT]
2012-11-18 changed main2 -> main
    [main.SLDASM]
2012-11-18 Added renders for FDP
    [ShaftGuideTop.SLDPRT, baseplate_3.SLDPRT, bracket_3.SLDPRT, bracket_short_3.SLDPRT, main.SLDASM, pq-12-20_extended.igs]
2012-11-19 Pitch Renders for FDP
2012-11-27 Update PitchGuide
    [ShaftGuidePlate.SLDPRT]
2012-11-27 Switched to WireGuide
    [PitchGuide.SLDASM, ShaftGuide.SLDDRW, ShaftGuide.SLDPRT, ShaftGuideTop.SLDPRT, WireGuide.SLDPRT, WireGuideBottom.sldprt, WireGuideTop.sldprt]
2013-01-15 dropped L12
    [EnclosureBottom2-base.SLDPRT, EnclosureBottom2.SLDPRT, EnclosureBottom2_tip.SLDPRT, Gearbox.SLDPRT, JawShaft.SLDPRT, L12_linAct_Body_cust.SLDPRT, L12_linAct_Shaft_cust.SLDPRT, L12_linAct_cust.SLDASM]
2013-01-17 Created Stack Design
    [BodyPitchAssem.SLDASM, EnclosureBottom.SLDDRW, EnclosureBottom2-base.SLDPRT, EnclosureBottom2.SLDPRT, EnclosureBottom2_tip.SLDPRT, EnclosureBottom3.SLDPRT, Gearbox.SLDPRT, Grip.SLDDRW]
2013-01-17 Roll update
    [EnclosureBottom3.SLDPRT, StackMain.SLDASM]
2013-01-18 Almost ready to print
    [BodyPitchMotorAssem.SLDASM, EnclosureBottom3.SLDPRT, EnclosureCap.SLDPRT, GearboxBracket.SLDPRT, LinActBlock.SLDPRT, LinActSpacer.SLDPRT, RollActuation.SLDASM, StackMain.SLDASM]
2013-01-18 Ready for printing x1
    [BodyPitchAssem.SLDASM, EnclosureBottom3.SLDPRT, EnclosureCap.SLDPRT, GearboxBracket.SLDPRT, GuideBar.SLDPRT, LinActBlock.SLDPRT, StackMain.SLDASM, ToggleActuators.SLDASM]
2013-01-18 Removed extra files
    [EnclosureBottom.SLDDRW, EnclosureBottom2-base.SLDPRT, EnclosureBottom2.SLDPRT, EnclosureBottom2_tip.SLDPRT, Grip.SLDDRW, LinActBlock.SLDPRT, LinAct_bodyFitting.SLDPRT, LinAct_bodyFittingPin.SLDPRT]
2013-01-18 Organized Stock Parts
    [Ball_Bearing_6383K120.SLDPRT, BodyPitchAssem.SLDASM, BodyPitchMotorAssem.SLDASM, StackMain.SLDASM, ToggleActuators.SLDASM]
2013-01-18 Ready for James Print
    [RollActuation.SLDASM, StackMain.SLDASM]
2013-01-19 Added grip swivel
    [GripperAssem.SLDASM, JawShaft.SLDPRT, Nut_2-56.SLDPRT, StackMain.SLDASM, ToolShaft.SLDASM, actFitting_thrust.SLDPRT]
2013-01-19 updated gear, shaft cap
    [BodyPitchAssem.SLDASM, ShaftCap.SLDPRT, StackMain.SLDASM, gearBlock.SLDPRT, gear_pitch_AX30853.SLDPRT, pitchShaft.SLDPRT]
2013-01-19 removed bend
    [BodyPitchMotorAssem.SLDASM, GripperAssem.SLDASM, LinActBlock.SLDPRT, NeedleControlRod.SLDPRT, RollActuation.SLDASM, ShaftBar.SLDPRT, ShaftCouple.SLDPRT, StackMain.SLDASM]
2013-01-20 Added Fasteners
    [Bill of Materials.SLDDRW, BodyPitchAssem.SLDASM, BodyPitchMotorAssem.SLDASM, CapScrew_6-32x0375.SLDPRT, CapScrew_6-32x0500.SLDPRT, CapScrew_6-32x1250.SLDPRT, RollActuation.SLDASM, Screw_2-56x0375.SLDPRT]
2013-01-20 updated BoM
    [Bill of Materials.SLDDRW, GuideBar.SLDPRT, StackMain.SLDASM]
2013-01-23 width 1.700
    [EnclosureBottom3.SLDDRW, EnclosureBottom3.SLDPRT, EnclosureBottom3_175.SLDPRT, EnclosureCap.SLDDRW, EnclosureCap.SLDPRT, GearboxBracket.SLDPRT, LinActBlock.SLDDRW, LinActBlock.SLDPRT]
2013-01-24 printing gear
    [gear_m05_pd_15-SPD-S10Z05M030T0505.SLDPRT]
2013-02-03 Rev3 Update
    [BodyPitchAssem.SLDASM, BodyPitchMotorAssem.SLDASM, EnclosureBottom3.SLDDRW, EnclosureBottom3.SLDPRT, EnclosureCap.SLDPRT, EncoderMounting.SLDPRT, GearboxBracket.SLDDRW, GearboxBracket.SLDPRT]
2013-02-11 Stack V2 added
    [Bill of Materials.SLDDRW, BodyPitchAssem.SLDASM, BodyPitchMotorAssem.SLDASM, EnclosureBottom3.SLDDRW, EnclosureBottom3.SLDPRT, EnclosureBottom3_175.SLDPRT, EnclosureCap.SLDDRW, EnclosureCap.SLDPRT]
2013-02-11 new SDP gears
    [gear_p32-14_SPD-A1T2-Y32014.SLDPRT, gear_p32-52_SPD-S1084Z-032DS052.SLDPRT]
2013-02-11 Longer base, new gears
    [BodyPitchAssem.SLDASM, BodyPitchMotorAssem.SLDASM, EnclosureBottom3.SLDPRT, EnclosureCap.SLDPRT, EncoderMounting.SLDPRT, GearboxBracket.SLDPRT, GripperAssem.SLDASM, RollActuation.SLDASM]
2013-02-11 Updated pitch collars
    [BodyPitchAssem.SLDASM, EnclosureBottom3.SLDPRT, GuideBar.SLDPRT, PitchSpacer.SLDPRT, Stack_v2.SLDASM, pitchShaft.SLDPRT]
2013-02-11 Added roll2 module
    [Actuator_Pivot.SLDPRT, Assem1.SLDASM, EnclosureBottom.SLDPRT, Mount.SLDPRT, Pinch_Arm.SLDPRT, Pinch_Arm2.SLDPRT, Pitch_Actuation.SLDASM, Pitch_Actuation_3.SLDASM]
2013-02-12 new gears - pretty
    [BodyPitchAssem.SLDASM, BodyPitchMotorAssem.SLDASM, EnclosureBottom3.SLDPRT, EnclosureCap.SLDPRT, RollActuation.SLDASM, ShaftCap.SLDDRW, StackMain.SLDASM, Stack_v2.SLDASM]
2013-02-12 Finished roll2 module
    [57445K250.SLDPRT, Assem1.SLDASM, MOD_gear_sdpi_s1268z-064a064.SLDPRT, MOD_gear_sdpi_s1288z-064D064.SLDPRT, Roll2_Mount.SLDPRT, collar_mc_57445K250.SLDPRT, gear_sdpi_s1268z-064a064.SLDPRT, mounting_plate.SLDPRT]
2013-02-12 Rename Assembly
    [OuterRoll.SLDASM]
2013-02-12 Outer roll v1
    [EnclosureBottom3.SLDPRT, LinActBlock.SLDPRT, OuterRoll.SLDASM, Roll2_Mount.SLDPRT, Stack_v2.SLDASM, Stack_v2_wRoll.SLDASM, mounting_plate.SLDPRT]
2013-02-12 Brought in some new gears
    [MOD_gear_sdpi_s1268z-048a040.SLDPRT, gaer_sdpi_s1268z-048a040.SLDPRT, gear_sdpi_s1063z-048a040.SLDPRT, s1063z-048a040.stp, s1268z-048a040.stp]
2013-02-12 Added outer roll module version 2
    [MOD_gear_sdpi_s1268z-048a040.SLDPRT, OuterRoll_v2.SLDASM, Roll2_Mount.SLDPRT, SunGearMount.SLDPRT, mounting_plate.SLDPRT]
2013-02-12 Mounted motor for OuterRoll v2
    [EnclosureBottom3.SLDPRT, OuterRoll.SLDASM, Roll2_Mount.SLDPRT, RollActuation.SLDASM, Stack_v2.SLDASM, Stack_v2_wRollv1.SLDASM, mounting_plate.SLDPRT, stepper_motor_20mm.SLDPRT]
2013-02-12 Outer roll v2
    [EnclosureBottom3.SLDPRT, EncoderMounting.SLDPRT, OuterRoll_v2.SLDASM, Roll2_Mount.SLDPRT, RollActuation.SLDASM, Stack_v2.SLDASM, Stack_v2_wRollv1.SLDASM, Stack_v2_wRollv2.SLDASM]
2013-02-12 Cleanup old designs
    [Actuator_Pivot.SLDPRT, Bill of Materials.SLDDRW, BodyPitchAssem.SLDASM, BodyPitchMotorAssem.SLDASM, EnclosureBottom.SLDDRW, EnclosureBottom.SLDPRT, EnclosureBottom2-base.SLDPRT, EnclosureBottom2.SLDPRT]
2013-02-12 Cleanup 2
    [OuterRoll.SLDASM, Roll2_Mount.SLDPRT, Stack_v2_wRoll.SLDASM, mounting_plate.SLDPRT]
2013-02-13 Updated Stack v2 and deleted old files
    [BaseAssem.SLDASM, BodyPitchAssem.SLDASM, BodyPitchMotorAssem.SLDASM, EnclosureBottom3.SLDPRT, EnclosureBottom3_175.SLDPRT, EnclosureCap.SLDPRT, GearBoxAssem.SLDASM, GearboxBracket.SLDPRT]
2013-02-14 New Roll Gear
    [BaseAssem.SLDASM, EnclosureBottom3.SLDPRT, EnclosureCap.SLDPRT, GearBoxAssem.SLDASM, Gearbox.SLDPRT, OuterRoll_v2.SLDASM, RollActuation.SLDASM, RotaryEncoder_237T.SLDPRT]
2013-02-14 HDMI 1
    [hdmi_WM5715-ND.SLDPRT]
2013-02-14 Changes made on day of ordering protot #3
    [EnclosureBottom3.SLDPRT, EnclosureCap.SLDPRT, Stack_v2_new.SLDASM, Stack_v2_wRollv2.SLDASM, WireCap.SLDPRT]
2013-02-15 Final Rev pre CNC
    [BaseAssem.SLDASM, EnclosureBottom3.SLDPRT, EnclosureBottom3_CNC.SLDPRT, EnclosureCap.SLDPRT, RollActuation.SLDASM, Stack_v2_new.SLDASM]
2013-02-25 screw comments
    [Bill of Materials.SLDDRW, BodyPitchAssem.SLDASM, EnclosureCap.SLDPRT, OuterRollMotor.SLDASM, RollActuation.SLDASM, Stack_v2.SLDASM, Stack_v2_new.SLDASM, Stack_v2_wRollv2.SLDASM]
2013-03-04 Revised mouting plates
    [CapScrew_10-32x1250.SLDPRT, CapScrew_4-40x1000.SLDPRT, EnclosureBottom3.SLDDRW, EnclosureCap.SLDPRT, FlatScrew_2-56x0250.SLDPRT, MOD_93785A700.SLDPRT, MOD_gear_sdpi_s1268z-048a040.SLDPRT, OuterRoll_v2.SLDASM]
2013-03-04 revised mounting_plate
    [OuterRoll_v2.SLDASM, Roll2_Mount.SLDPRT, mounting_plate.SLDPRT]
2013-03-17 Working - pre upping currents
2013-04-07 Deleted karl
    [Actuator_Pivot.SLDPRT, Assem1.SLDASM, EnclosureBottom.SLDDRW, EnclosureBottom.SLDPRT, EnclosureBottom2-base.SLDPRT, EnclosureBottom2.SLDPRT, EnclosureBottom2_tip.SLDPRT, Gearbox.SLDPRT]
2013-04-07 Final model
    [26pos_D-SUB_609-4043-ND.SLDPRT, 36pos_D_Centronics_1036MA-ND.SLDPRT, 57445K250.SLDPRT, Ball_Bearing_AXA1221.SLDPRT, Ball_Bearing_mc_6383K120.SLDPRT, BaseAssem.SLDASM, Bill of Materials.SLDDRW, BodyPitchAssem.SLDASM]
2013-04-07 removed old
    [26pos_D-SUB_609-4043-ND.SLDPRT, 36pos_D_Centronics_1036MA-ND.SLDPRT, 57445K250.SLDPRT, Ball_Bearing_AXA1221.SLDPRT, Ball_Bearing_mc_6383K120.SLDPRT, BaseAssem.SLDASM, Bill of Materials.SLDDRW, BodyPitchAssem.SLDASM]
2013-04-07 Drawing update
    [L12_linAct.SLDASM, NeedleAssem.SLDASM, OuterRollMotor.SLDASM, OuterRoll_v2.SLDASM, PartsList.SLDDRW, PitchAssem.SLDASM, PitchMotorAssem.SLDASM, Stack_v2.SLDASM]
2013-04-13 Added reports, PCB
    [SurgicalPCB.brd, SurgicalPCB.sch, SurgicalPCB_bare.brd, SurgicalPCB_trace.brd]
2013-04-13 removed extra assemblies
    [Stack_v2_new.SLDASM, Stack_v2_wRollv2.SLDASM]
